flamaque/ANE21_PCB/USB hub van schematic.docx

USB hub van schematic

FSUSB42MUX (https://www.onsemi.com/download/data-sheet/pdf/fsusb42-d.pdf)

Low-Power, Two-Port, High-Speed, USB2.0 (480Mbps) UART Switch

USB2514B-I/M2 (https://ww1.microchip.com/downloads/aemDocuments/documents/UNG/ProductDocuments/DataSheets/USB251xB-xBi-Data-Sheet-DS00001692.pdf)

USB 2.0 Hi-Speed Hub Controller

Abriviations:

HDx_P/HDx_N: (USBDM_DNx/USBDP_DNx) Hi-Speed USB Data

USBDM_UP/USBDP_UP: USB Bus Data (30/31)

XTALIN/XTALOUT: Crystal Input/Output (33/32)

VBUS_DET: Upstream VBUS Power Detection (27)

SUSP_IND: Active/Suspend Status Indicator (28)

HS_IND: Hi-Speed Upstream Port Indicator (25)

SMBDATA: (SDA) System Management Bus Data Signal (22)

SMBCLK: (SCL) System Management Bus Clock (24)

OCS: Over-Current sense (13/17/19/21)

RBIAS: USB Transceiver Bias (35)

Not connected

CRFILT: Core Regulator Filter Capacitor (14)

PLLFILT: PLL Regulator Filter Capacitor (34)

Test: Test pin (11)

BC_EN: Battery charging (12/16/18/20)

RBIAS (https://ww1.microchip.com/downloads/aemDocuments/documents/UNG/ProductDocuments/DataSheets/USB251xB-xBi-Data-Sheet-DS00001692.pdf):

Buffer type: I-R

USB Transceiver Bias: a 12.0 k (+/- 1%) resistor is attached from ground to this

pin to set the transceiver’s internal bias settings.

SCL/CFG_SEL0/SMBCLK

Buffer type: I/OSD12

Configuration Select: the logic state of this multifunction pin is internally latched on the rising edge of RESET_N (RESET_N negation), and will determine the hub configuration method as described in Table 5-1.

SDA/SMBDATA/NON_REM1

Buffer type: I/OSD12

Non-Removable Port 1 Strap Option: when enabled by package and configuration options (see Table 5-1 on page 19), this pin will be sampled (in conjunction with

LOCAL_PWR/SUSP_IND/NON_REM0) at RESET_N negation to determine if ports [x:1] contain permanently attached (non-removable) devices:

NON_REM[1:0] = 00 : all ports are removable

NON_REM[1:0] = 01 : port 1 is non-removable

NON_REM[1:0] = 10 : ports 1 and 2 are non-removable

NON_REM[1:0] = 11 : when available, ports 1, 2, and 3 are non-removable

When NON_REM[1:0] is chosen such that there is a non-removable device, the hub will automatically report itself as a compound device (using the proper descriptors).

SUSP_IND/ LOCAL_PWR/ NON_REM0

Buffer type: IO

Active/Suspend Status LED: indicates USB state of the hub.

Negated = unconfigured; or configured and in USB suspend

Asserted = hub is configured and is active (i.e., not in suspend)

Local Power: detects availability of local self-power source.

Low = self/local power source is NOT available (i.e., the hub gets all power from

the upstream USB VBus)

High = self/local power source is available

Non-Removable 0 Strap Option: when enabled by package and configuration

settings (see Table 5-1 on page 19), this pin will be sampled (in conjunction with

NON_REM[1]) at RESET_N negation to determine if ports [x:1] contain

permanently attached (non-removable) devices:

Note: When implementing an external LED on this pin, the active state is

outlined below and detailed in Section 3.3.1.3, on page 15.

NON_REM[1:0] = 00 : all ports are removable; LED is active high

NON_REM[1:0] = 01 : port 1 is non-removable; LED is active low

NON_REM[1:0] = 10 : ports 1 and 2 are non-removable; LED is active high

NON_REM[1:0] = 11 : (when available) ports 1, 2, and 3 are non-removable; LED

is active low

HS_IND/ CFG_SEL1

Buffer type: I/O12

TPD4EUSB30 (https://www.ti.com/lit/ds/symlink/tpd2eusb30.pdf)

4-Channel ESD Protection for Super-Speed USB 3.0 Interface

AP22653W6 (https://www.diodes.com/datasheet/download/AP22652_AP22653_AP22652A_AP22653A.pdf)

PRECISION ADJUSTABLE CURRENT-LIMITED POWER SWITCHES
