flamaque/ANE21_PCB/ANE21_PCB.docx

Taken:

- PSU voor CM4 vervangen van AP62300WU-7 vervangen met AP64501S-13
- GPIO’s uitzoeken
  - GPIO’s naar header zetten
  - Evt 5v en 3.3v output als header
- Schema en uitleg over ieder circuit dat er in zit
- Nalopen traces (incl. Kennis)
- “lage” signaal pinnen op onderkant zetten

Eventueel:

- USB-C for usb devices, dongle and OTG

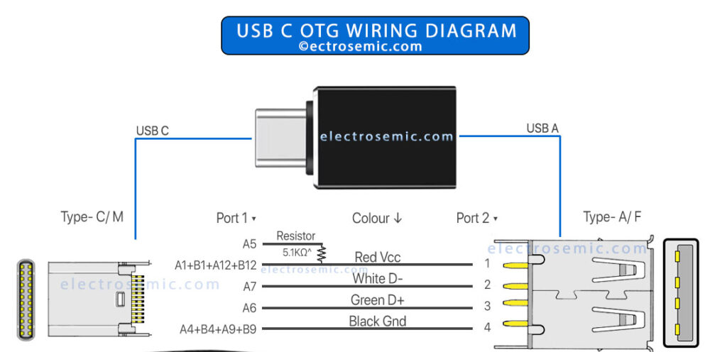
[picture p1: figure]
USB C OTG Wiring Diagram For Cable, Schematic, DIY & Manufacturing -

Update 09/03/2026

- Placed testpoints
- Added header for UART (GPIO 14 and 15)`
- Removed all via’s placed on pads`

Diferential Pair (DP)

1) 6 → Per 45°, houd de lengte van de paren zo gelijk mogelijk
2) Tune DP, match met de langste (Zie eerst welke de langste is)
3) Tune skew of DP`

Click on two places of trace. → Exit → double click: tadaa settings

Aisler

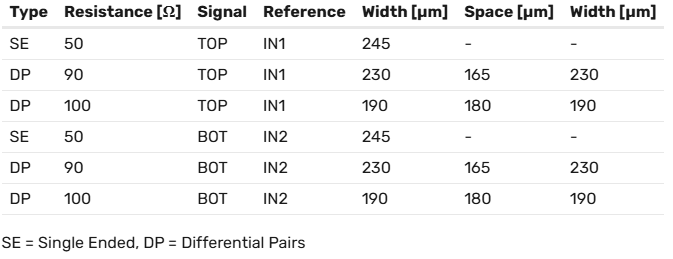
[picture p2: figure]

In KiCad, the difference between coplanar and non-coplanar (often called microstrip or stripline) refers to how a signal trace is referenced to its ground return path regarding their physical plane on the PCB. This distinction is crucial for controlling signal integrity and impedance.

Coplanar (GCPW - Grounded Coplanar Waveguide)

- Definition: The signal trace and its ground reference are on the same layer (e.g., Top Layer).
- Structure: Signal traces are surrounded by a ground pour (GND) on the same layer, providing a "co-planar" return path.
- Use Case: Often used for high-frequency (RF) signals, allowing for better shielding and lower radiation.
- KiCad Calculation: Requires inputting the gap between the trace and the adjacent ground pour.
- Advantage: Can result in narrower traces for the same impedance compared to standard microstrip.

Non-Coplanar (Microstrip/Stripline)

- Definition: The signal trace is on one layer, and its ground reference is on a different layer (usually the layer immediately below).
- Structure: No ground copper is present on the same layer as the signal, or the nearby copper is too far away to act as a primary reference.
- Use Case: Standard differential pair routing for digital signals (USB, Ethernet).
- KiCad Calculation: Uses the distance to the plane below (dielectric thickness).
- Advantage: Easier to calculate and manage, standard design approach.

Summary Table

Feature Coplanar (GCPW) Non-Coplanar (Microstrip)

Ground Location Same Layer as Signal Different Layer (Below)

Primary EMI Defense Coplanar Pour + Vias Ground Plane Below

Impedance Setting Cntrld by Gap to Copper Cntrld by Distance to Plane (H)

Typical Usage High-Frequency RF General High-Speed Digital

KiCad Calculator "Coplanar Waveguide" "Microstrip" or "Stripline"

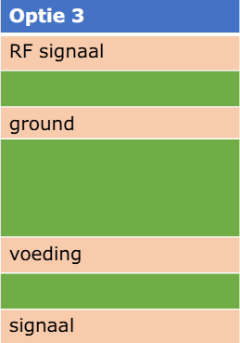
[picture p3: figure]

Keuze voor PCB:
Max 10x10 cm

De PCB bevat minaal:

1. een enkele USB 2.0 poort;

2. een HDMI interface;

3. een NVME Key-M interface.

4. een 5/3.3V DC-DC converter;

5. een manier om te verbinden met de TX, RX pinnen;

6. test points voor tenminste de RUN_PG en LED_nACT pinnen.

7. USB OTG (Als je je eigen CM4 wilt gebruiken)

8. USB C poort

9. Aan/uit knop

10. Fan

Optioneel:

Hardwarematig debugging LED

Ethernet

Scherm (evt touchscreen)

Extra usb poort (of 2 stacked usb) (USB-hub FSUSB42MUX)

Speaker

Audio output

CM4 datasheet (https://pip-assets.raspberrypi.com/categories/634-raspberry-pi-compute-module-4/documents/RP-008168-DS-1-cm4-datasheet.pdf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)

CM4 BOM (https://bytebucket.org/HR_ELEKTRO/ane21/wiki/bestanden/CM4_BOM.pdf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)

Punten verdeling:

• 9 punten voor de realisatie (werkt het pcb?)

• 9 punten voor het high-speed PCB-ontwerp

• 4 punten voor het overige PCB-ontwerp

• 3 punten voor de opzet van het schema

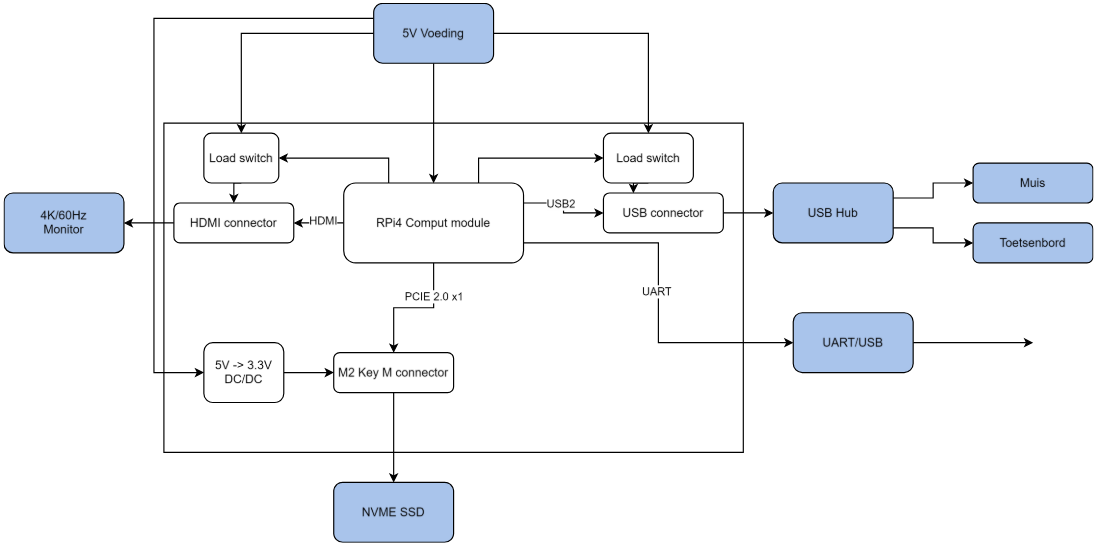
[picture p4: figure]

# Pin definitions per unit

Pinnen: (aantal)

HDMI 12

NVME Key-M 8

USB 2

USB-OTG 2

USB-C x

Overig:

Ethernet 13

14 volgens officiele schematic

TRD0_N / TRD0_P + TRD0_TAP (0 t/m 3) + ETH_LEDG + ETH_LEDY → 14 pins

Component | Aantal | Spanning | Stroom | GPIO | Snelheid
USB 2.0 | 1 | 5v | 500 mA | 2
HDMI | 1 | 5v | N.v.t. | 12
NVME | 1 | 3.3v | 3.3A | 8
USB OTG | 1 | 5v | 500 mA | 2
USB C | 1 | 5v / 20v / 48v | 3A / 5A | N.t.b.
~~Ethernet~~ | ~~1~~ | ~~3.3v (+1/1.2v)~~ | ~~250mA~~ | ~~13~~
CM4 | 1 | 5v | 1.4A | -

Houd pin #93 beschikbaar (nRPIBOOT)

### Voeding

AP62300WU-7 (https://www.diodes.com/assets/Datasheets/AP62300_AP62301_AP62300T.pdf) wordt geleverd door school voor de SSD

AP64501SP-13 (https://www.diodes.com/assets/Datasheets/AP64501.pdf) halen we voor de CM4 voeding

USB / USB_OTG (2.4. USB 2.0 (high speed) datasheet (https://pip-assets.raspberrypi.com/categories/634-raspberry-pi-compute-module-4/documents/RP-008168-DS-1-cm4-datasheet.pdf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))

Name | Pin (CM4) | Pin (connector) | Function
USB_OTG_ID | 101
USBD- | 104
USBD+ | 105
+5v | -
GND | -

Short Pin #4 to Pin #5 (ID/Sense to GND) for OTG

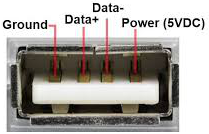
[picture p5: figure]
USB 3.0 Information
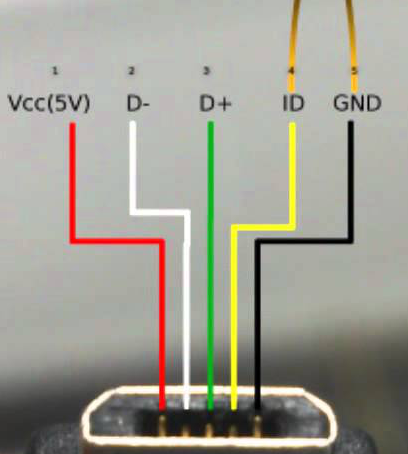
[picture p6: figure]
What is Micro USB OTG (On-The-Go)? Build DIY OTG Cable

HDMI (2.6. Dual HDMI 2.0 in datasheet) (https://pip-assets.raspberrypi.com/categories/634-raspberry-pi-compute-module-4/documents/RP-008168-DS-1-cm4-datasheet.pdf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)

Name | Pin (CM4) | Pin (connector) | Function
HDMI0_D2P | 170 (als P=TX) | 1
HDMI0_D2N | 172 | 3
HDMI0_D1P | 176 | 4
HDMI0_D1N | 178 | 6
HDMI0_D0P | 182 | 7
HDMI0_D0N | 184 | 9
HDMI0_CKP | 180 | 10
HDMI0_CKN | 190 | 12
HDMI0_CEC | 151 | 13
HDMI0_SDA | 199 | 16
HDMI0_SCL | 200 | 15
HDMI0_HOTP | 153 | 19
GND | - | 17
+5v | | 18

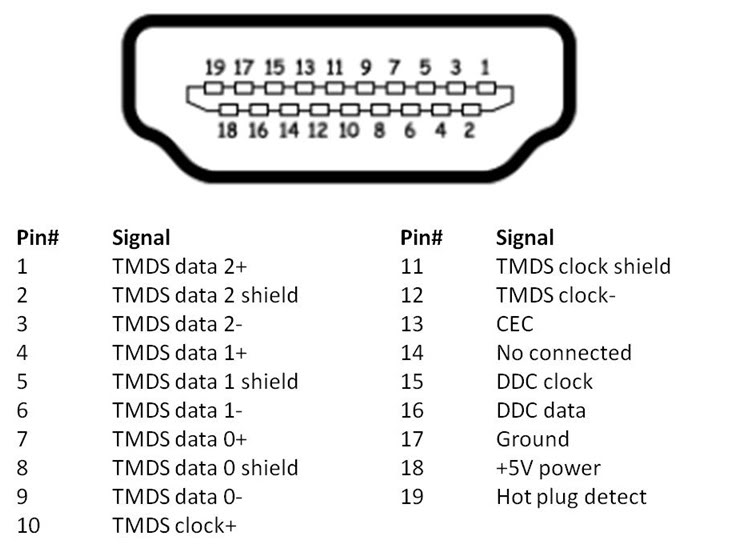
[picture p7: figure]
Does HDMI 2.0 Support 1080p 120Hz? Addressing HDMI Questions ...

NVME (2.3. PCIe (Gen2 x1) Datasheet (https://pip-assets.raspberrypi.com/categories/634-raspberry-pi-compute-module-4/documents/RP-008168-DS-1-cm4-datasheet.pdf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))

Footprint “TE_1-2199119-5” heeft 75 pinnen. Symbol heeft er 36

Gezien de 75 pinnen in de footprint heb ik het schema gebasseerd op de:

Website (https://www.congatec.com/fileadmin/user_upload/Documents/Application_Notes/AN43_M.2_Pinout_Descriptions_and_Reference_Designs.pdf)

(M.2 Connector Pinout (75 Positions))

Name | Pin (CM4) | Pin (connector) | Function
PETn3
PETp3
PERn3
PERp3
PETn2
PETp2
PERn2
PERp2
PETn1
PETp1
PERn1
PERp1
PETn0 | 122 (kicad)
PETp0 | 124 (kicad)
PERn0 | 116 (kicad)
PERp0 | 118 (kicad)
PERST# | 109 (ds)
CLKREQ# | 102 (ds)
REFCLKn | 112 (ds)
PEWWAKE#
REFCLKp | 110 (ds)
INDI LED | 10 (ds)
MFG_DATA
MFG_CLOCK
SUSCLK
PEDET
GND | | 1,3,9,15,21,27,33, 39,45,51,57,71,73,75
3.3v | | 2,4,12,14,16,18,70,72,74
NC | | 6,8,20,22,24,26,28,30,32, 34,36,46,48,56,58,67
NOTCH | | 59-66

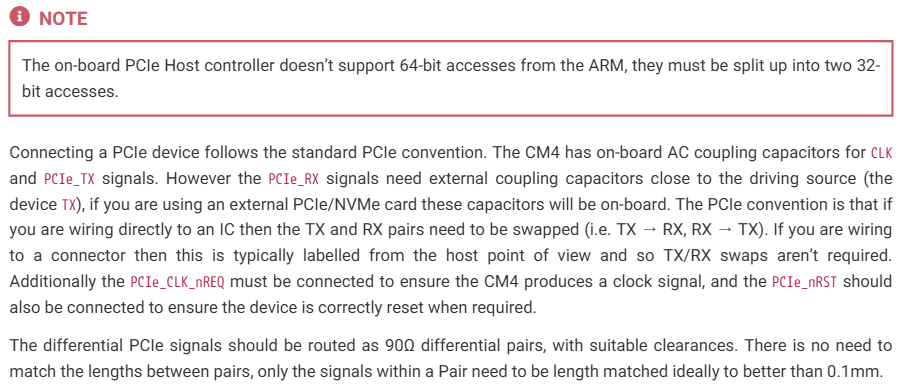
[picture p8: figure]

Ethernet (2.2. Ethernet Datasheet) (https://pip-assets.raspberrypi.com/categories/634-raspberry-pi-compute-module-4/documents/RP-008168-DS-1-cm4-datasheet.pdf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)

Name | Pin (CM4) | Pin (connector) | Function
Ethernet_P3P | 3 | 1
Ethernet_P1P | 4 | 2
Ethernet_P3N | 5 | 3
Ethernet_P1N | 6 | 6
Ethernet_P2N | 9 | 7
Ethernet_P0N | 10 | 8
Ethernet_P2P | 11 | 9
Ethernet_P0P | 12 | 10
Ethernet_LED3 | 15 | 16
Ethernet_SyncIn | 16 | -
Ethernet_LED2 | 17 | 18
Ethernet_SyncOut | 18 | -
Ethernet_LED1 | 19 | -

### USB-C

PD trigger IC

TPS25730D

https://www.ti.com/lit/ds/symlink/tps25730.pdf

# Pinout table

Tabel gebasseerd op wat wij moeten plaatsen:

Chapter 4. Pinout (https://pip-assets.raspberrypi.com/categories/634-raspberry-pi-compute-module-4/documents/RP-008168-DS-1-cm4-datasheet.pdf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)

Pin | | | Signal
1,2,7,8,13,14,22,23,32,33,42,43,52,53,59,60,65,66,71,74,98,107,108,113, 114,119,120, 125,126,131,132,137,138,144,150,155,156,161,162,167, 168,173,174,179,180,185,186,191,192,197,198 | | | GND
Pin | Signal | Pin | Signal
20 | EEPROM_nWP | 84,86 | CM4_3.3V (output)
21 | Pi_nLED_Activity | 88,90 | CM4_1.8V (output)
24 | GPIO26 | 89 | WL_nDisable
25 | GPIO21 | 92 | RUN_PG
26 | GPIO19 | 93 | nRPIBOOT
27 | GPIO20 | 94 | AnalogIP1
28 | GPIO13 | 95 | PI_LED_nPWR
29 | GPIO16 | 96 | AnalogIP0
30 | GPIO6 | 97 | Camera_GPIO
31 | GPIO12 | 99 | GLOBAL_EN
34 | GPIO5 | 100 | nEXTRST
35,36 | ID_SC / ID_SD | 101 | USB_OTG_ID
37 | GPIO7 | 102 | PCIe_CLK_nREQ
38 | GPIO11 | 103 | USB_N
39 | GPIO8 | 105 | USB_P
40 | GPIO9 | 109 | PCIe_nRST
41 | GPIO25 | 110 | PCIe_CLK_P
44 | GPIO10 | 111 | VDAC_COMP
45 | GPIO24 | 112 | PCIe_CLK_N
46 | GPIO22 | 116 | PCIe_RX_P
47 | GPIO23 | 118 | PCIe_RX_N
48 | GPIO27 | 122 | PCIe_TX_P
49 | GPIO18 | 124 | PCIe_TX_N
50 | GPIO17 | 151 | HDMI0_CEC
51 | GPIO15 | 153 | HDMI0_HOTPLUG
54 | GPIO4 | 170 | HDMI0_TX2_P
55 | GPIO14 | 172 | HDMI0_TX2_N
56 | GPIO3 | 176 | HDMI0_TX1_P
58 | GPIO4 | 178 | HDMI0_TX1_N
77,79,81,83,85,87 | +5V (input) | 182 | HDMI0_TX0_P
78 | GPIO_VREF (Can’t be floating) | 184 | HDMI0_TX0_N
80 | SCL0 | 188 | HDMI0_CLK_P
82 | SDA0 | 190 | HDMI0_CLK_N
| | 199,200 | HDMI0 (SDA, SCL)

Chapter 4. Pinout (https://pip-assets.raspberrypi.com/categories/634-raspberry-pi-compute-module-4/documents/RP-008168-DS-1-cm4-datasheet.pdf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)

Pin | Signal
1, 2 | GND
3, 4 | Ethernet_P (3, 1)
5, 6 | Ethernet_N (3, 1)
7,8 | GND
9,10 | Ethernet_N (2, 0)
11,12 | Ethernet_P (2, 0)
13,14 | FND
15 | Ethernet_nLED3
16 | Ethernet_SYNC_IN
17 | Ethernet_nLED2
18 | Ethernet_SYNC_OUT
19 | Ethernet_nLED1
20 | EEPROM_nWP
21 | Pi_nLED_Activity
22,23 | GND
24 | GPIO26
25 | GPIO21
26 | GPIO19
27 | GPIO20
28 | GPIO13
29 | GPIO16
30 | GPIO6
31 | GPIO12
32,33 | GND
34 | GPIO5
35,36 | ID_SC / ID_SD
37 | GPIO7
38 | GPIO11
39 | GPIO8
40 | GPIO9
41 | GPIO25
42,43 | GND
44 | GPIO10
45 | GPIO24
46 | GPIO22
47 | GPIO23
48 | GPIO27
49 | GPIO18
50 | GPIO17
51 | GPIO15
52,53 | GND
54 | GPIO4
55 | GPIO14
56 | GPIO3
57 | SD_CLK
58 | GPIO4
59,60 | GND
61-64 | Only CM4Lite
65,66 | GND
67-70 | Only CM4Lite
71 | GND
72 | Only CM4Lite
73 | SD_VDD_OVERRIDE
74 | GND
75 | Only CM4Lite
76 | Reserverd
77 | +5V (input)
78 | GPIO_VREF
79 | +5V (input)
80 | SCL0
81 | +5V (input)
82 | SDA0
83 | +5V (input)
84 | CM4_3.3V (output)
85 | +5V (input)
86 | CM4_3.3V (output)
87 | +5V (input)
88 | CM4_1.8V (output)
89 | WL_nDisable
90 | CM41.8V (output)
91 | Bt_nDisable
92 | RUN_PG
93 | nRPIBOOT
94 | AnalogIP1
95 | PI_LED_nPWR
96 | AnalogIP0
97 | Camera_GPIO
98 | GND
99 | GLOBAL_EN
100 | nEXTRST
101 | USB_OTG_ID
102 | PCIe_CLK_nREQ
103 | USB_N
104 | Reserved
105 | USB_P
106 | Reserved
107,108 | GND
109 | PCIe_nRST
110 | PCIe_CLK_P
111 | VDAC_COMP
112 | PCIe_CLK_N
113,114 | GND
115 | CAM1_D0_N
116 | PCIe_RX_P
117 | CAM1_D0_P
118 | PCIe_RX_N
119,120 | GND
121 | CAM1_D1_N
122 | PCIe_TX_P
123 | CAM1_D1_P
124 | PCIe_TX_N
125,126 | GND
127 | CAM1_C_N
128 | CAM0_D0_N
129 | CAM1_C_P
130 | CAM0_D0_P
131,132 | GND
133 | CAM1_D2_N
134 | CAM0_D1_N
135 | CAM1_D2_P
136 | CAM0_D1_P
137,138 | GND
139 | CAM1_D3_N
140 | CAM0_C_N
141 | CAM1_D3_P
142 | CAM0_C_P
143 | HDMI1_HOTPLUG
144 | GND
145 | HDMI1_SDA
146 | HDMI1_TX2_P
147 | HDMI1_SCL
148 | HDMI1_TX2_N
149 | HDMI1_CEC
150 | GND
151 | HDMI0_CEC
152 | HDMI1_TX1_P
153 | HDMI0_HOTPLUG
154 | HDMI1_TX1_N
155,156 | GND
157 | DSI0_D0_N
158 | HDMI1_TX0_P
159 | DSI0_D0_P
160 | HDMI1_TX0_N
161,162 | GND
163 | DSI0_D1_N
164 | HDMI1_CLK_P
165 | DSI0_D1_P
166 | HDMI1_CLK_N
167,168 | GND
169 | DSI0_C_N
170 | HDMI0_TX2_P
171 | DSI0_C_P
172 | HDMI0_TX2_N
173,174 | GND
175 | DSI1_D0_N
176 | HDMI0_TX1_P
177 | DSI1_D0_P
178 | HDMI0_TX1_N
179,180 | GND
181 | DSI1_D1_N
182 | HDMI0_TX0_P
183 | DSI1_D1_P
184 | HDMI0_TX0_N
185,186 | GND
187 | DSI1_C_N
188 | HDMI0_CLK_P
189 | DSI1_C_P
190 | HDMI0_CLK_N
191,192 | GND
193,194 | DSI1_Dx_N (2,3)
195,196 | DSI1_Dx_P (2,3)
197,198 | GND
199,200 | HDMI0 (SDA, SCL)

GPIO pinnen die misschien nodig zijn:

CM4 pin | BCM GPIO | Handig voor
24 | GPIO26 | GPIO / extra CS / interrupt
25 | GPIO21 | GPIO / SPI1 SCLK alt
26 | GPIO19 | SPI1 MISO / PWM / GPIO
27 | GPIO20 | SPI1 MOSI / GPIO
28 | GPIO13 | PWM / GPIO
29 | GPIO16 | GPIO / SPI1 CE2 alt
30 | GPIO6 | GPIO / I2C alt
31 | GPIO12 | PWM / GPIO
34 | GPIO5 | GPIO / I2C alt
35 | GPIO1 | I2C0 SCL
36 | GPIO0 | I2C0 SDA
37 | GPIO7 | SPI0 CE1
38 | GPIO11 | SPI0 SCLK
39 | GPIO8 | SPI0 CE0
40 | GPIO9 | SPI0 MISO
41 | GPIO25 | GPIO
44 | GPIO10 | SPI0 MOSI
45 | GPIO24 | GPIO
46 | GPIO22 | GPIO
47 | GPIO23 | GPIO
48 | GPIO27 | GPIO
49 | GPIO18 | SPI1 CE0 / PWM / GPIO
50 | GPIO17 | GPIO / SPI1 CE1 alt
51 | GPIO15 | UART RX
54 | GPIO4 | GPIO / GPCLK / I2C alt
55 | GPIO14 | UART TX
56 | GPIO3 | I2C1 SCL
58 | GPIO2 | I2C1 SDA

# Formules

Presentatie week 2

- HMDI gebruikt 100Ω ±5%
- PCIE 2.0 gebruikt 70Ω - 100 Ω (CM4 wilt 90Ω)
- USB4 gen3 (PCIE 3/4) gebruikt 85Ω ±5%

Het is belangrijk om de impedanties af te stemmen voor zowel de vermogensoverdracht maar ook voor de reflecties.

Signalen zijn dynamisch: v=c/(√(Dk))≈(29.98 (cm)/(ns))/(√4.4)=14.3(cm)/(ns)

met Dk de diëlektrische constante in

Signalen zien een instante impedantie:

Z=V/I=V/(vC_L V)=1/(vC_L^('))

I=(∆Q)/(∆t), ∆t=(∆x)/V en ∆Q=CV

Met:

Z: Complexe impedantie in Ohm met imaginair deel (aΩ + Ωbj)

V: Spanning in volt (V)

I: Stroom in ampere (A)

v: Voortplantingsnelheid in cm/ns

CL/C’L: Capaciteit per lengte-eenheid (Farad per meter of pF/cm) *Niet zeker

Q: Elektrische gelading in coulomb (C)

t: Tijd in seconden (s)

x: Afstand in meter (m)

ρ_(reflectie) =(V_(gereflecteerd))/(V_(inkomend))=(Z_2 -Z_1)/(Z_2 +Z_1)

Met:

L=N/I

V=(dN)/(dt)=L(di)/(dt)

Met:

L: Inductie in Henries (H)

N: Aantal wikkelingen van de spoel

I: Stroom in ampere (A)

V: Spanning in volt (V)

Niet zeker

σ∝f⋅Dk

Met:

σ: Vervorming of spanning/rek

∝: Evenredig aan

f: Deformatiepotentiaal, die de verschuiving in energie van een bandrand per

eenheid rek weergeeft.

Dk: Toestandsdichtheid op het Fermi-niveau

# Copied files from existing kicad and used footprints/symbols

Copied from “CM4_HighSpeed.kicad_sch”

RT9742SNGV

HDMI + powersupply

ComputeModule4 pinout (green)

Copied from “CM4_GPIO.kicad_sch”

Everything except for Ethernet and SDcard slot

Copied all from

“CM4IOv5.kicad_sch”

“PCIe.kicad_sch”

“PSUs.kicad_sch”

“RTC.kicad_sch”

“USB2-HUB.kicad_sch”

“All three folders”

“CM4IOv5.kicad_pcb”

“CM4IO.kicad_sym”

“CM4IOv5.kicad_prl”

“fp-info-cache”

“fp-lib-table”

“sym-lib-table”

“README.TXT”

For the M.2. Key I used 1-2199119-5:

https://www.snapeda.com/parts/1-2199119-5/TE%20Connectivity/view-part/?ref=search&t=1-2199119-5&ab_test_case=b

For the HDMI 10029449-111RLF:

https://www.snapeda.com/parts/10029449-111RLF/AMPHENOL%20ICC%20%2F%20FCI/view-part/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

Must be changed in KiCad File

Diodes AP62300WU-7:

https://www.snapeda.com/parts/AP62300WU-7/Diodes%20Incorporated/view-part/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

Connector DF40C-100DS-0.4V(51):

https://www.snapeda.com/parts/DF40C-100DS-0.4V%2851%29/Hirose/view-part/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

Inductor 1255AY-3R3N=P3:

https://www.snapeda.com/parts/1255AY-3R3N%3DP3/Murata/view-part/?ref=search&t=1255AY-3R3N%3DP3

SMD Capacitor GRM21BR71A106KA73L:

https://www.snapeda.com/parts/GRM21BR71A106KA73L/Murata%20Electronics/view-part/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

Power load switch NCP380HSN05AAT1G:

https://www.snapeda.com/parts/NCP380HSN05AAT1G/ON%20Semiconductor/view-part/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

Symbol

https://www.digikey.co.uk/en/models/2651944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

SMD Capacitor CL10B104KO8NNNC:

https://www.snapeda.com/parts/CL10B104KO8NNNC/Samsung%20Electro-Mechanics/view-part/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

SMD Capacitor CL31B226KPHNNNE:

https://www.snapeda.com/parts/CL31B226KPHNNNE/Samsung%20Electro-Mechanics/view-part/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

Not available on SnapEDA:

SMD Resistor: MCWR06X3322FTL

SMD Resistor: MCMR06X3162FTL

USB: USB-A-S-VT
