flamaque/ANE21_PCB/Extra_Components/ScrewTerminal/2325421.pdf

https://www.phoenixcontact.com/gb/products/1888687

01/12/2017 Page 1 / 6

PCB terminal block - MKDSN 2,5/ 2-5,08 - 1888687 (https://www.phoenixcontact.com/gb/products/1888687)

Please be informed that the data shown in this PDF Document is generated from our Online Catalog. Please find the complete data in the user's documentation. Our General Terms of Use for Downloads are valid
(http://phoenixcontact.com/download)

PCB terminal block, Nominal current: 16 A, Nom. voltage: 400 V, Pitch: 5.08 mm, Number of positions: 2, Connection method: Screw connection with tension sleeve, Mounting: Wave soldering, Conductor/PCB connection direction: 0 °, Color: green, The article can be aligned to create different nos. of positions!

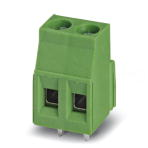
[picture p9: figure]

### Why buy this product

Well-known connection principle allows worldwide use
Low temperature rise, thanks to maximum contact force
Allows connection of two conductors
Extremely small design for the respective conductor cross section
Integrated protective guide prevents incorrect insertion of the conductor underneath the tension sleeve The latching on the side enables various numbers of positions to be combined

## Key Commercial Data

Packing unit | 250 STK

GTIN

GTIN | 4017918157005
Weight per Piece (excluding packing) | 2.890 g
Custom tariff number | 85369010
Country of origin | Germany

## Technical data

### Dimensions

Length | 9.5 mm
Pitch | 5.08 mm
Dimension a | 5.08 mm
Width | 10.16 mm
Constructional height | 15 mm
Height | 18.5 mm
Length of the solder pin | 3.5 mm

01/12/2017 Page 2 / 6

PCB terminal block - MKDSN 2,5/ 2-5,08 - 1888687 (https://www.phoenixcontact.com/gb/products/1888687)

## Technical data

### Dimensions

Pin dimensions | 0,8 x 0,9 mm
Hole diameter | 1.3 mm

### General

Range of articles | MKDSN 2,5
Insulating material group | I
Rated surge voltage (III/3) | 4 kV
Rated surge voltage (III/2) | 4 kV
Rated surge voltage (II/2) | 4 kV
Rated voltage (III/3) | 250 V
Rated voltage (III/2) | 400 V
Rated voltage (II/2) | 630 V
Connection in acc. with standard | EN-VDE
Nominal current IN | 16 A
Nominal cross section | 2.5 mm²
Maximum load current | 16 A (with a 2.5 mm² conductor cross section)
Insulating material | PA
Solder pin surface | Sn
Flammability rating according to UL 94 | V0
Internal cylindrical gage | A3
Stripping length | 6.5 mm
Number of positions | 2
Screw thread | M3
Tightening torque, min | 0.5 Nm
Tightening torque max | 0.6 Nm

### Connection data

Conductor cross section solid min. | 0.2 mm²
Conductor cross section solid max. | 2.5 mm²
Conductor cross section flexible min. | 0.2 mm²
Conductor cross section flexible max. | 2.5 mm²
Conductor cross section flexible, with ferrule without plastic sleeve min. | 0.25 mm²
Conductor cross section flexible, with ferrule without plastic sleeve max. | 2.5 mm²
Conductor cross section flexible, with ferrule with plastic sleeve min. | 0.25 mm²
Conductor cross section flexible, with ferrule with plastic sleeve max. | 2.5 mm²
Conductor cross section AWG min. | 24
Conductor cross section AWG max. | 14
2 conductors with same cross section, solid min. | 0.2 mm²
2 conductors with same cross section, solid max. | 0.75 mm²
2 conductors with same cross section, stranded min. | 0.2 mm²
2 conductors with same cross section, stranded max. | 0.75 mm²

01/12/2017 Page 3 / 6

PCB terminal block - MKDSN 2,5/ 2-5,08 - 1888687 (https://www.phoenixcontact.com/gb/products/1888687)

## Technical data

### Connection data

2 conductors with same cross section, stranded, ferrules without plastic sleeve, min. | 0.25 mm²
2 conductors with same cross section, stranded, ferrules without plastic sleeve, max. | 0.75 mm²
2 conductors with same cross section, stranded, TWIN ferrules with plastic sleeve, min. | 0.5 mm²
2 conductors with same cross section, stranded, TWIN ferrules with plastic sleeve, max. | 1.5 mm²

### Standards and Regulations

Connection in acc. with standard | EN-VDE
| CUL
Flammability rating according to UL 94 | V0

### Environmental Product Compliance

China RoHS | Environmentally Friendly Use Period = 50
| For details about hazardous substances go to tab “Downloads”, Category “Manufacturer's declaration”

## Drawings

Drilling diagram

a 4,75

1,3

5,08

2,54

Dimensional drawing

9,5

4,75 ¹⁵ ³,5

a

a+5,08

2,54 5,08

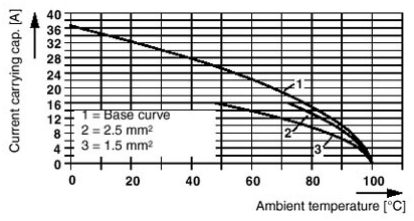
[picture p10: figure]

01/12/2017 Page 4 / 6

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

Diagram

## Classifications

### eCl@ss

eCl@ss 4.0 | 27141109
eCl@ss 4.1 | 27141109
eCl@ss 5.0 | 27141190
eCl@ss 5.1 | 27141190
eCl@ss 6.0 | 27261101
eCl@ss 7.0 | 27440401
eCl@ss 8.0 | 27440401
eCl@ss 9.0 | 27440401

### ETIM

ETIM 3.0 | EC001121
ETIM 4.0 | EC002643
ETIM 5.0 | EC002643
ETIM 6.0 | EC002643

### UNSPSC

UNSPSC 6.01 | 30211801
UNSPSC 7.0901 | 39121432
UNSPSC 11 | 39121432
UNSPSC 12.01 | 39121432
UNSPSC 13.2 | 39121432

## Approvals

### Approvals

01/12/2017 Page 5 / 6

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

## Approvals

Approvals

VDE Gutachten mit Fertigungsüberwachung / EAC / cULus Recognized

Ex Approvals

### Approval details

VDE Gutachten mit

Fertigungsüberwachung | | http://www.vde.com/en/Institute/OnlineService/
VDE-approved-products/Pages/Online-Search.aspx (http://www.vde.com/en/Institute/OnlineService/VDE-approved-products/Pages/Online-Search.aspx) | 40018557
mm²/AWG/kcmil | 0.2-2.5
Nominal current IN | 24 A
Nominal voltage UN | 250 V
EAC | | B.01742
cULus Recognized | http://database.ul.com/cgi-bin/XYV/template/LISEXT/1FRAME/index.htm E60425-19770427
| B | D
mm²/AWG/kcmil | 30-12 | 30-12
Nominal current IN | 20 A | 10 A
Nominal voltage UN | 300 V | 300 V

## Accessories

### Accessories Bridge

Insertion bridge - EBP 2- 5 - 1733169 (https://www.phoenixcontact.com/gb/products/1733169)

Insertion bridge, fully insulated, for connectors with 5.0 or 5.08 mm pitch, no. of positions: 2

### Labeled terminal marker

01/12/2017 Page 6 / 6

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

## Accessories

Marker card - SK 5,08/3,8:FORTL.ZAHLEN - 0804293 (https://www.phoenixcontact.com/gb/products/0804293)

Marker card, Card, white, labeled, Horizontal: Consecutive numbers 1 - 10, 11 - 20, etc. up to 91 - (99)100, Mounting type: Adhesive, for terminal block width: 5.08 mm, Lettering field: 5.08 x 3.8 mm

### Screwdriver tools

Screwdriver - SZS 0,6X3,5 - 1205053 (https://www.phoenixcontact.com/gb/products/1205053)

Actuation tool, for ST terminal blocks, insulated, also suitable for use as a bladed screwdriver, size: 0.6 x 3.5 x 100 mm, 2-component grip, with non-slip grip

Phoenix Contact 2017 © - all rights reserved http://www.phoenixcontact.com
