flamaque/ANE21_PCB/Extra_Components/ch224k/BOM_CH224K-Minimal_2025-12-29.csv

ID | Name | Designator | Footprint | Quantity | Manufacturer Part | Manufacturer | Supplier | Supplier Part | Price
1 | 10kΩ | CFG3,CFG1,CFG2,R4 | R0603 | 4 | 0603WAF1002T5E | UNI-ROYAL(厚声) | LCSC | C25804 | 0.001
2 | 0Ω | CF1,CF2,CF3 | R0603 | 3 | 0603 ±1% 0Ω | VO(翔胜) | LCSC | C2889381 | 0.001
3 | 1uF | C8,C2,C6 | C0603 | 3 | CL10A105KB8NNNC | SAMSUNG(三星) | LCSC | C15849 | 0.005
4 | 100nF | C4,C5 | C0603 | 2 | CC0603KRX7R9BB104 | YAGEO(国巨) | LCSC | C14663 | 0.003
5 | 10uF | C7 | C0603 | 1 | CL10A106KP8NNNC | SAMSUNG(三星) | LCSC | C19702 | 0.006
6 | 19-213/Y2C-CQ2R2L/3T(CY) | LED2 | LED0603-RD-YELLOW | 1 | 19-213/Y2C-CQ2R2L/3T(CY) | EVERLIGHT(亿光) | LCSC | C72038 | 0.021
7 | 1kΩ | R2,R8 | R0603 | 2 | 0603WAF1001T5E | UNI-ROYAL(厚声) | LCSC | C21190 | 0.001
8 | CH224K | U1 | ESSOP-10_L4.9-W3.9-P1.0-LS6.0-TL-EP | 1 | CH224K | WCH(南京沁恒) | LCSC | C970725 | 0.52
9 | HOLE | U2,U4 | HOLE | 2
10 | TYPE-C 16PF | U7 | USB-C-SMD_TYPE-C-USB-5 | 1 | TYPE-C 16PF | null | LCSC | C2835121
