flamaque/ANE21_PCB/ANE21_PCB_NogTeHalen.csv.xlsx

Sheet: ANE21_PCB
Reference | Qty | Value | DNP | Exclude from BOM | Exclude from Board | Footprint | Datasheet
C1,C2 | 2 | C |  |  |  | Capacitor_SMD:C_0402_1005Metric_Pad0.74x0.62mm_HandSolder | ~
C3 | 1 | 1ÂµF |  |  |  | Capacitor_SMD:C_0402_1005Metric_Pad0.74x0.62mm_HandSolder | ~
C6,C11 | 2 | 10uF |  |  |  | Capacitor_SMD:C_0402_1005Metric_Pad0.74x0.62mm_HandSolder | ~
C7,C12 | 2 | 100nF |  |  |  | Capacitor_SMD:C_0402_1005Metric_Pad0.74x0.62mm_HandSolder | ~
C8,C13 | 2 | 10pF |  |  |  | Capacitor_SMD:C_0402_1005Metric_Pad0.74x0.62mm_HandSolder | ~
C9,C10,C14,C15 | 4 | 22uF |  |  |  | Capacitor_SMD:C_0402_1005Metric_Pad0.74x0.62mm_HandSolder | ~
D1,D3,D4 | 3 | LED |  |  |  | LED_SMD:LED_0603_1608Metric | ~
D2 | 1 | SMBJ14A |  |  |  | SMBJ14A:DIOM5436X261N
J1 | 1 | 1-2199119-5 |  |  |  | lib:TE_1-2199119-5
J2 | 1 | USB4105-GF-A |  |  |  | USB4105-GF-A:GCT_USB4105-GF-A
J3 | 1 | USB-A-S-VT |  |  |  | CONN_USB-A-S-VT_ADM | USB-A-S-VT
J4 | 1 | HDMI_A_1.4 |  |  |  | HMDI:AMPHENOL_10029449-111RLF | https://en.wikipedia.org/wiki/HDMI
J5 | 1 | Conn_02x05_Odd_Even |  |  |  | Connector_PinHeader_2.54mm:PinHeader_2x05_P2.54mm_Vertical | ~
J6 | 1 | Conn_01x02 |  |  |  | 1-2199119-5_Finley:TerminalBlock_PhoenixTerminalBlock_Phoenix_MKDS-1,5-2-5.08_1x02_P5.08mm_Horizontal_Edited | ~
J7 | 1 | USB4105-GF-A |  |  |  | USB4105-GF-A:GCT_USB4105-GF-A
J8 | 1 | Conn_02x06_Odd_Even |  |  |  | Connector_PinHeader_2.54mm:PinHeader_2x06_P2.54mm_Vertical | ~
L1,L2 | 2 | 3.3uH |  |  |  | 1255AY-3R3N_P3:IND_1255AY-3R3N=P3 | ~
Module1 | 1 | ComputeModule4-CM4 |  |  |  | CM4IO:Raspberry-Pi-4-Compute-Module
R2,R3,R6,R13 | 4 | R |  |  |  | Resistor_SMD:R_0402_1005Metric_Pad0.72x0.64mm_HandSolder | ~
R4,R5 | 2 | R_Small |  |  |  | Resistor_SMD:R_0402_1005Metric_Pad0.72x0.64mm_HandSolder | ~
R7 | 1 | 10K |  |  |  | Resistor_SMD:R_0402_1005Metric_Pad0.72x0.64mm_HandSolder | ~
R9 | 1 | 52.3k |  |  |  | Resistor_SMD:R_0402_1005Metric_Pad0.72x0.64mm_HandSolder | ~
R10,R12 | 2 | 10k |  |  |  | Resistor_SMD:R_0402_1005Metric_Pad0.72x0.64mm_HandSolder | ~
R11 | 1 | 31.6k |  |  |  | Resistor_SMD:R_0402_1005Metric_Pad0.72x0.64mm_HandSolder | ~
SW1,SW2,SW3 | 3 | SW_Push |  |  |  | Button_Switch_SMD:SW_SPST_TS-1088-xR020 | ~
TP1,TP2,TP3,TP4,TP5,TP6 | 6 | TestPoint |  |  |  | TestPoint:TestPoint_Pad_2.0x2.0mm | ~
U1 | 1 | SI-51005-F |  |  |  | lib:BEL_SI-51005-F | https://www.belfuse.com/products/ethernet/magjacks-icms/si-51005-f
U2,U3,U4 | 3 | PUSB3FR4 |  |  |  | lib:SOT1176-1 | https://www.nexperia.com/product/PUSB3FR4
U5 | 1 | NCP380HSN05AAT1G |  |  |  | TSOP-5_ONS | NCP380HSN05AAT1G
U6 | 1 | HUSB238_xxxDD |  |  |  | Package_DFN_QFN:WDFN-10-1EP_3x3mm_P0.5mm_EP1.8x2.5mm | https://cdn-learn.adafruit.com/assets/assets/000/125/150/original/husb238_datasheet_full.pdf
U7,U8 | 2 | AP62300WU-7 |  |  |  | AP62300WU-7:SOT95P280X100-6N
U9,U10 | 2 | 74LVC1G07_copy |  |  |  | Package_TO_SOT_SMD:SOT-353_SC-70-5 | http://www.ti.com/lit/sg/scyt129e/scyt129e.pdf

Sheet: PerSide
PCIe side
C1,C2 | 2 | C | Capacitor_SMD:C_0402_1005Metric_Pad0.74x0.62mm_HandSolder
C3 | 1 | 1ÂµF | Capacitor_SMD:C_0402_1005Metric_Pad0.74x0.62mm_HandSolder
C6,C11 | 2 | 10uF | Capacitor_SMD:C_0402_1005Metric_Pad0.74x0.62mm_HandSolder
C7,C12 | 2 | 100nF | Capacitor_SMD:C_0402_1005Metric_Pad0.74x0.62mm_HandSolder
C8,C13 | 2 | 10pF | Capacitor_SMD:C_0402_1005Metric_Pad0.74x0.62mm_HandSolder
C9,C10,C14,C15 | 4 | 22uF | Capacitor_SMD:C_0402_1005Metric_Pad0.74x0.62mm_HandSolder
D1,D3,D4 | 3 | LED | LED_SMD:LED_0603_1608Metric
D2 | 1 | SMBJ14A | SMBJ14A:DIOM5436X261N
J2 | 1 | USB4105-GF-A | USB4105-GF-A:GCT_USB4105-GF-A
J3 | 1 | USB-A-S-VT | CONN_USB-A-S-VT_ADM
J5 | 1 | Conn_02x05_Odd_Even | Connector_PinHeader_2.54mm:PinHeader_2x05_P2.54mm_Vertical
J6 | 1 | Conn_01x02 | 1-2199119-5_Finley:TerminalBlock_PhoenixTerminalBlock_Phoenix_MKDS-1,5-2-5.08_1x02_P5.08mm_Horizontal_Edited
J7 | 1 | USB4105-GF-A | USB4105-GF-A:GCT_USB4105-GF-A
J8 | 1 | Conn_02x06_Odd_Even | Connector_PinHeader_2.54mm:PinHeader_2x06_P2.54mm_Vertical
L1,L2 | 2 | 3.3uH | 1255AY-3R3N_P3:IND_1255AY-3R3N=P3
R2,R3,R6,R13 | 4 | R | Resistor_SMD:R_0402_1005Metric_Pad0.72x0.64mm_HandSolder
R4,R5 | 2 | R_Small | Resistor_SMD:R_0402_1005Metric_Pad0.72x0.64mm_HandSolder
R7 | 1 | 10K | Resistor_SMD:R_0402_1005Metric_Pad0.72x0.64mm_HandSolder
R9 | 1 | 52.3k | Resistor_SMD:R_0402_1005Metric_Pad0.72x0.64mm_HandSolder
R10,R12 | 2 | 10k | Resistor_SMD:R_0402_1005Metric_Pad0.72x0.64mm_HandSolder
R11 | 1 | 31.6k | Resistor_SMD:R_0402_1005Metric_Pad0.72x0.64mm_HandSolder
SW1,SW2,SW3 | 3 | SW_Push | Button_Switch_SMD:SW_SPST_TS-1088-xR020
U1 | 1 | SI-51005-F | lib:BEL_SI-51005-F

Sheet: Sheet1
Reference | Qty | Value | Footprint
Niet zeker welke waarde dit moet zijn, of waar dit schema überhaupt vandaan komt
R3 | 2 | R | Resistor_SMD:R_0402_1005Metric_Pad0.72x0.64mm_HandSolder
Niet zeker welke waarde dit moet zijn.
C2 | 1 | C | Capacitor_SMD:C_0402_1005Metric_Pad0.74x0.62mm_HandSolder
Nog te halen
Reference | Qty | Value | Footprint
L2 | 2 | 3.3uH | 1255AY-3R3N_P3:IND_1255AY-3R3N=P3 | https://nl.farnell.com/en-NL/murata/1255ay-3r3n-p3/inductor-3-3uh-4-4a-30-wirewound/dp/2871551
D1 | 1 | LED (nEXTRST) | LED_SMD:LED_0603_1608Metric | https://nl.farnell.com/en-NL/dialight/599-1080-147f/led-green-285mcd-525nm-0603/dp/4757815
D3 | 1 | LED (PI_nLED_Activity) | LED_SMD:LED_0603_1608Metric | https://nl.farnell.com/en-NL/dialight/599-1090-147f/led-blue-72mcd-470nm-0603/dp/4757817
D4 | 1 | LED (nPWRLED ) | LED_SMD:LED_0603_1608Metric | https://nl.farnell.com/en-NL/broadcom/hsmh-h190/led-red-639nm-7-2mcd-0603/dp/3958226
D2 | 1 | SMBJ14A | SMBJ14A:DIOM5436X261N | https://nl.farnell.com/en-NL/search?st=SMBJ14A
J5 | 1 | Conn_02x05_Odd_Even | Connector_PinHeader_2.54mm:PinHeader_2x05_P2.54mm_Vertical | https://nl.farnell.com/en-NL/amphenol-fci/10129381-910004blf/btb-conn-header-10pos-2row-2-54mm/dp/3497346
J8 | 1 | Conn_02x06_Odd_Even | Connector_PinHeader_2.54mm:PinHeader_2x06_P2.54mm_Vertical | https://nl.farnell.com/en-NL/multicomp-pro/2213s-12g/header-2-row-vert-12way/dp/1593443
SW1,SW2,SW3 | 3 | SW_Push | Button_Switch_SMD:SW_SPST_TS-1088-xR020 | https://nl.farnell.com/en-NL/alps-alpine/skqmare010/tactile-switch-0-05a-12vdc-smd/dp/3261817
J6 | 1 | Conn_01x02 | TerminalBlock_Phoenix_MKDS-1,5-2-5.08_1x02_P5.08mm_Horizontal_Edited | https://nl.farnell.com/en-NL/phoenix-contact/mkdsn2-5-2-5-08/terminal-block-wire-to-brd-2pos/dp/1792766
Ligt hoogstwaarschijnlijk op school
C6 | 1 | 10uF | Capacitor_SMD:C_0402_1005Metric_Pad0.74x0.62mm_HandSolder
C7 | 1 | 100nF | Capacitor_SMD:C_0402_1005Metric_Pad0.74x0.62mm_HandSolder
C9,C10 | 2 | 22uF | Capacitor_SMD:C_0402_1005Metric_Pad0.74x0.62mm_HandSolder
C8,C13 | 2 | 10pF | Capacitor_SMD:C_0402_1005Metric_Pad0.74x0.62mm_HandSolder
R7,R10,R12 | 2 | 10k | Resistor_SMD:R_0402_1005Metric_Pad0.72x0.64mm_HandSolder
R9 | 1 | 52.3k | Resistor_SMD:R_0402_1005Metric_Pad0.72x0.64mm_HandSolder
C1 | 1 | 10uF | Capacitor_SMD:C_0402_1005Metric_Pad0.74x0.62mm_HandSolder
R6 | 1 | 100k | Resistor_SMD:R_0402_1005Metric_Pad0.72x0.64mm_HandSolder
C3 | 1 | 1ÂµF | Capacitor_SMD:C_0402_1005Metric_Pad0.74x0.62mm_HandSolder
R3, R13 | 1 | 1k | Resistor_SMD:R_0402_1005Metric_Pad0.72x0.64mm_HandSolder
R4,R5 | 2 | 470 | Resistor_SMD:R_0402_1005Metric_Pad0.72x0.64mm_HandSolder
 |  |  |  | Aantal zelf gehaald
Zelf besteld |  |  |  | 11
Reference | Qty | Value | Footprint | 5
U7 | 1 | AP62300WU-7 | AP62300WU-7:SOT95P280X100-6N | 10
U6 | 1 | HUSB238_xxxDD | Package_DFN_QFN:WDFN-10-1EP_3x3mm_P0.5mm_EP1.8x2.5mm | 30
J2,J7 | 1 | USB4105-GF-A | USB4105-GF-A:GCT_USB4105-GF-A | 1
U2,U3,U4 | 3 | PUSB3FR4 | lib:SOT1176-1 | 10
U1 | 1 | SI-51005-F | lib:BEL_SI-51005-F
U9,U10 | 2 | 74LVC1G07 | Package_TO_SOT_SMD:SOT-353_SC-70-5
Van school
Reference | Qty | Value | Footprint
U8 | 1 | AP62300WU-7 | AP62300WU-7:SOT95P280X100-6N
C11 | 1 | 10uF | Capacitor_SMD:C_0402_1005Metric_Pad0.74x0.62mm_HandSolder
C12 | 1 | 100nF | Capacitor_SMD:C_0402_1005Metric_Pad0.74x0.62mm_HandSolder
C14,C15 | 2 | 22uF | Capacitor_SMD:C_0402_1005Metric_Pad0.74x0.62mm_HandSolder
R11 | 1 | 31.6k | Resistor_SMD:R_0402_1005Metric_Pad0.72x0.64mm_HandSolder
L1 | 2 | 3.3uH | 1255AY-3R3N_P3:IND_1255AY-3R3N=P3
J3 | 1 | USB-A-S-VT | CONN_USB-A-S-VT_ADM
Module1 | 1 | ComputeModule4-CM4 | CM4IO:Raspberry-Pi-4-Compute-Module
U5 | 1 | NCP380HSN05AAT1G | TSOP-5_ONS
J4 | 1 | HDMI_A_1.4 | HMDI:AMPHENOL_10029449-111RLF
J1 | 1 | 1-2199119-5 | lib:TE_1-2199119-5
`Footprint diode checken
Ander knopske
LED uitzoeken

Sheet: Sheet3
 | Eén PCB
Reference | Qty | Nodig | Value | Footprint
L2 | 2 | 7 | 3.3uH | 1255AY-3R3N_P3:IND_1255AY-3R3N=P3 | https://nl.farnell.com/en-NL/murata/1255ay-3r3n-p3/inductor-3-3uh-4-4a-30-wirewound/dp/2871551
D1 | 1 | 10 | LED (nEXTRST) | LED_SMD:LED_0603_1608Metric | https://nl.farnell.com/en-NL/dialight/599-1080-147f/led-green-285mcd-525nm-0603/dp/4757815
D3 | 1 | 10 | LED (PI_nLED_Activity) | LED_SMD:LED_0603_1608Metric | https://nl.farnell.com/en-NL/dialight/599-1090-147f/led-blue-72mcd-470nm-0603/dp/4757817
D4 | 1 | 10 | LED (nPWRLED ) | LED_SMD:LED_0603_1608Metric | https://nl.farnell.com/en-NL/broadcom/hsmh-h190/led-red-639nm-7-2mcd-0603/dp/3958226
D2 | 1 | 10 | SMBJ14A | SMBJ14A:DIOM5436X261N | https://nl.farnell.com/en-NL/search?st=SMBJ14A
J5 | 1 | 10 | Conn_02x05_Odd_Even | Connector_PinHeader_2.54mm:PinHeader_2x05_P2.54mm_Vertical | https://nl.farnell.com/en-NL/amphenol-fci/10129381-910004blf/btb-conn-header-10pos-2row-2-54mm/dp/3497346
J8 | 1 | 10 | Conn_02x06_Odd_Even | Connector_PinHeader_2.54mm:PinHeader_2x06_P2.54mm_Vertical | https://nl.farnell.com/en-NL/multicomp-pro/2213s-12g/header-2-row-vert-12way/dp/1593443
SW1,SW2,SW3 | 3 | 10 | SW_Push | Button_Switch_SMD:SW_SPST_TS-1088-xR020 | https://nl.farnell.com/alcoswitch-te-connectivity/147873-1/tactile-switch-spst-0-05a-24v/dp/2610942
J6 | 1 | 0 | Conn_01x02 | TerminalBlock_Phoenix_MKDS-1,5-2-5.08_1x02_P5.08mm_Horizontal_Edited | https://nl.farnell.com/en-NL/phoenix-contact/mkdsn2-5-2-5-08/terminal-block-wire-to-brd-2pos/dp/1792766

Sheet: Sheet2
L2 | 2 | 3.3uH | 1255AY-3R3N_P3:IND_1255AY-3R3N=P3 | https://www.tme.eu/nl/en/details/mpp2/bwvs006060453r3m-0/yageo/bwvs006060453r3m00/
D1,D3,D4 | 3 | LED | LED_SMD:LED_0603_1608Metric
D2 | 1 | SMBJ14A | SMBJ14A:DIOM5436X261N | https://www.tme.eu/nl/en/details/smbj14a-lf/unidirectional-tvs-smd-diodes/littelfuse/smbj14a/
J5 | 1 | Conn_02x05_Odd_Even | Connector_PinHeader_2.54mm:PinHeader_2x05_P2.54mm_Vertical | https://www.tme.eu/nl/en/details/zl202-10g/pin-headers/connfly/ds1021-2-5sf11-b/
J8 | 1 | Conn_02x06_Odd_Even | Connector_PinHeader_2.54mm:PinHeader_2x06_P2.54mm_Vertical | https://www.tme.eu/nl/en/details/77313-818-12lf/pin-headers/amphenol-communications-solutions/
SW1,SW2,SW3 | 3 | SW_Push | Button_Switch_SMD:SW_SPST_TS-1088-xR020 | https://www.tme.eu/nl/en/details/skqmase010/microswitches-tact/alps/
J6 | 1 | Conn_01x02 | TerminalBlock_Phoenix_MKDS-1,5-2-5.08_1x02_P5.08mm_Horizontal_Edited | https://www.tme.eu/nl/en/details/mkdsn2.5_2-5.08/pcb-terminal-blocks/phoenix-contact/1888687/
D1 (activity?) |  | nEXTRST | https://www.tme.eu/nl/en/details/ll-s192bc-b4-1ag/smd-colour-leds/luckylight/s192bc-b4-1ag/
D3 (activity?) |  | PI_nLED_Activity | https://www.tme.eu/nl/en/details/ll-s192pgc-g5-1ag/smd-colour-leds/luckylight/s192pgc-g5-1ag/
D4 (pwr LED) |  | nPWRLED | https://www.tme.eu/nl/en/details/ll-s192vc-1bg/smd-colour-leds/luckylight/s192vc-1bg/
