flamaque/ANE21_PCB/ANE21_PCB.csv.xlsx

Sheet: ANE21_PCB
Reference | Qty | Value | Footprint | Datasheet
J2,J5 | 2 | USB4105-GF-A | USB4105-GF-A:GCT_USB4105-GF-A
J6 | 1 | Conn_01x02 | TerminalBlock_Phoenix:TerminalBlock_Phoenix_MKDS-1,5-2-5.08_1x02_P5.08mm_Horizontal | ~
J7,J8 | 2 | Conn_02x07_Odd_Even | Connector_PinHeader_2.54mm:PinHeader_2x07_P2.54mm_Vertical | ~
L1,L2 | 2 | 3,3uH | Inductor_SMD:L_0603_1608Metric | ~
U1 | 1 | SI-51005-F | lib:BEL_SI-51005-F
U2,U3,U4 | 3 | PUSB3FR4 | lib:SOT1176-1 | https://www.nexperia.com/product/PUSB3FR4
U7,U8 | 2 | AP62300WU-7 | AP62300WU-7:SOT95P280X100-6N
U9,U10 | 2 | 74LVC1G07SE-7 | Package_TO_SOT_SMD:SOT-353_SC-70-5 | https://www.diodes.com/assets/Datasheets/74LVC1G07.pdf
Van school
J1 | 1 | 1-2199119-5 | M2Key:TE_1-2199119-5
J3 | 1 | USB-A-S-VT | USB-A-S-VT:CONN_USB-A-S-VT_ADM | USB-A-S-VT
Module1 | 1 | ComputeModule4-CM4 | ComputeModule4:Raspberry-Pi-4-Compute-Module
J4 | 1 | 690-019-298-412 | HMDI:AMPHENOL_10029449-111RLF | https://www.tme.eu/Document/f15dffbcfad8545e17826f72d36911c8/206A-SEAN-R03.pdf
U5 | 1 | NCP380HSN05AAT1G | NCP380HSN05AAT1G:SOT95P275X120-5N | NCP380HSN05AAT1G
Overig
C1,C6,C7 | 3 | 100nF | Capacitor_SMD:C_0402_1005Metric_Pad0.74x0.62mm_HandSolder | ~
C2 | 1 | 22ÂµF | Capacitor_SMD:C_0402_1005Metric_Pad0.74x0.62mm_HandSolder | ~
C3 | 1 | 1ÂµF | Capacitor_SMD:C_0402_1005Metric_Pad0.74x0.62mm_HandSolder | ~
C4,C5 | 2 | 10ÂµF | Capacitor_SMD:C_0402_1005Metric_Pad0.74x0.62mm_HandSolder | ~
C8,C9 | 2 | 10pF | Capacitor_SMD:C_0402_1005Metric_Pad0.74x0.62mm_HandSolder | ~
C10,C11,C12,C13 | 4 | 22uF | Capacitor_SMD:C_0402_1005Metric_Pad0.74x0.62mm_HandSolder | ~
C14 | 1 | 100n | Capacitor_SMD:C_0402_1005Metric_Pad0.74x0.62mm_HandSolder | https://search.murata.co.jp/Ceramy/image/img/A01X/G101/ENG/GRM155R71C104KA88-01.pdf
C57 | 1 | 10u | Capacitor_SMD:C_0402_1005Metric_Pad0.74x0.62mm_HandSolder | https://search.murata.co.jp/Ceramy/image/img/A01X/G101/ENG/GRM155R71C104KA88-01.pdf
D1,D3 | 2 | LED Green | LED_SMD:LED_0603_1608Metric | http://optoelectronics.liteon.com/upload/download/DS22-2000-226/LTST-S270KGKT.pdf
D4 | 1 | LED Red | LED_SMD:LED_0603_1608Metric | http://optoelectronics.liteon.com/upload/download/DS22-2000-210/LTST-S270KRKT.pdf
R1,R4,R6 | 3 | 10K | Resistor_SMD:R_0402_1005Metric_Pad0.72x0.64mm_HandSolder | ~
R2 | 1 | 22.6K | Resistor_SMD:R_0402_1005Metric_Pad0.72x0.64mm_HandSolder | ~
R3 | 1 | 31,6K | Resistor_SMD:R_0402_1005Metric_Pad0.72x0.64mm_HandSolder | ~
R5 | 1 | 52,3K | Resistor_SMD:R_0402_1005Metric_Pad0.72x0.64mm_HandSolder | ~
R7 | 1 | 10k | Resistor_SMD:R_0402_1005Metric_Pad0.72x0.64mm_HandSolder | https://fscdn.rohm.com/en/products/databook/datasheet/passive/resistor/chip_resistor/mcr-e.pdf
R8,R23,R26 | 3 | 1k | Resistor_SMD:R_0402_1005Metric_Pad0.72x0.64mm_HandSolder | https://fscdn.rohm.com/en/products/databook/datasheet/passive/resistor/chip_resistor/mcr-e.pdf
R9 | 1 | 100k |  | ~
R15,R16 | 2 | 330 | Resistor_SMD:R_0402_1005Metric_Pad0.72x0.64mm_HandSolder | ~
U6 | 1 | HUSB238_xxxDD | Package_DFN_QFN:WDFN-10-1EP_3x3mm_P0.5mm_EP1.8x2.5mm | https://cdn-learn.adafruit.com/assets/assets/000/125/150/original/husb238_datasheet_full.pdf

Sheet: Sheet2
FabrikantNr | Name
MCWR06X3322FTL | 33.2k R
Geplaatst
AP62300WU-7 | DC-DC converter
1255AY-3R3N=P3 | 3.3uH L
GRM21BR71A106KA73L | 10 uF C
CL10B104KO8NNNC | 0.1uF C
CL31B226KPHNNNE | 22 uF C
MCMR06X3162FTL | 31.6k R
NCP380HSN05AAT1G | HDMI Load switch
USB-A-S-VT | USB A
DF40C-100DS-0.4V(51) | CM4 header
10029449-111RLF | HDMI connector
1-2199119-5 | PCIe connector

Sheet: Sheet1
Reference | Qty | Name | Value | Footprint | Datasheet
J2,J5 | 2 |  | USB4105-GF-A | USB4105-GF-A:GCT_USB4105-GF-A
J6 | 1 |  | Conn_01x02 | TerminalBlock_Phoenix:TerminalBlock_Phoenix_MKDS-1,5-2-5.08_1x02_P5.08mm_Horizontal | ~
J7,J8 | 2 |  | Conn_02x07_Odd_Even | Connector_PinHeader_2.54mm:PinHeader_2x07_P2.54mm_Vertical | ~
L1,L2 | 2 |  | 3,3uH | Inductor_SMD:L_0603_1608Metric | ~
U1 | 1 |  | SI-51005-F | lib:BEL_SI-51005-F
U2,U3,U4 | 3 |  | PUSB3FR4 | lib:SOT1176-1 | https://www.nexperia.com/product/PUSB3FR4
U7,U8 | 2 |  | AP62300WU-7 | AP62300WU-7:SOT95P280X100-6N
U9,U10 | 2 |  | 74LVC1G07SE-7 | Package_TO_SOT_SMD:SOT-353_SC-70-5 | https://www.diodes.com/assets/Datasheets/74LVC1G07.pdf
Van school
J1 | 1 | PCIe connector | 1-2199119-5 | M2Key:TE_1-2199119-5
J3 | 1 | USB A | USB-A-S-VT | USB-A-S-VT:CONN_USB-A-S-VT_ADM | USB-A-S-VT
Module1 | 1 | CM4 | ComputeModule4-CM4 | ComputeModule4:Raspberry-Pi-4-Compute-Module
J4 | 1 | HDMI connector | 690-019-298-412 | HMDI:AMPHENOL_10029449-111RLF | https://www.tme.eu/Document/f15dffbcfad8545e17826f72d36911c8/206A-SEAN-R03.pdf
U5 | 1 | HDMI Load switch | NCP380HSN05AAT1G | NCP380HSN05AAT1G:SOT95P275X120-5N | NCP380HSN05AAT1G
 |  | CM4 header | DF40C-100DS-0.4V(51)
