flamaque/ANE21_PCB/Book1.xlsx

Reference | Qty | Value | DNP | Exclude from BOM | Exclude from Board | Footprint | Datasheet
J1 | 1 | Conn_01x02 |  |  |  | TerminalBlock_Phoenix:TerminalBlock_Phoenix_MKDS-1,5-2-5.08_1x02_P5.08mm_Horizontal | ~
J4,J6 | 2 | Conn_02x07_Odd_Even |  |  |  | Connector_PinHeader_2.54mm:PinHeader_2x07_P2.54mm_Vertical | ~
J7,J8 | 2 | USB4105-GF-A |  |  |  | USB4105-GF-A:GCT_USB4105-GF-A
L1,L2 | 2 | 3,3uH |  |  |  | Inductor_SMD:L_0603_1608Metric | ~
U1,U2 | 2 | 74LVC1G07SE-7 |  |  |  | Package_TO_SOT_SMD:SOT-353_SC-70-5 | https://www.diodes.com/assets/Datasheets/74LVC1G07.pdf
U4,U8 | 2 | AP62300WU-7 |  |  |  | AP62300WU-7:SOT95P280X100-6N
U6,U9,U10 | 3 | PUSB3FR4 |  |  |  | lib:SOT1176-1 | https://www.nexperia.com/product/PUSB3FR4
U11 | 1 | TPD4EUSB30 |  |  |  | Package_SON:USON-10_2.5x1.0mm_P0.5mm | http://www.ti.com/lit/ds/symlink/tpd2eusb30a.pdf
U12 | 1 | SI-51005-F |  |  |  | lib:BEL_SI-51005-F
U3 | 1 | HUSB238_xxxDD |  |  |  | Package_DFN_QFN:WDFN-10-1EP_3x3mm_P0.5mm_EP1.8x2.5mm | https://cdn-learn.adafruit.com/assets/assets/000/125/150/original/husb238_datasheet_full.pdf
Zelf halen
J1 | 1 | Conn_01x02 |  |  |  | TerminalBlock_Phoenix:TerminalBlock_Phoenix_MKDS-1,5-2-5.08_1x02_P5.08mm_Horizontal | ~
J4,J6 | 2 | Conn_02x07_Odd_Even |  |  |  | Connector_PinHeader_2.54mm:PinHeader_2x07_P2.54mm_Vertical | ~
L1,L2 | 2 | 3,3uH |  |  |  | Inductor_SMD:L_0603_1608Metric | ~
