flamaque/ANE21_PCB/Extra_Components/3D-Models/MKDS 1_ 2-3.81.STEP

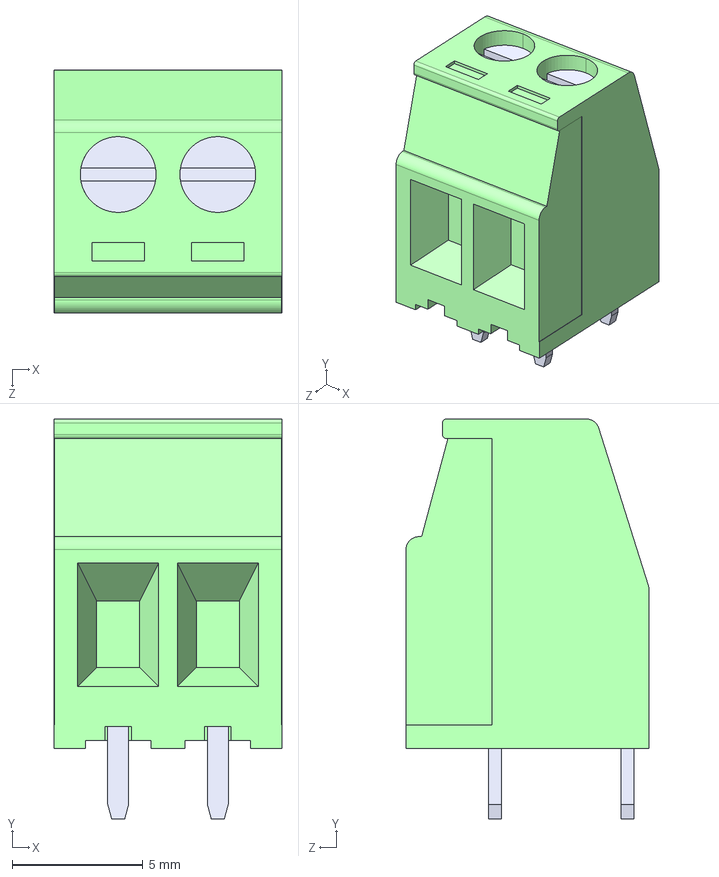
[picture p11: CAD file, 2026-03-25]
Extra_Components/3D-Models/MKDS 1_ 2-3.81.STEP
8.71 x 15.3 x 9.30 mm
