flamaque/ANE21_PCB/Extra_Components/AP62300WU_7/TSOT26_DIO.step

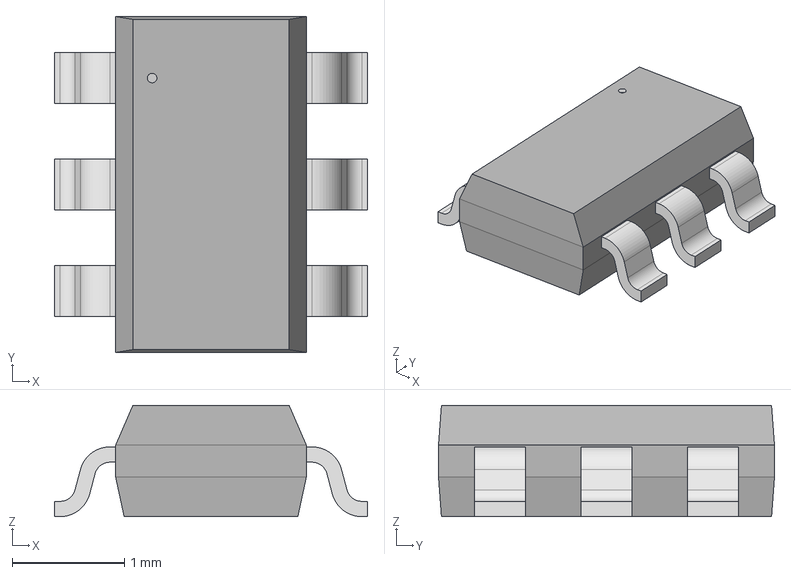
[picture p12: CAD file, 2026-03-26]
Extra_Components/AP62300WU_7/TSOT26_DIO.step
2.79 x 3.00 x 0.993 mm
