flamaque/ANE21_PCB/Extra_Components/ESD_Protection/PUSB3FR4Z/U_PUSB3FR4Z_NEX.step

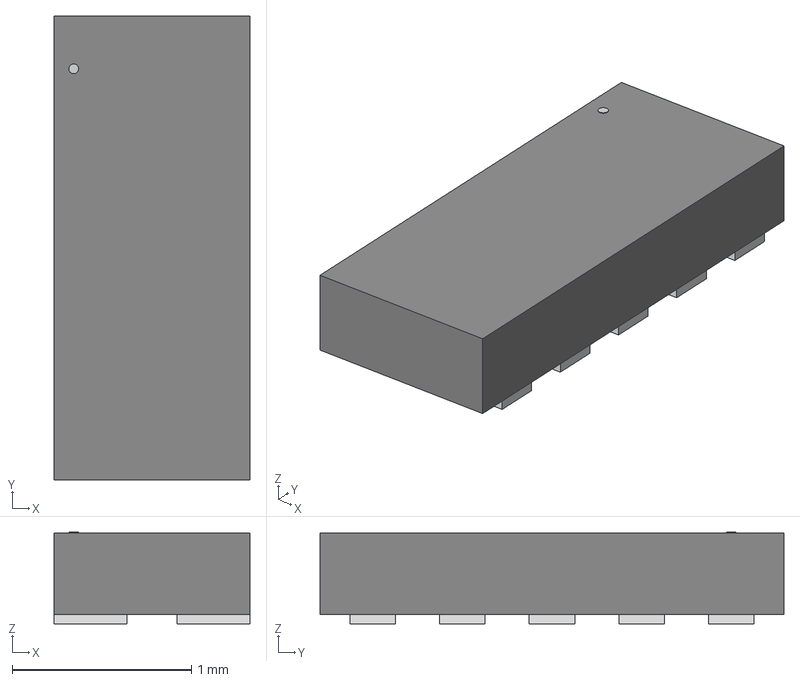
[picture p13: CAD file, 2026-03-26]
Extra_Components/ESD_Protection/PUSB3FR4Z/U_PUSB3FR4Z_NEX.step
1.09 x 2.59 x 0.511 mm
