flamaque/ANE21_PCB/Extra_Components/HUSB238/5991 HUSB238 USBC.step

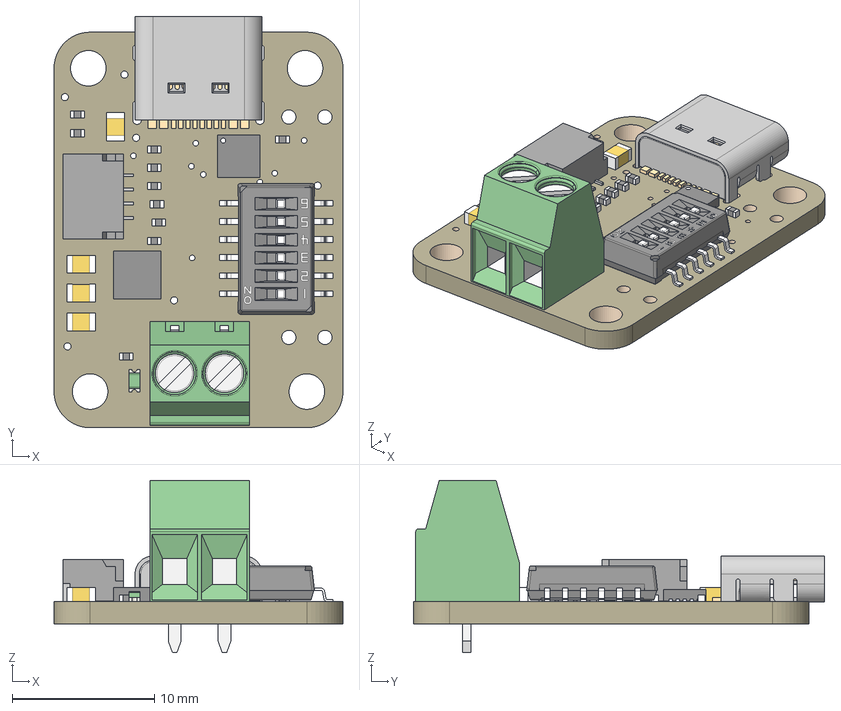
[picture p14: CAD file, 2026-03-26]
Extra_Components/HUSB238/5991 HUSB238 USBC.step
20.3 x 28.9 x 12.1 mm
Board
4.7uF x 4
HUSB238
49.9K x 10
USB Type C
AONR21307
3.5mm 2p
STEMMA_I2C_QT
DIPSWITCH_6PIN
GREEN
