flamaque/ANE21_PCB/Extra_Components/Inductor/1255AY-3R3N_P3_2/1255AY-3R3N_P3.step

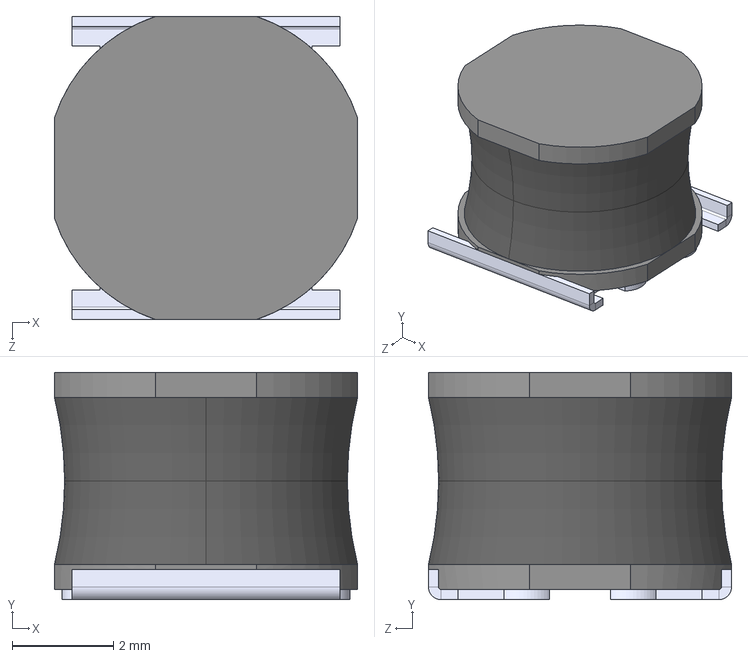
[picture p15: CAD file, 2026-02-13]
Extra_Components/Inductor/1255AY-3R3N_P3_2/1255AY-3R3N_P3.step
6.00 x 4.50 x 6.00 mm
