flamaque/ANE21_PCB/Extra_Components/PowLoadSwitch/NCP380HSN05AAT1G/TSOP-5_ONS.step

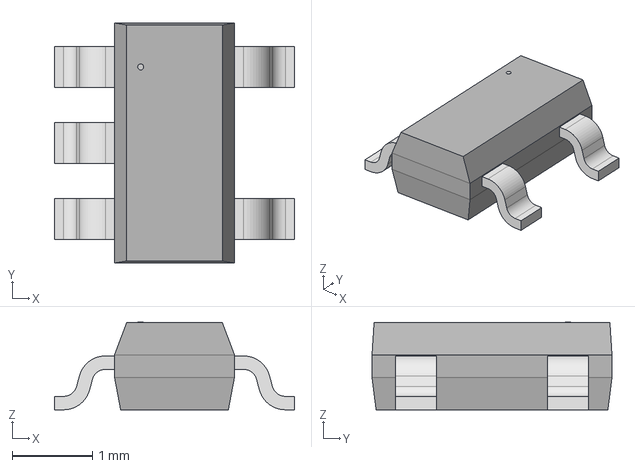
[picture p16: CAD file, 2026-03-26]
Extra_Components/PowLoadSwitch/NCP380HSN05AAT1G/TSOP-5_ONS.step
3.00 x 3.00 x 1.09 mm
