flamaque/ANE21_PCB/Extra_Components/RP-008170-DS-1-CM4-step/FixedByBambu/cm4.stl(1).stl

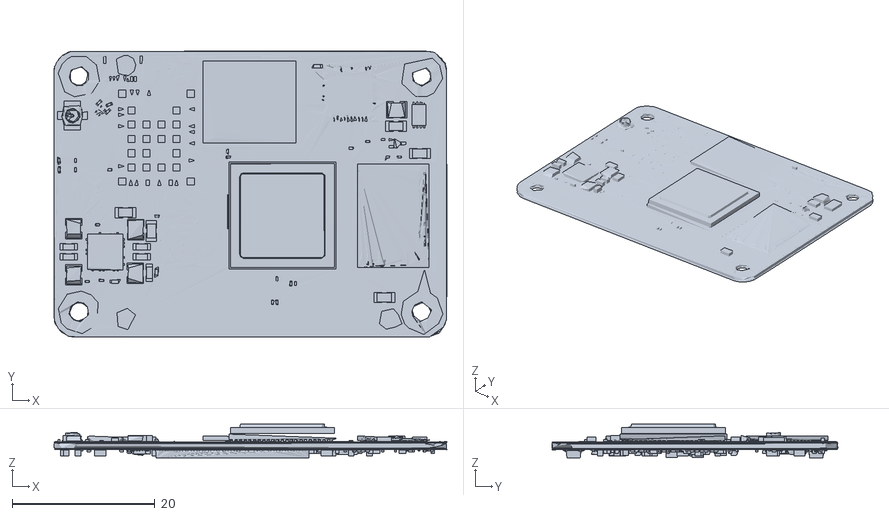
[picture p17: CAD file, 2026-04-20]
Extra_Components/RP-008170-DS-1-CM4-step/FixedByBambu/cm4.stl(1).stl
55.1 x 40.0 x 4.75
