flamaque/ANE21_PCB/Extra_Components/TVS/SMBJ14A.STEP

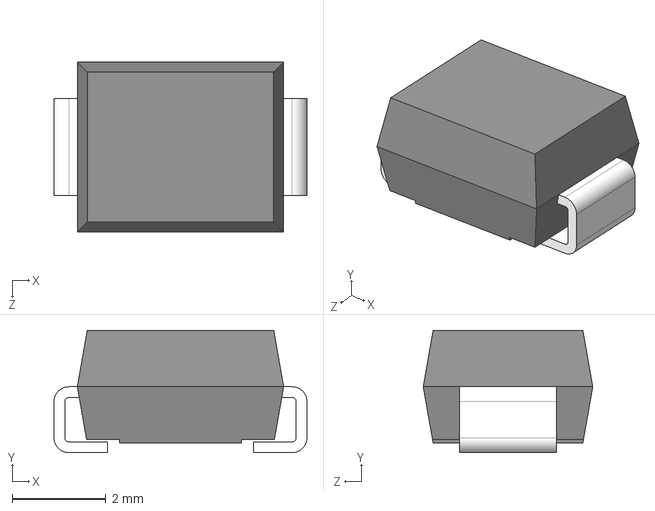
[picture p18: CAD file, 2026-03-26]
Extra_Components/TVS/SMBJ14A.STEP
5.40 x 2.61 x 3.62 mm
