flamaque/ANE21_PCB/Extra_Components/TVS/SMBJ15A/SMBJ15A.STEP

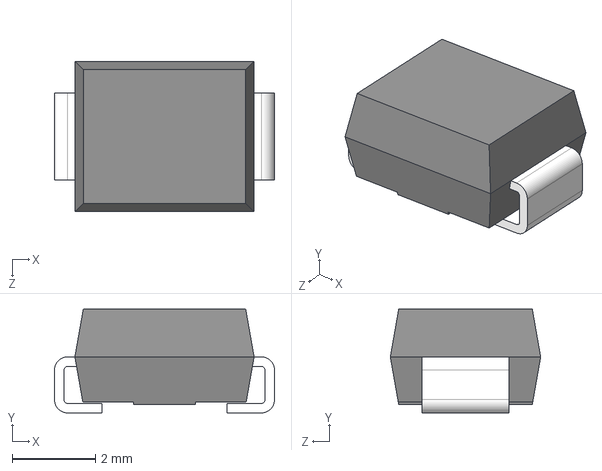
[picture p19: CAD file, 2026-03-25]
Extra_Components/TVS/SMBJ15A/SMBJ15A.STEP
5.30 x 2.50 x 3.62 mm
