flamaque/ANE21_PCB/Extra_Components/USB-C/USB-C31-A-D-VT-CS1/USB_C31_A_D_VT_CS1/USB-C31-A-D-VT-CS1.STEP

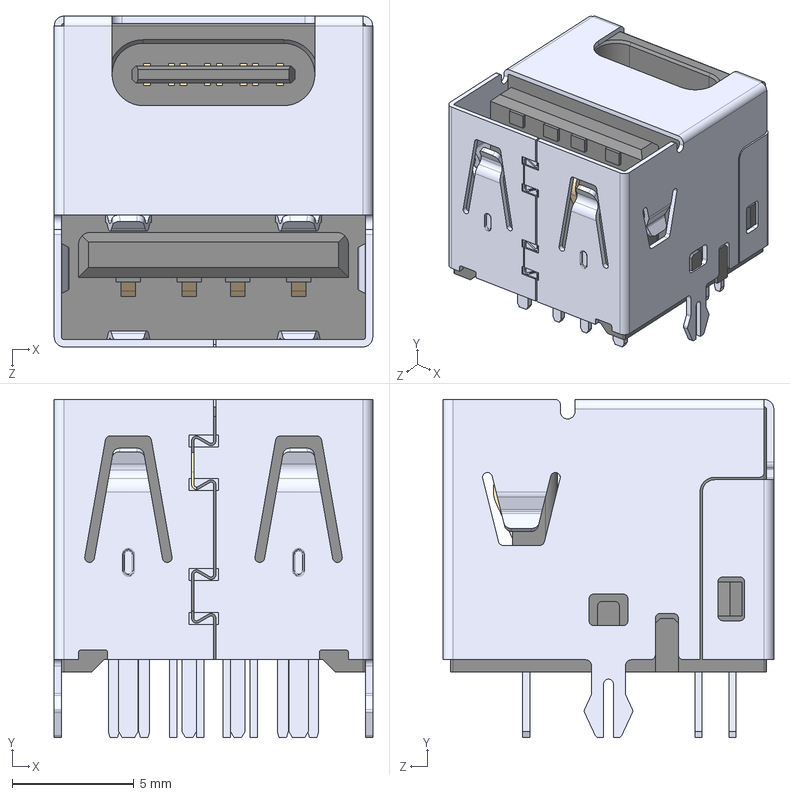
[picture p20: CAD file, 2026-03-13]
Extra_Components/USB-C/USB-C31-A-D-VT-CS1/USB_C31_A_D_VT_CS1/USB-C31-A-D-VT-CS1.STEP
13.1 x 13.9 x 13.6 mm
