flamaque/ANE21_PCB/Extra_Components/USB-C/USB4105-GF-A/USB4105-GF-A--3DModel-STEP-510211.STEP

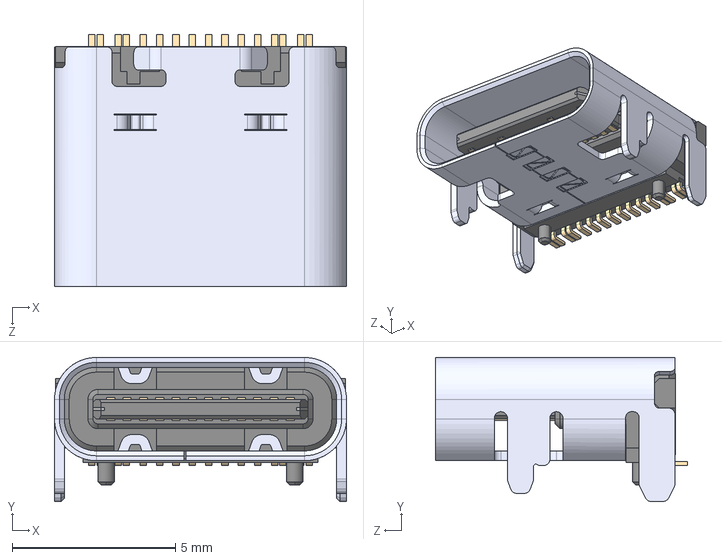
[picture p21: CAD file, 2026-03-25]
Extra_Components/USB-C/USB4105-GF-A/USB4105-GF-A--3DModel-STEP-510211.STEP
8.94 x 4.41 x 7.71 mm
