flamaque/ANE21_PCB/SS-52400-004 (USB-c connector)/PARTserver22026030614434013911060d0b6156e/SS-52400-004.stp

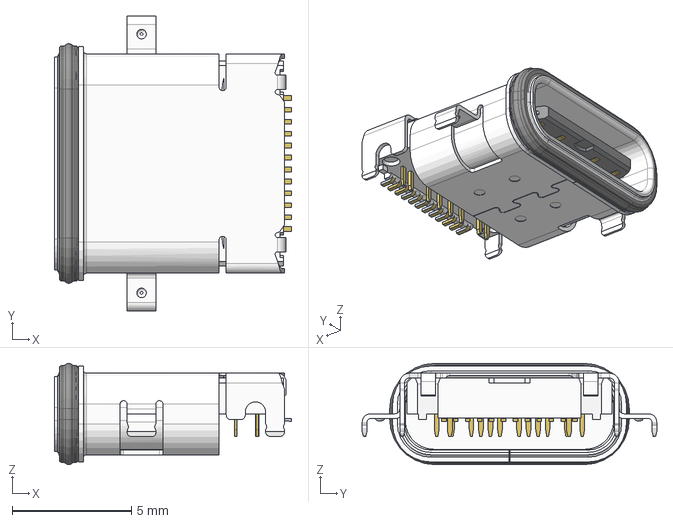
[picture p22: CAD file, 2026-03-06]
SS-52400-004 (USB-c connector)/PARTserver22026030614434013911060d0b6156e/SS-52400-004.stp
9.94 x 12.3 x 4.25 mm
