flamaque/ANE21_PCB/SS-52400-004 (USB-c connector)/PARTserver22026030614442547011102d0b6156e/SS-52400-004.stl

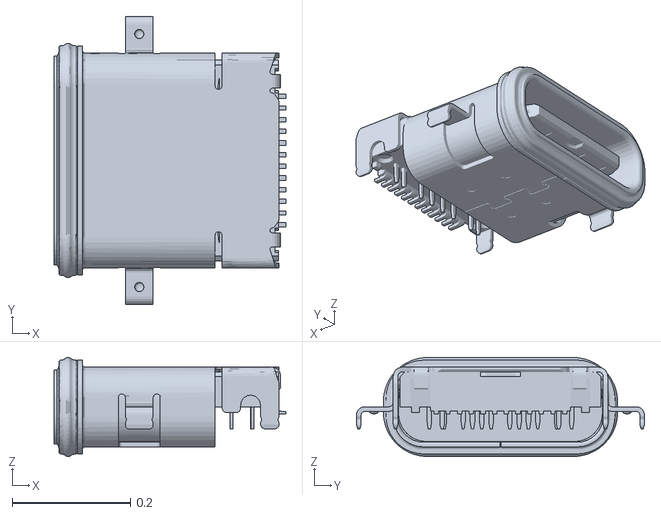
[picture p23: CAD file, 2026-03-06]
SS-52400-004 (USB-c connector)/PARTserver22026030614442547011102d0b6156e/SS-52400-004.stl
0.391 x 0.486 x 0.167
