flamaque/ANE21_PCB/Extra_Components/3D-Models/USB4105-GF-A.step

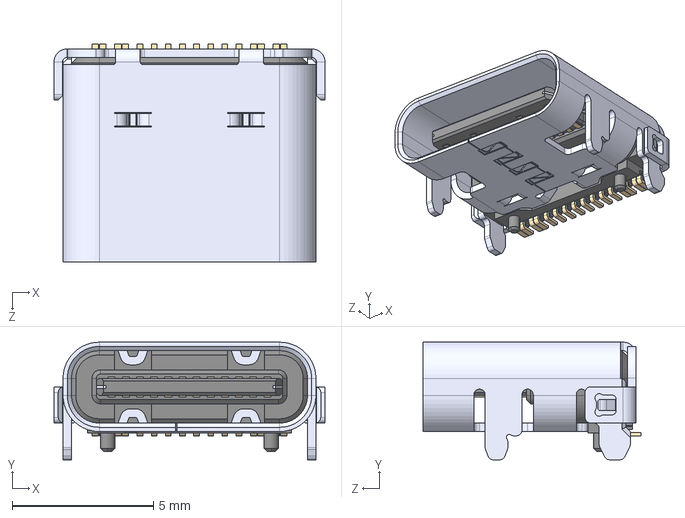
[picture p24: CAD file, 2026-03-25]
Extra_Components/3D-Models/USB4105-GF-A.step
9.58 x 4.16 x 7.71 mm
