flamaque/ANE21_PCB/Extra_Components/HUSB238/HUSB238_USBC.step

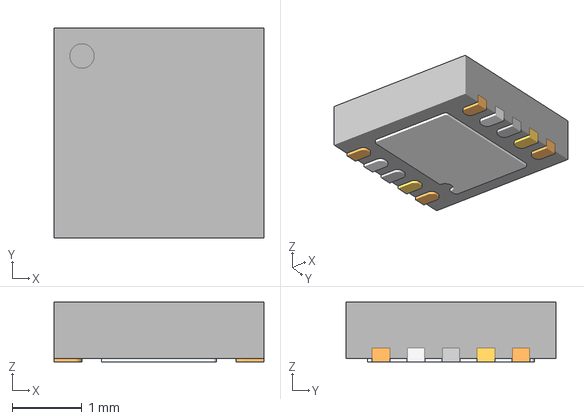
[picture p25: CAD file, 2026-03-26]
Extra_Components/HUSB238/HUSB238_USBC.step
3.00 x 3.00 x 0.85 mm
