flamaque/ANE21_PCB/Extra_Components/TVS/SMBJ15A/DIODE_DO214AA.step

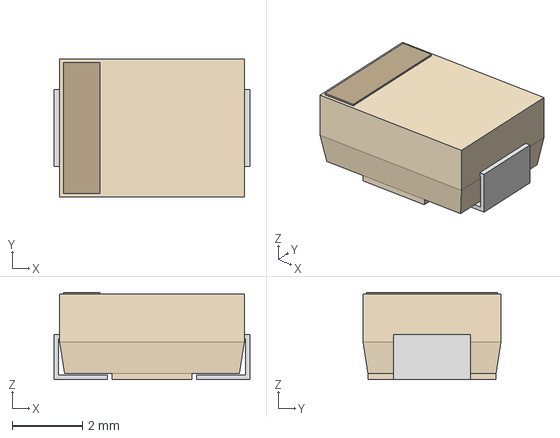
[picture p26: CAD file, 2026-03-25]
Extra_Components/TVS/SMBJ15A/DIODE_DO214AA.step
5.59 x 3.94 x 2.49 mm
