flamaque/ANE21_PCB/Extra_Components/3D-Models/SOT1176-1.step

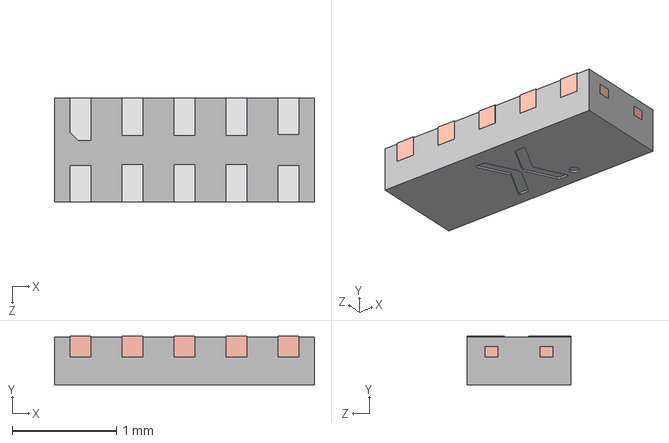
[picture p27: CAD file, 2026-03-06]
Extra_Components/3D-Models/SOT1176-1.step
2.50 x 0.47 x 1.00 mm
SOT1176 LF
SOT1176 Mold body
