flamaque/ANE21_PCB/Extra_Components/3D-Models/USB-A-S-VT.stp

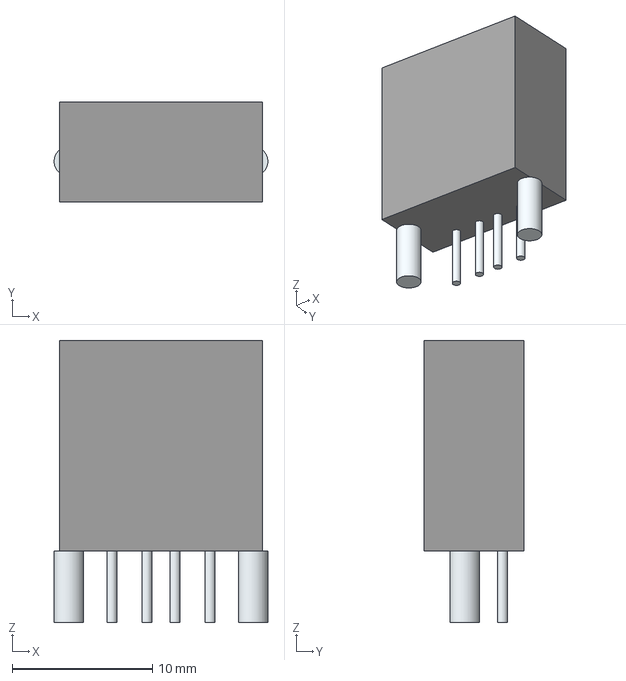
[picture p28: CAD file, 2026-03-06]
Extra_Components/3D-Models/USB-A-S-VT.stp
15.2 x 7.12 x 20.1 mm
Leads
