flamaque/ANE21_PCB/Extra_Components/3D-Models/SI-50170-F--3DModel-STEP-56544.STEP

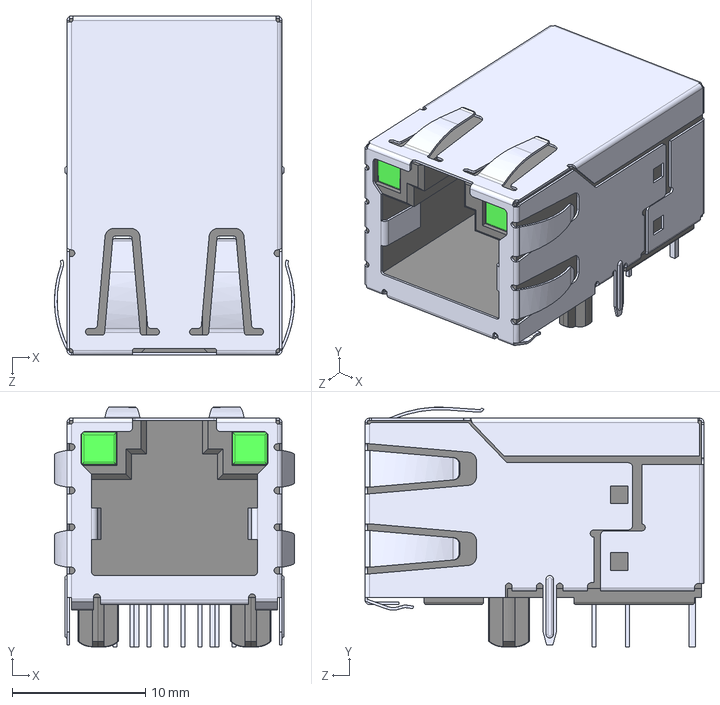
[picture p29: CAD file, 2026-03-06]
Extra_Components/3D-Models/SI-50170-F--3DModel-STEP-56544.STEP
18.0 x 18.0 x 25.4 mm
