flamaque/ANE21_PCB/Extra_Components/3D-Models/KUSBX-AS1N-B--3DModel-STEP-269445.STEP

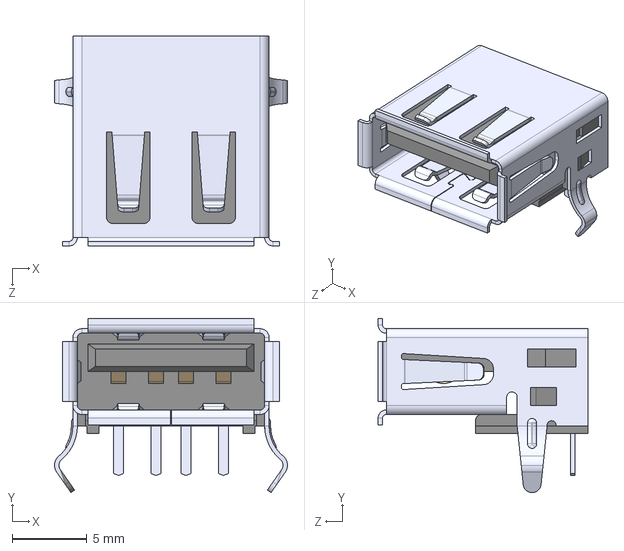
[picture p30: CAD file, 2026-03-06]
Extra_Components/3D-Models/KUSBX-AS1N-B--3DModel-STEP-269445.STEP
15.5 x 11.6 x 14.0 mm
