flamaque/ANE21_PCB/Extra_Components/3D-Models/74LVC1G07SE-7.step

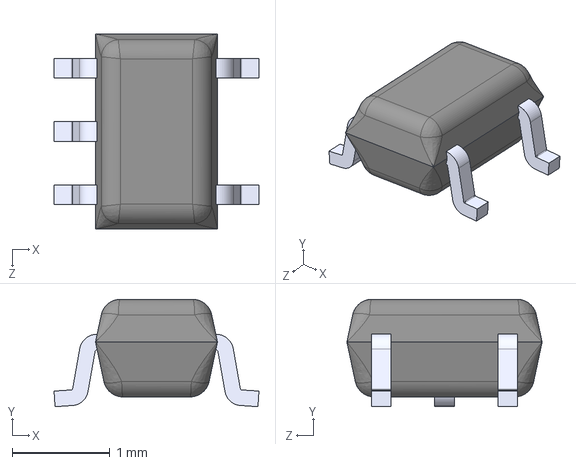
[picture p31: CAD file, 2026-03-06]
Extra_Components/3D-Models/74LVC1G07SE-7.step
2.10 x 1.10 x 2.00 mm
