flamaque/ANE21_PCB/Extra_Components/3D-Models/DF40C-100DS.stp

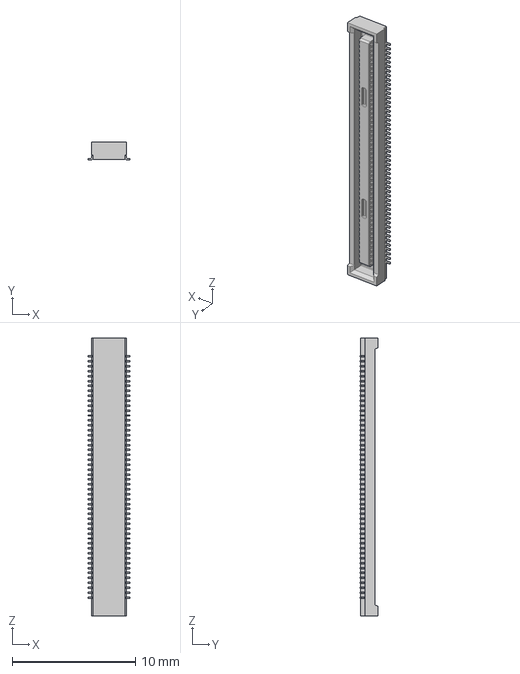
[picture p32: CAD file, 2026-02-23]
Extra_Components/3D-Models/DF40C-100DS.stp
3.38 x 1.45 x 22.6 mm
