flamaque/ANE21_PCB/Extra_Components/3D-Models/CL10B104KO8NNNC.step

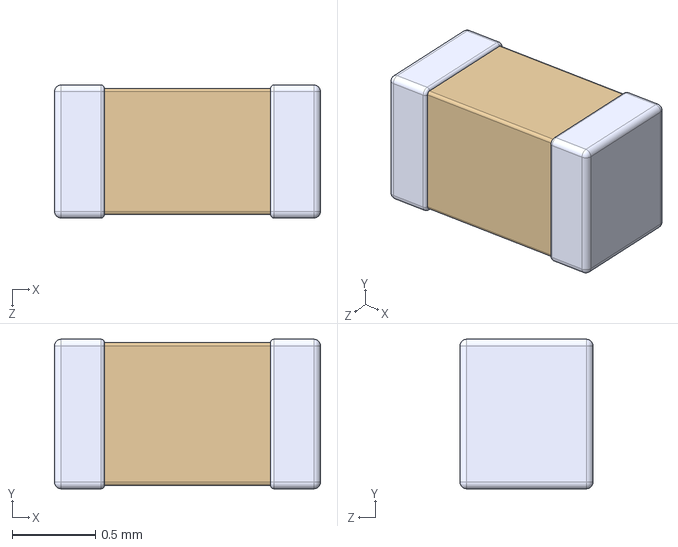
[picture p33: CAD file, 2026-02-13]
Extra_Components/3D-Models/CL10B104KO8NNNC.step
1.60 x 0.9 x 0.8 mm
