flamaque/ANE21_PCB/Extra_Components/3D-Models/CL31B226KPHNNNE.step

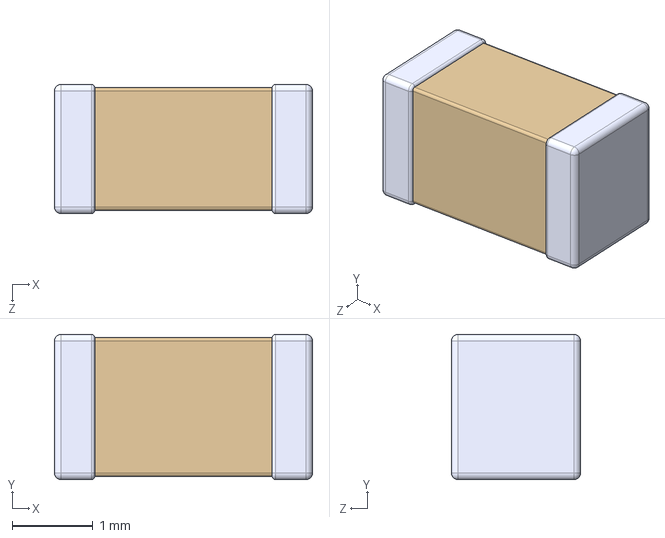
[picture p34: CAD file, 2026-02-13]
Extra_Components/3D-Models/CL31B226KPHNNNE.step
3.20 x 1.80 x 1.60 mm
