flamaque/ANE21_PCB/Extra_Components/3D-Models/NCP380HSN05AAT1G.step

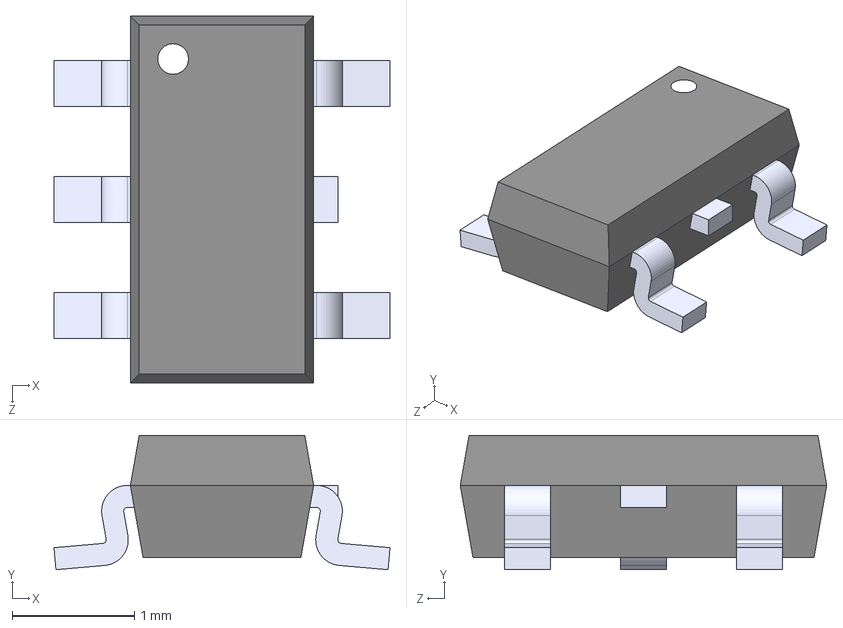
[picture p35: CAD file, 2026-02-13]
Extra_Components/3D-Models/NCP380HSN05AAT1G.step
2.75 x 1.10 x 3.00 mm
