flamaque/ANE21_PCB/Extra_Components/3D-Models/GRM21BR71A106KA73L.step

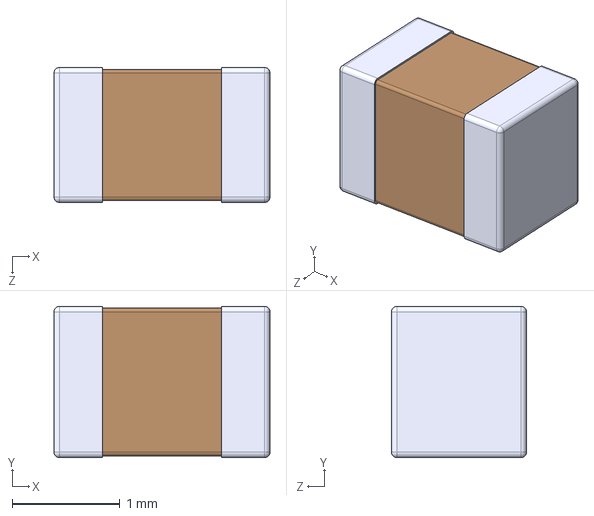
[picture p36: CAD file, 2026-02-13]
Extra_Components/3D-Models/GRM21BR71A106KA73L.step
2.00 x 1.40 x 1.25 mm
