flamaque/ANE21_PCB/Extra_Components/3D-Models/1-2199119-5.step

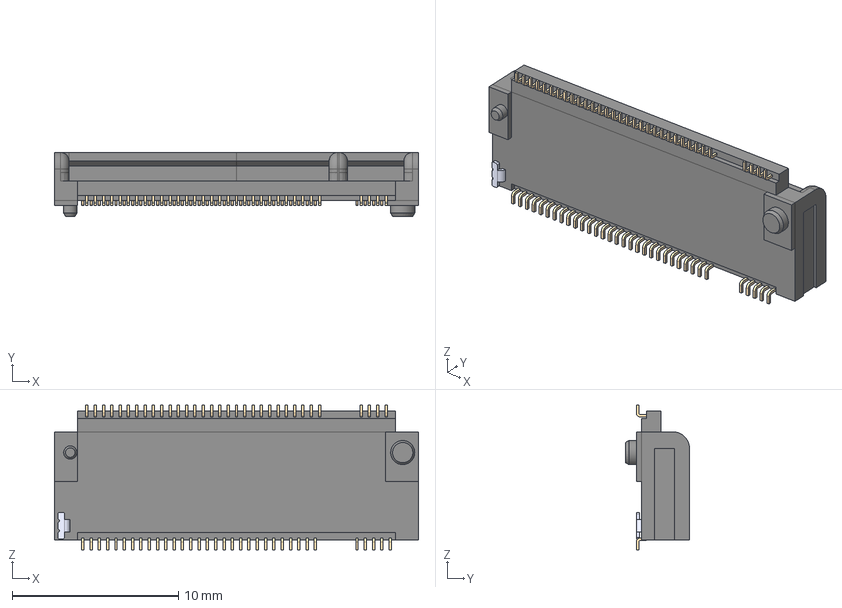
[picture p37: CAD file, 2026-02-13]
Extra_Components/3D-Models/1-2199119-5.step
21.9 x 3.85 x 8.70 mm
Body005 (Mirror #1)
