flamaque/ANE21_PCB/(list of files, cad)

Other CAD files:
Extra_Components/3D-Models/TSOT26_DIO.step
Extra_Components/3D-Models/10029449-111RLF--3DModel-STEP-269445.STEP
Extra_Components/3D-Models/10103593-0001LF--3DModel-STEP-510211.STEP
Extra_Components/HUSB238/5991 HUSB238 USBC.f3d
Extra_Components/HUSB238/5991 HUSB238 USBC.stl
Extra_Components/USB-C/179876442-659-2036150003/2036150003.stp
Extra_Components/USB/1734366-1.STEP
