flamaque/ANE21_PCB/Extra_Components/ch224k/Gerber_CH224K-Minimal_PCB_CH224K-Minimal_2025-12-29/How-to-order-PCB.txt

How to Order PCB

Please refer to:
https://docs.easyeda.com/en/PCB/Order-PCB
