flamaque/ANE21_PCB/Extra_Components/Headers/FRCI-S-A0000576228-1_2x5.pdf

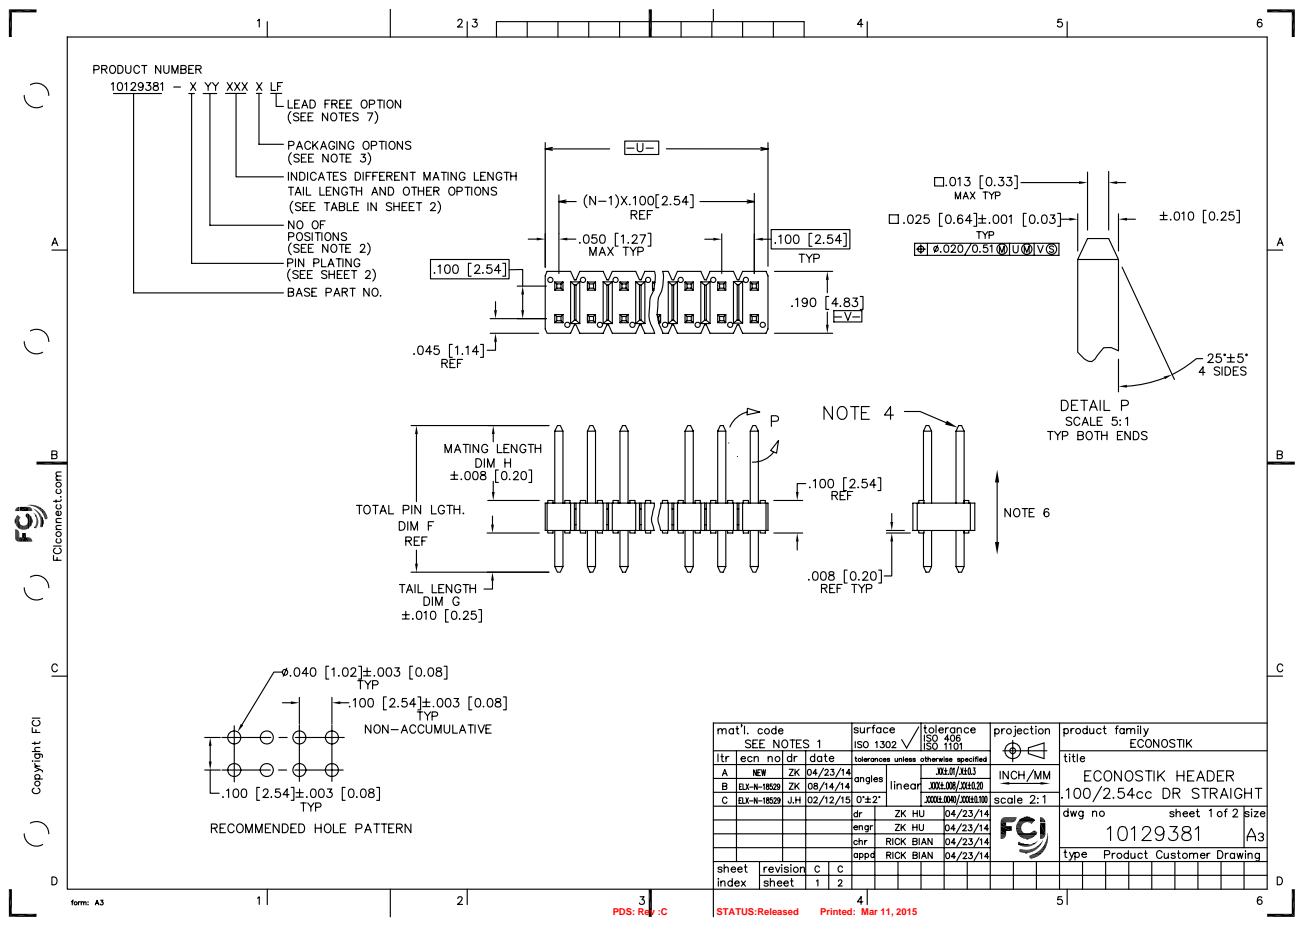
[picture p38: page 1]
PDS: Rev :C; STATUS:Released; Printed: Mar 11, 2015

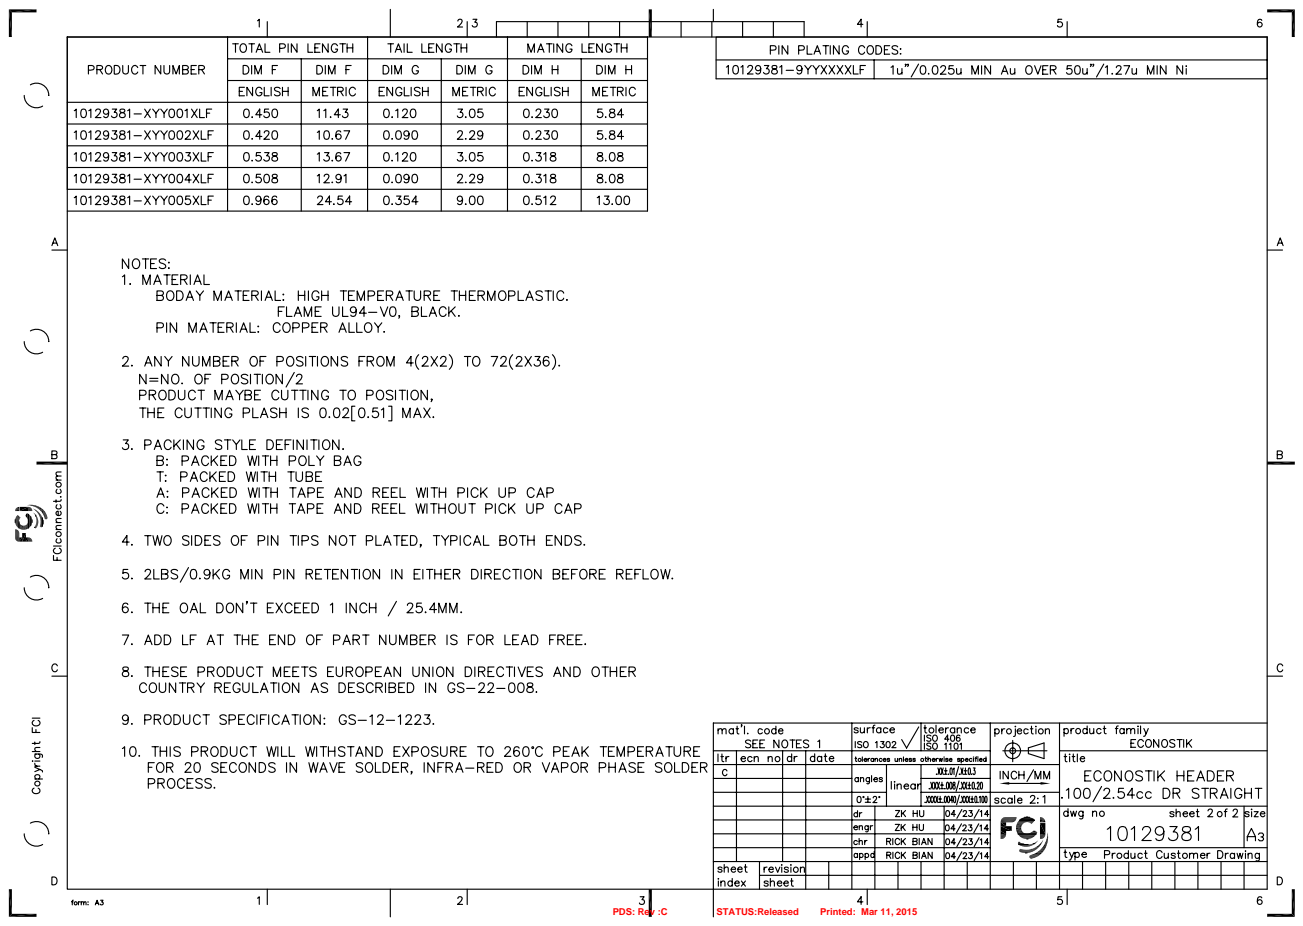
[picture p39: page 2]
PDS: Rev :C; STATUS:Released; Printed: Mar 11, 2015
