flamaque/ANE21_PCB/Extra_Components/lib_Finley/HR_INA21_CM4.pdf

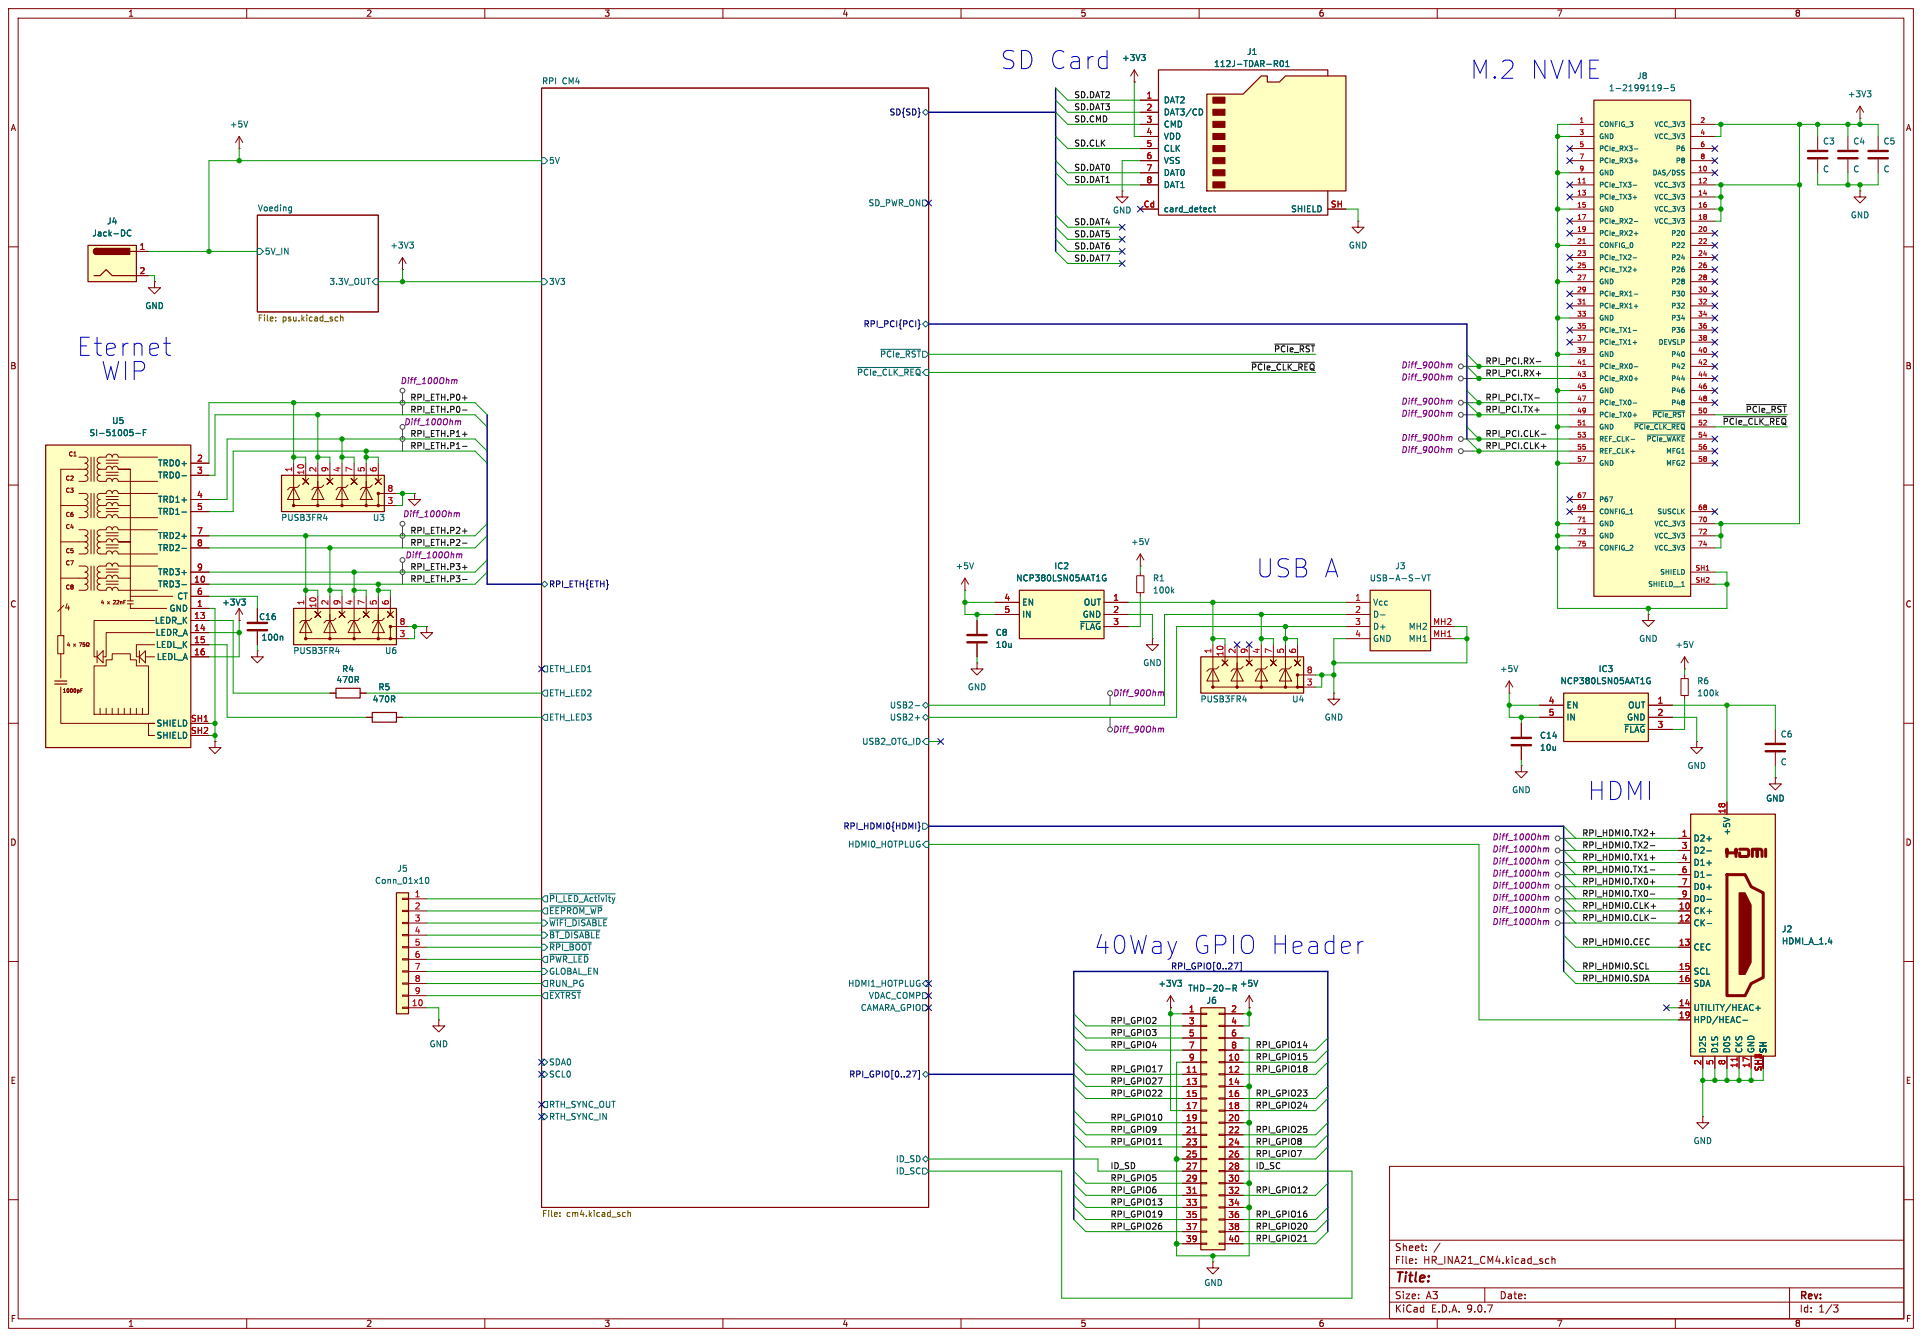
[picture p40: page 1]

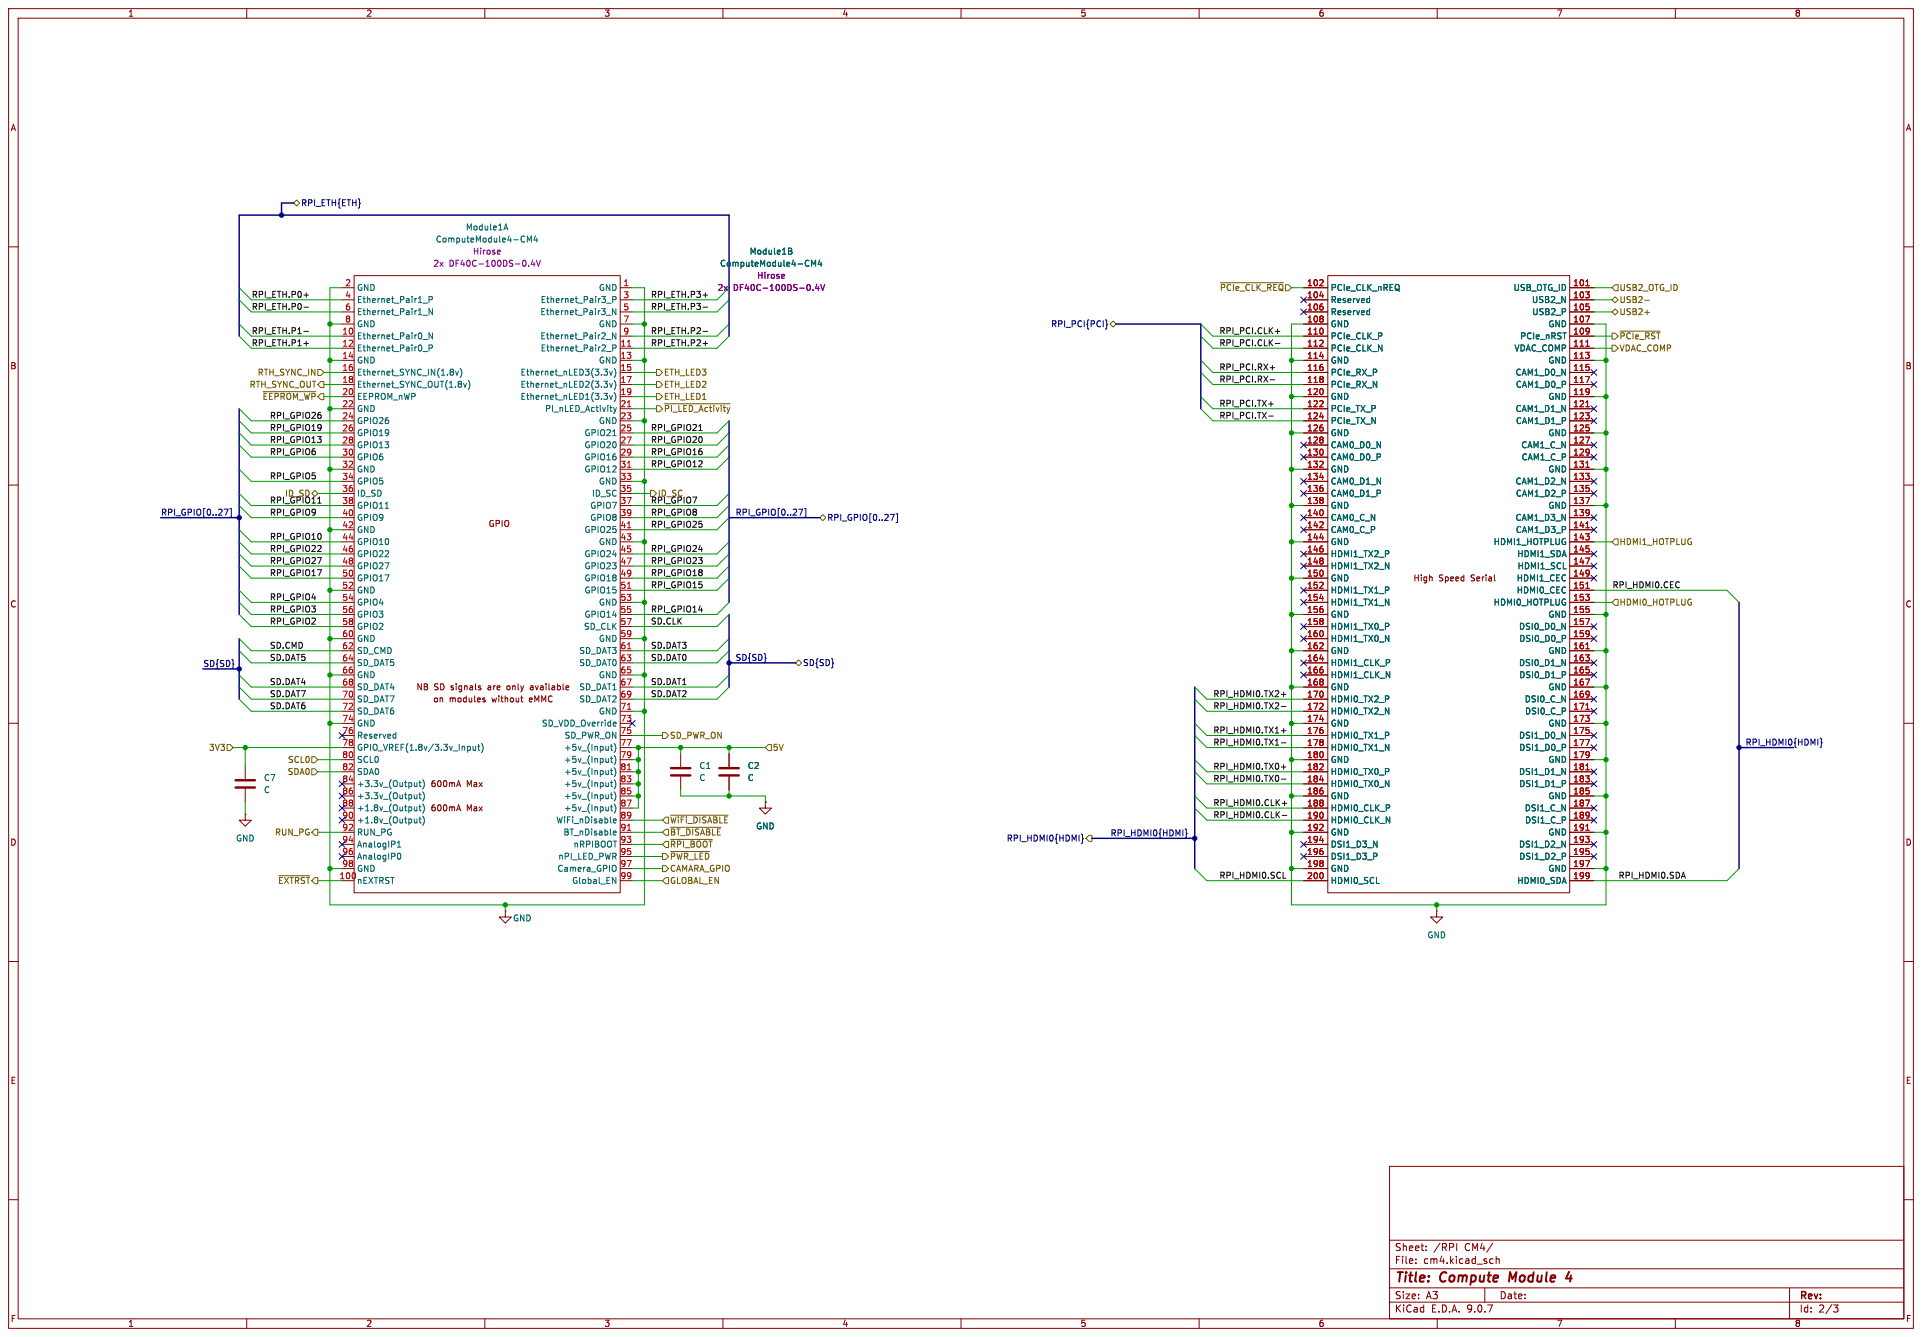
[picture p41: page 2]

RPI_ETH{ETH}
ID_SD 36 GPIO11 38 GPIO9 40 GND 42 GPIO10 44 GPIO22 46 GPIO27 48 GPIO17 50 GND 52 GPIO4 54 GPIO3 56 GPIO2 58 GND 60 SD_CMD 62 SD_DAT5 64 GND 66 SD_DAT4 68 SD_DAT7 70 SD_DAT6 72 GND 74 Reserved 76 GPIO_VREF(1.8v/3.3v_Input) 78 SCL0 80 SDA0 82 +3.3v_(Output) 84 +3.3v_(Output) 86 +1.8v_(Output) 88 +1.8v_(Output) 90 RUN_PG 92 AnalogIP1 94 AnalogIP0 96 GND 98

GND 2 Ethernet_Pair1_P 4 Ethernet_Pair1_N 6 GND 8 Ethernet_Pair0_N 10 Ethernet_Pair0_P 12 GND 14 Ethernet_SYNC_IN(1.8v) 16 Ethernet_SYNC_OUT(1.8v) 18 EEPROM_nWP 20 GND 22 GPIO26 24 GPIO19 26 GPIO13 28 GPIO6 30 GND 32 GPIO5 34

on modules without eMMC GPIO

600mA Max 600mA Max NB SD signals are only available

Id: 2/3 Title: Compute Module 4

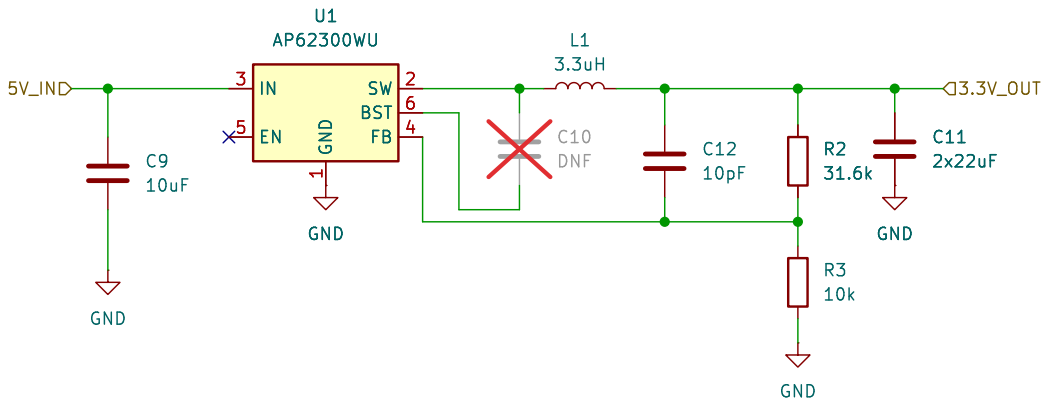
[picture p42: page 3]

Id: 3/3 Title: File: psu.kicad_sch Sheet: /Voeding/
