flamaque/ANE21_PCB/Extra_Components/2074929_SwitchButton.pdf

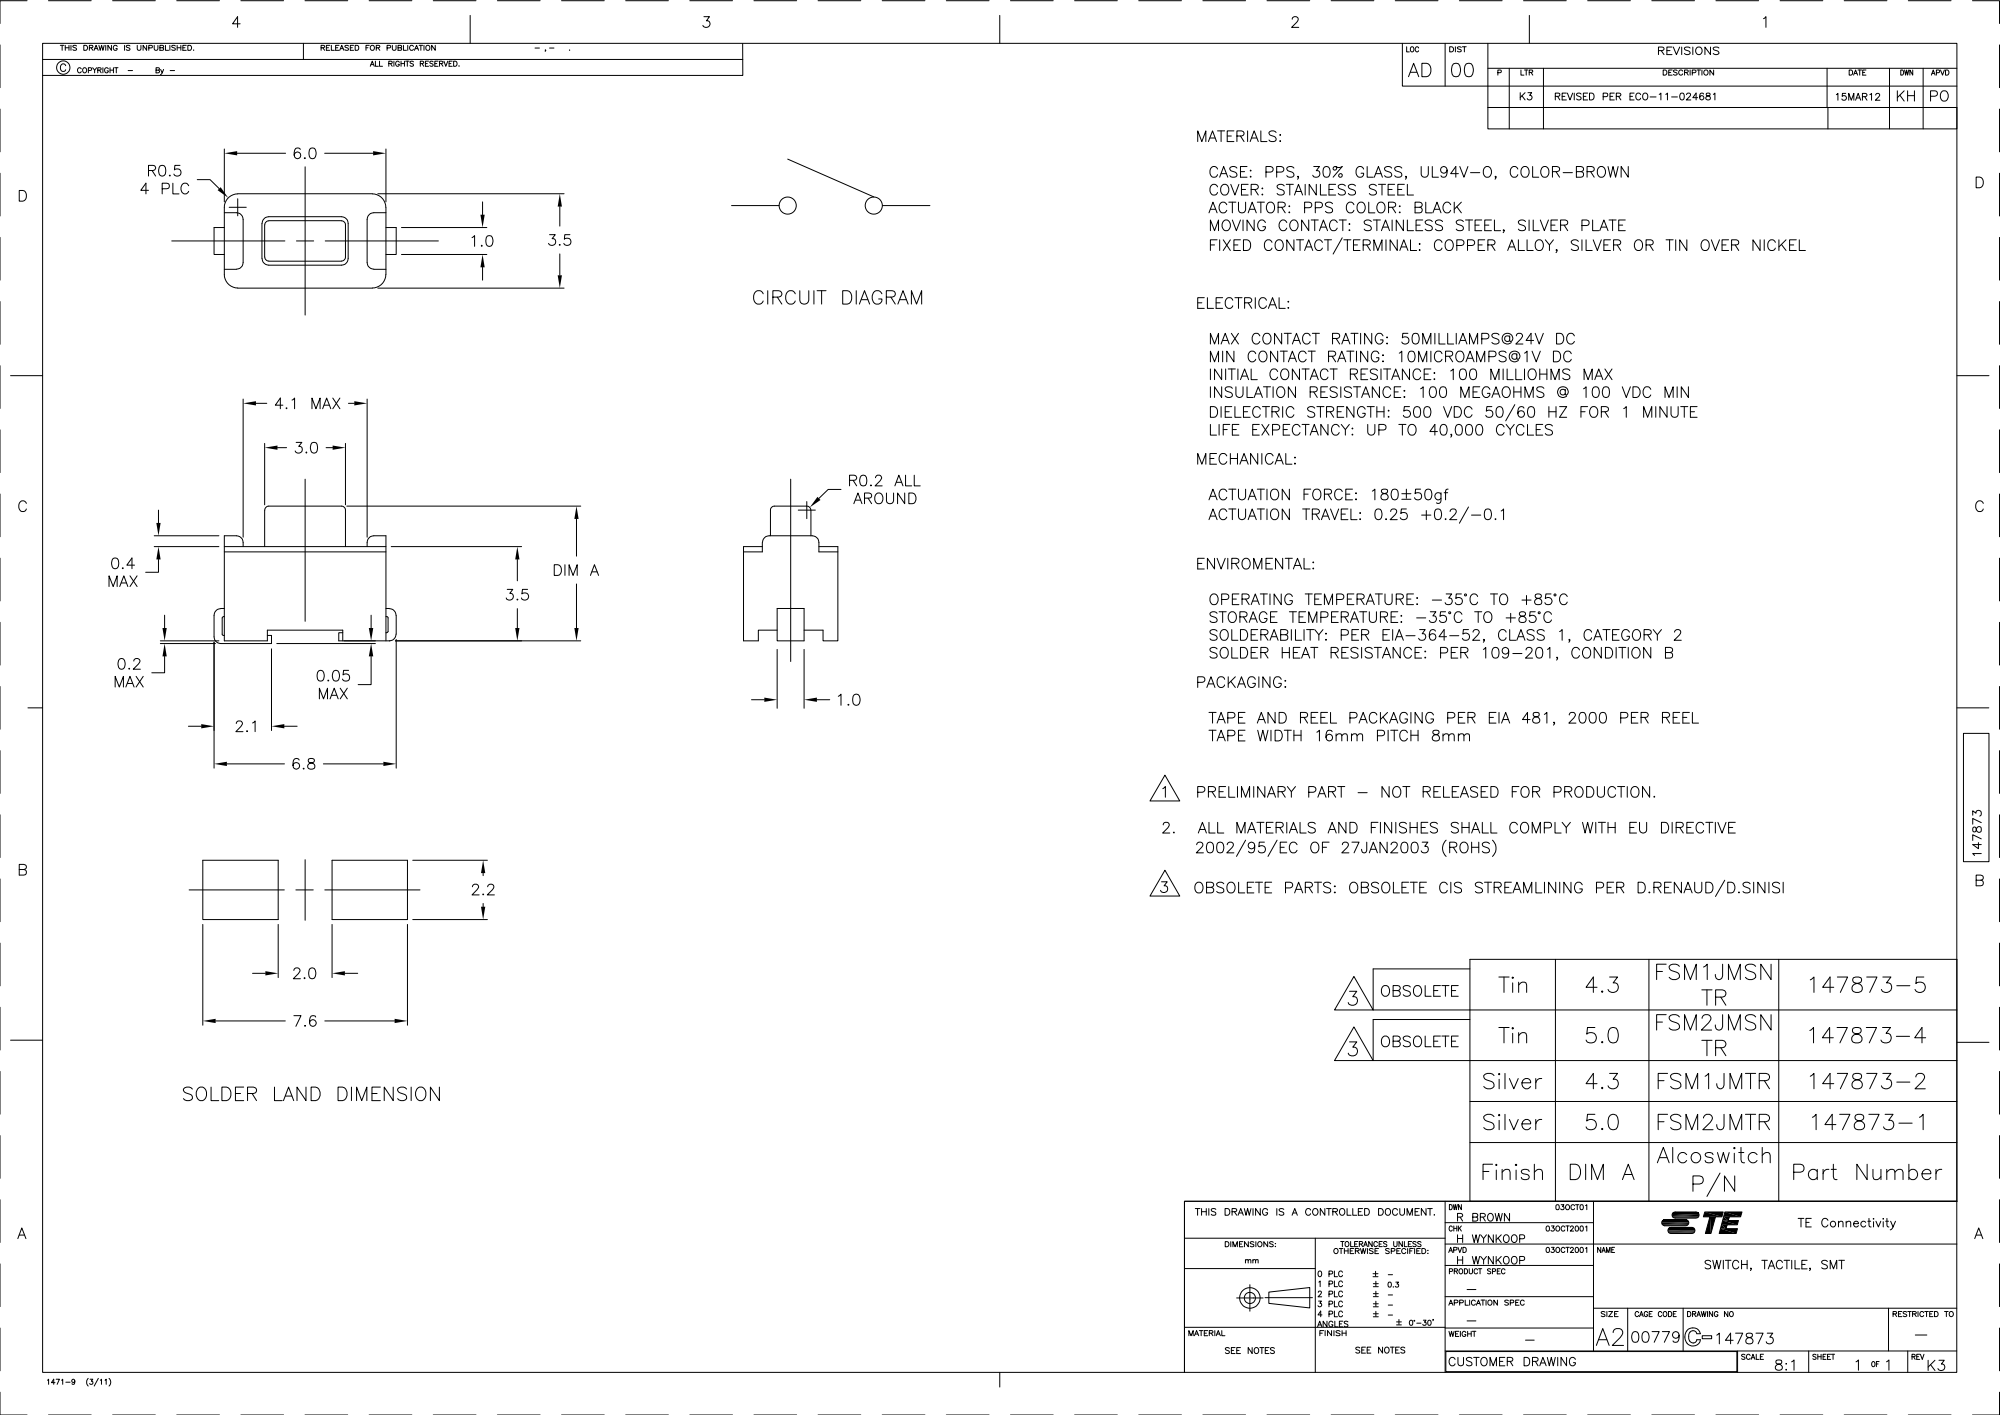
[picture p43: page 1]
