flamaque/ANE21_PCB/Extra_Components/ch224k/Schematic_CH224K-Minimal_2025-12-29.pdf

## OUTPUT

MAIN INPUT | USB PD | CONFIG

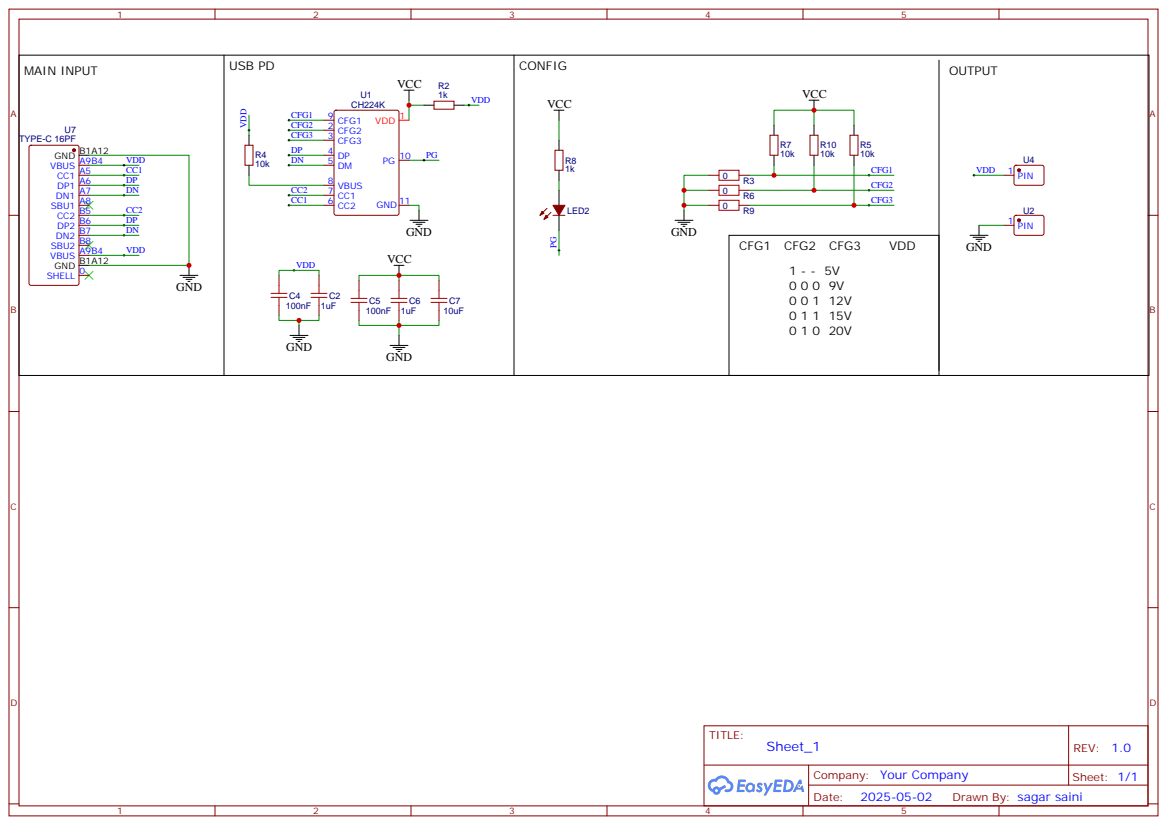
[picture p44: page 1]

Drawn By: sagar saini
