flamaque/ANE21_PCB/Extra_Components/Inductor/Draft1.asc

C1: cap; 100nF
Q1: npn; 2N3019
Q2: npn; BC547C
Q3: npn; BC547C
R1: res; 3260
R2: res; 2.2k
R3: res; 1050
R4: res; 450
RSC1: res; 7
U1: pot; Rt=1K set=.5
V1: voltage; ""
V2: voltage; 1.3
Named nets: 0
.include regulators.lib
.dc V1 7 30 0.1
Vout
.include Pot.lib
