flamaque/ANE21_PCB/Extra_Components/Inductor/InductorSimulation.asc

L1: ind; 3.3µ; Ipk=5.2 Rser=0.021 Rpar=0 Cpar=0 mfg="Murata" pn="1255AY-3R3N=P3"
.include 1255AY-3R3N.lib
.tran 0.1
