flamaque/ANE21_PCB/(list of files, drawings)

Other design files:
freerouting.dsn
temp-freerouting.dsn
