flamaque/ANE21_PCB/ANE21_PCB.kicad_pcb

## KiCad design ANE21_PCB.kicad_pcb (2026-04-20)

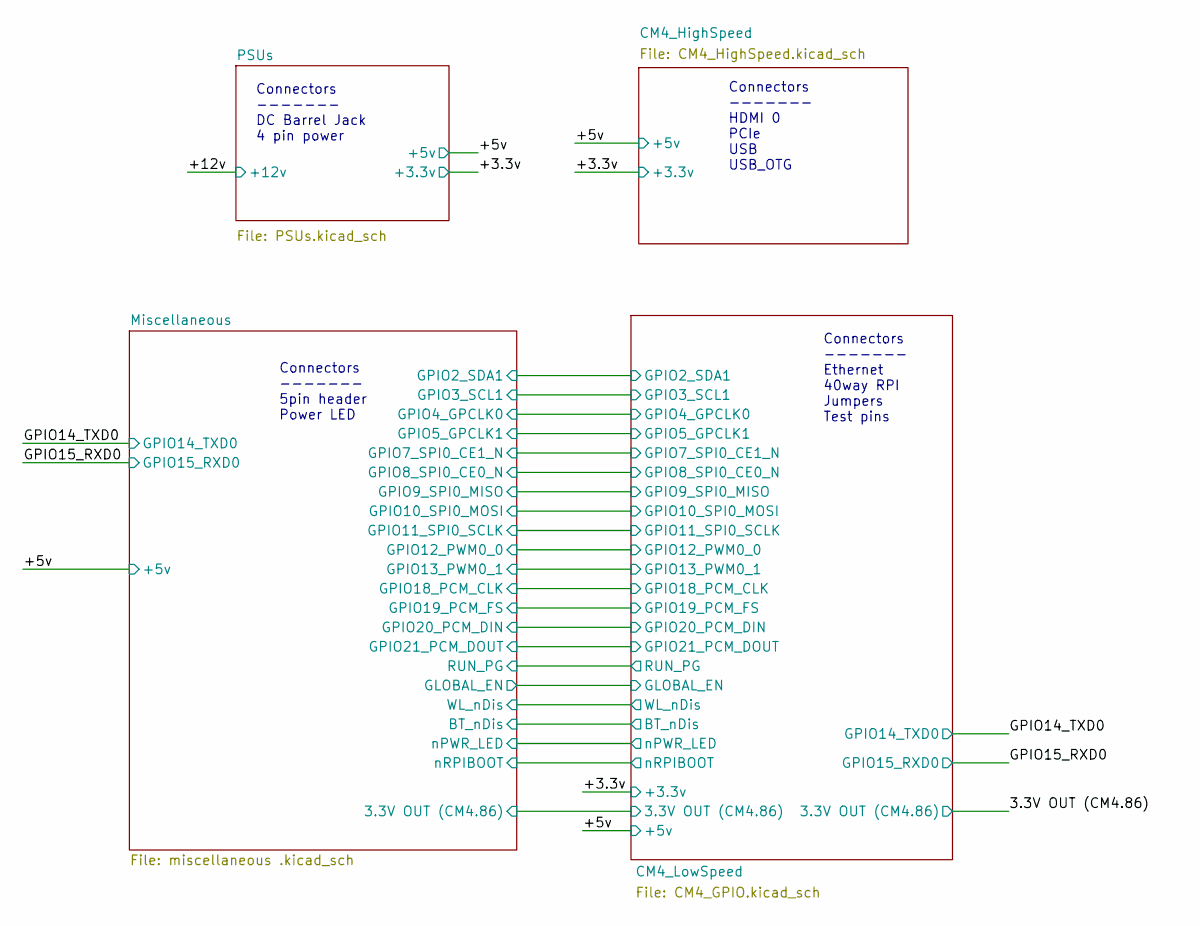
[picture p45: schematic ANE21_PCB.kicad_sch]

Notes on the sheet:
Connectors ------- DC Barrel Jack 4 pin power
Connectors ------- Ethernet 40way RPI Jumpers Test pins
Connectors ------- 5pin header Power LED
Connectors ------- HDMI 0 PCIe USB USB_OTG

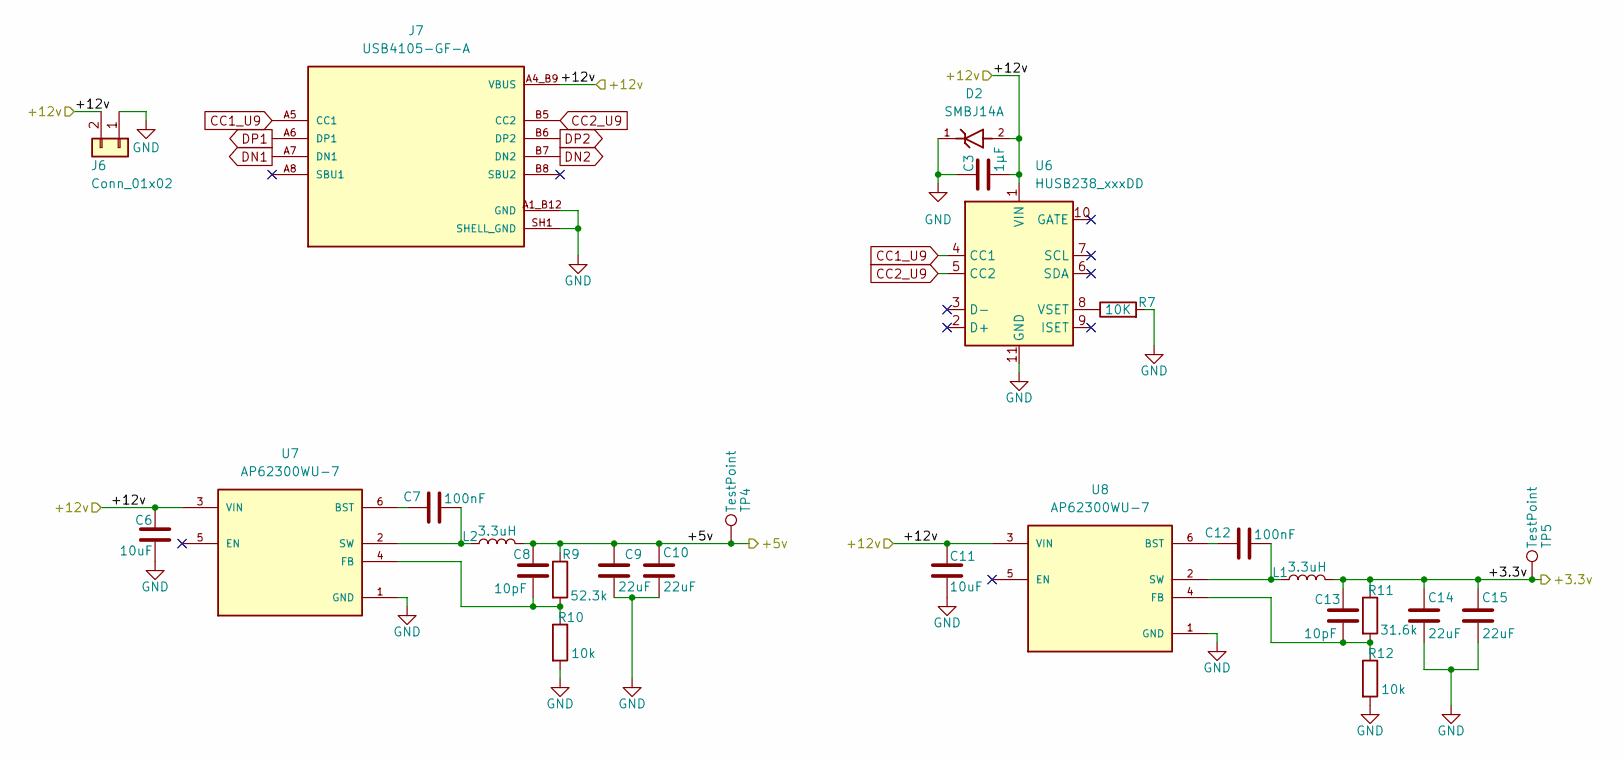
[picture p46: schematic PSUs.kicad_sch]

Parts:
C3: 1µF; C_0402_1005Metric_Pad0.74x0.62mm_HandSolder
C6, C11: 10uF; C_0402_1005Metric_Pad0.74x0.62mm_HandSolder
C7, C12: 100nF; C_0402_1005Metric_Pad0.74x0.62mm_HandSolder
C8, C13: 10pF; C_0402_1005Metric_Pad0.74x0.62mm_HandSolder
C9, C10, C14, C15: 22uF; C_0402_1005Metric_Pad0.74x0.62mm_HandSolder
D2: SMBJ14A; DIOM5436X261N; PARTREV JC.07/04/25 v4
J6: Conn_01x02; TerminalBlock_PhoenixTerminalBlock_Phoenix_MKDS-1,5-2-5.08_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
J7: USB4105-GF-A; GCT_USB4105-GF-A; PARTREV B4
L1, L2: 3.3uH; IND_1255AY-3R3N=P3
R7: 10K; R_0402_1005Metric_Pad0.72x0.64mm_HandSolder
R9: 52.3k; R_0402_1005Metric_Pad0.72x0.64mm_HandSolder
R10, R12: 10k; R_0402_1005Metric_Pad0.72x0.64mm_HandSolder
R11: 31.6k; R_0402_1005Metric_Pad0.72x0.64mm_HandSolder
TP4, TP5: TestPoint; TestPoint_Pad_2.0x2.0mm
U6: HUSB238_xxxDD; WDFN-10-1EP_3x3mm_P0.5mm_EP1.8x2.5mm
U7, U8: AP62300WU-7; SOT95P280X100-6N; PARTREV Rev. 3 - 2; DigiKey_Part_Number 31-AP62300WU-7CT-ND

Connections:
/+3.3v: C13.2, C14.2, C15.2, L1.2, R11.1, TP5.1; also elsewhere on the board
CC1_U9: J7.A5 (CC1), U6.4 (CC1); also elsewhere on the board
CC2_U9: J7.B5 (CC2), U6.5 (CC2); also elsewhere on the board
GND: C3.1, C6.2, C9.1, C10.1, C11.2, C14.1, C15.1, D2.1, J6.1, J7.A1_B12 (GND), J7.B1_A12 (GND), J7.SH1 (SHELL_GND), J7.SH2 (SHELL_GND), J7.SH3 (SHELL_GND), J7.SH4 (SHELL_GND), R7.2, R10.2, R12.2, U6.11 (GND), U7.1 (GND), U8.1 (GND); also elsewhere on the board
unnamed: R7.1, U6.8 (VSET)
unnamed: C7.1, U7.6 (BST)
unnamed: C8.1, R9.2, R10.1, U7.4 (FB)
unnamed: C7.2, L2.1, U7.2 (SW)
unnamed: C12.1, U8.6 (BST)
unnamed: C13.1, R11.2, R12.1, U8.4 (FB)
unnamed: C12.2, L1.1, U8.2 (SW)
VBUS: C8.2, C9.2, C10.2, L2.2, R9.1, TP4.1; also elsewhere on the board
VBUS-PD: C3.2, C6.1, C11.1, D2.2, J6.2, J7.A4_B9 (VBUS), J7.B4_A9 (VBUS), U6.1 (VIN), U7.3 (VIN), U8.3 (VIN); also elsewhere on the board

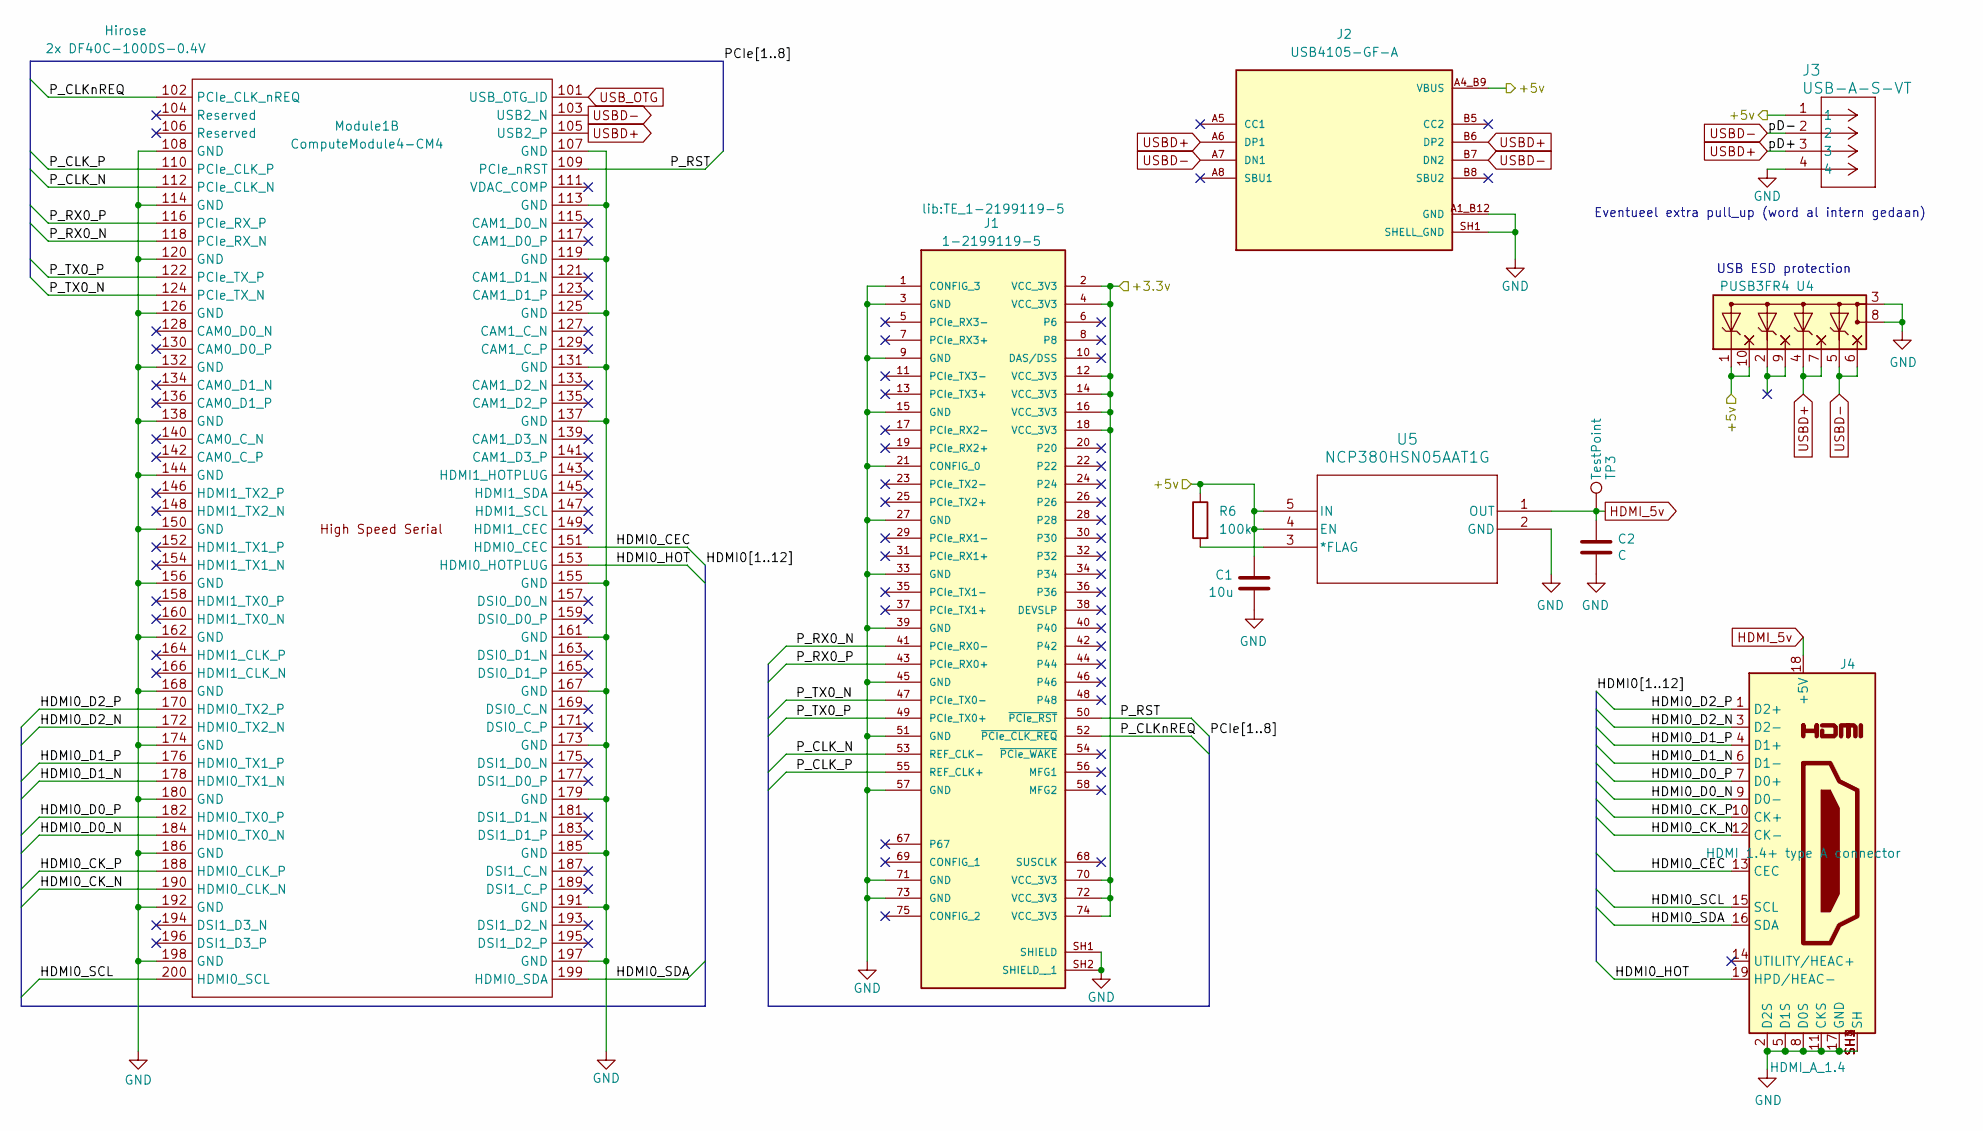
[picture p47: schematic CM4_HighSpeed.kicad_sch]

Parts:
C1: 10u; C_0402_1005Metric_Pad0.74x0.62mm_HandSolder; Part Description 0.1uF 10% 16V Ceramic Capacitor X7R 040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
C2: C; C_0402_1005Metric_Pad0.74x0.62mm_HandSolder; Part Description 0.1uF 10% 16V Ceramic Capacitor X7R 040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
J1: 1-2199119-5; TE_1-2199119-5
J2: USB4105-GF-A; GCT_USB4105-GF-A; PARTREV B4
J3: USB-A-S-VT; CONN_USB-A-S-VT_ADM
J4: HDMI_A_1.4; AMPHENOL_10029449-111RLF; Part Description HDMI Connector, Right Angle, 19 Contact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
Module1: ComputeModule4-CM4; Raspberry-Pi-4-Compute-Module
R6: 100k; R_0402_1005Metric_Pad0.72x0.64mm_HandSolder
TP3: TestPoint; TestPoint_Pad_2.0x2.0mm
U4: PUSB3FR4; SOT1176-1
U5: NCP380HSN05AAT1G; TSOP-5_ONS

Connections:
/+3.3v: J1.2 (VCC_3V3), J1.4 (VCC_3V3), J1.12 (VCC_3V3), J1.14 (VCC_3V3), J1.16 (VCC_3V3), J1.18 (VCC_3V3), J1.70 (VCC_3V3), J1.72 (VCC_3V3), J1.74 (VCC_3V3); also elsewhere on the board
/CM4_HighSpeed/HDMI0_CEC: J4.13 (CEC), Module1.151 (HDMI0_CEC)
/CM4_HighSpeed/HDMI0_CK_N: J4.12 (CK-), Module1.190 (HDMI0_CLK_N)
/CM4_HighSpeed/HDMI0_CK_P: J4.10 (CK+), Module1.188 (HDMI0_CLK_P)
/CM4_HighSpeed/HDMI0_D0_N: J4.9 (D0-), Module1.184 (HDMI0_TX0_N)
/CM4_HighSpeed/HDMI0_D0_P: J4.7 (D0+), Module1.182 (HDMI0_TX0_P)
/CM4_HighSpeed/HDMI0_D1_N: J4.6 (D1-), Module1.178 (HDMI0_TX1_N)
/CM4_HighSpeed/HDMI0_D1_P: J4.4 (D1+), Module1.176 (HDMI0_TX1_P)
/CM4_HighSpeed/HDMI0_D2_N: J4.3 (D2-), Module1.172 (HDMI0_TX2_N)
/CM4_HighSpeed/HDMI0_D2_P: J4.1 (D2+), Module1.170 (HDMI0_TX2_P)
/CM4_HighSpeed/HDMI0_HOT: J4.19 (HPD/HEAC-), Module1.153 (HDMI0_HOTPLUG)
/CM4_HighSpeed/HDMI0_SCL: J4.15 (SCL), Module1.200 (HDMI0_SCL)
/CM4_HighSpeed/HDMI0_SDA: J4.16 (SDA), Module1.199 (HDMI0_SDA)
/CM4_HighSpeed/P_CLK_N: J1.53 (REF_CLK-), Module1.112 (PCIe_CLK_N)
/CM4_HighSpeed/P_CLK_P: J1.55 (REF_CLK+), Module1.110 (PCIe_CLK_P)
/CM4_HighSpeed/P_CLKnREQ: J1.52 (~PCIe_CLK_REQ), Module1.102 (PCIe_CLK_nREQ)
/CM4_HighSpeed/P_RST: J1.50 (~PCIe_RST), Module1.109 (PCIe_nRST)
/CM4_HighSpeed/P_RX0_N: J1.41 (PCIe_RX0-), Module1.118 (PCIe_RX_N)
/CM4_HighSpeed/P_RX0_P: J1.43 (PCIe_RX0+), Module1.116 (PCIe_RX_P)
/CM4_HighSpeed/P_TX0_N: J1.47 (PCIe_TX0-), Module1.124 (PCIe_TX_N)
/CM4_HighSpeed/P_TX0_P: J1.49 (PCIe_TX0+), Module1.122 (PCIe_TX_P)
GND: C1.2, C2.2, J1.1 (CONFIG_3), J1.3 (GND), J1.9 (GND), J1.15 (GND), J1.21 (CONFIG_0), J1.27 (GND), J1.33 (GND), J1.39 (GND), J1.45 (GND), J1.51 (GND), J1.57 (GND), J1.71 (GND), J1.73 (GND), J1.SH1 (SHIELD), J1.SH2 (SHIELD__1), J2.A1_B12 (GND), J2.B1_A12 (GND), J2.SH1 (SHELL_GND), J2.SH2 (SHELL_GND), J2.SH3 (SHELL_GND), J2.SH4 (SHELL_GND), J3.4, J4.2 (D2S), J4.5 (D1S), J4.8 (D0S), J4.11 (CKS), J4.17 (GND), J4.SH1 (SH), J4.SH2 (SH), J4.SH3 (SH), J4.SH4 (SH), Module1.107 (GND), Module1.108 (GND), Module1.113 (GND), Module1.114 (GND), Module1.119 (GND), Module1.120 (GND), Module1.125 (GND), Module1.126 (GND), Module1.131 (GND), Module1.132 (GND), Module1.137 (GND), Module1.138 (GND), Module1.144 (GND), Module1.150 (GND), Module1.155 (GND), Module1.156 (GND), Module1.161 (GND), Module1.162 (GND), Module1.167 (GND), Module1.168 (GND), Module1.173 (GND), Module1.174 (GND), Module1.179 (GND), Module1.180 (GND), Module1.185 (GND), Module1.186 (GND), Module1.191 (GND), Module1.192 (GND), Module1.197 (GND), Module1.198 (GND), U4.3 (GND), U4.8 (GND), U5.2 (GND); also elsewhere on the board
HDMI_5v: C2.1, J4.18 (+5V), TP3.1, U5.1 (OUT)
unnamed: R6.2, U5.3 (*FLAG)
USBD+: J2.A6 (DP1), J2.B6 (DP2), J3.3, Module1.105 (USB2_P), U4.4 (In_1+), U4.7 (Out_1+)
USBD-: J2.A7 (DN1), J2.B7 (DN2), J3.2, Module1.103 (USB2_N), U4.5 (In_1-), U4.6 (Out_1+)
USB_OTG: Module1.101 (USB_OTG_ID)
VBUS: C1.1, J2.A4_B9 (VBUS), J2.B4_A9 (VBUS), J3.1, R6.1, U4.1 (In_1+), U4.10 (Out_1+), U5.4 (EN), U5.5 (IN); also elsewhere on the board

Notes on the sheet:
USB ESD protection
Eventueel extra pull_up (word al intern gedaan)

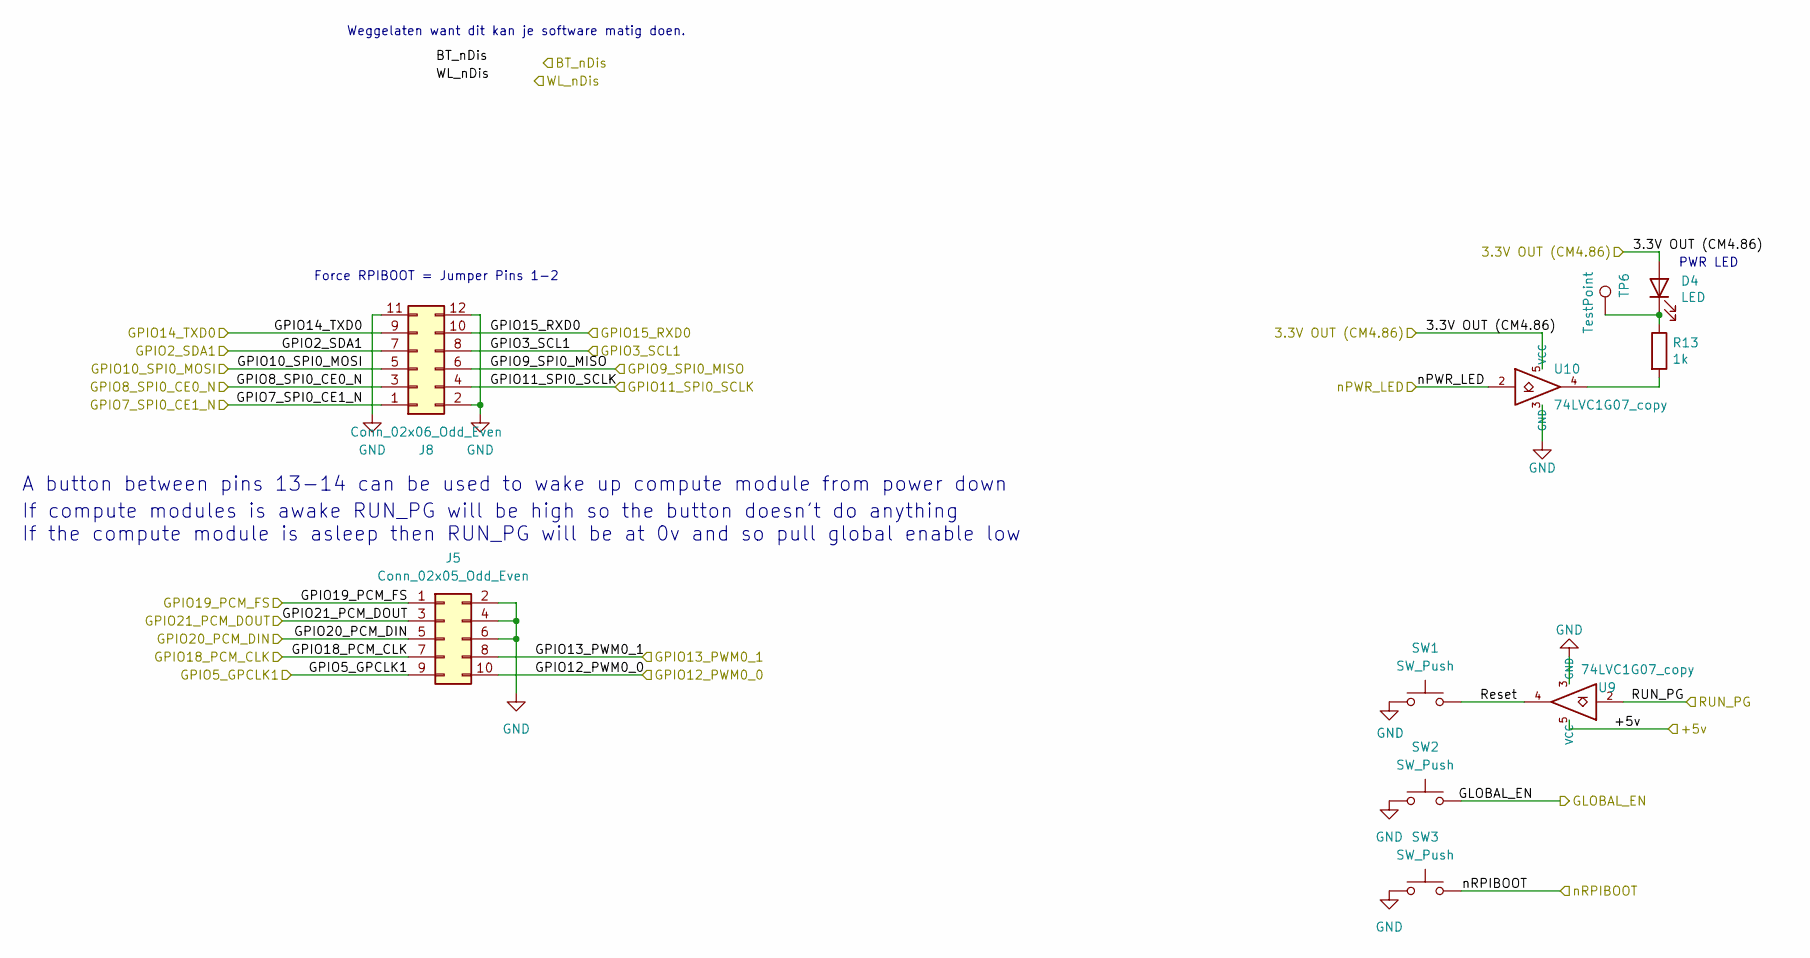
[picture p48: schematic miscellaneous .kicad_sch]

Parts:
D4: LED; LED_0603_1608Metric; Part Description Red 620nm LED Indication - Discrete 2.2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
J5: Conn_02x05_Odd_Even; PinHeader_2x05_P2.54mm_Vertical
J8: Conn_02x06_Odd_Even; PinHeader_2x06_P2.54mm_Vertical
R13: 1k; R_0402_1005Metric_Pad0.72x0.64mm_HandSolder; Part Description Resistor 1K M1005 1% 63mW
SW1, SW2, SW3: SW_Push; SW_SPST_TS-1088-xR020
TP6: TestPoint; TestPoint_Pad_2.0x2.0mm
U9, U10: 74LVC1G07_copy; SOT-353_SC-70-5; Part Description Buffer, Non-Inverting 1 Element 1 Bit p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

Connections:
/3.3V OUT (CM4.86): D4.2 (A), U10.5 (VCC); also elsewhere on the board
/CM4_LowSpeed/GLOBAL_EN: SW2.2; also elsewhere on the board
/CM4_LowSpeed/GPIO2_SDA1: J8.7; also elsewhere on the board
/CM4_LowSpeed/GPIO3_SCL1: J8.8; also elsewhere on the board
/CM4_LowSpeed/GPIO5_GPCLK1: J5.9; also elsewhere on the board
/CM4_LowSpeed/GPIO7_SPI0_CE1_N: J8.1; also elsewhere on the board
/CM4_LowSpeed/GPIO8_SPI0_CE0_N: J8.3; also elsewhere on the board
/CM4_LowSpeed/GPIO9_SPI0_MISO: J8.6; also elsewhere on the board
/CM4_LowSpeed/GPIO10_SPI0_MOSI: J8.5; also elsewhere on the board
/CM4_LowSpeed/GPIO11_SPI0_SCLK: J8.4; also elsewhere on the board
/CM4_LowSpeed/GPIO12_PWM0_0: J5.10; also elsewhere on the board
/CM4_LowSpeed/GPIO13_PWM0_1: J5.8; also elsewhere on the board
/CM4_LowSpeed/GPIO18_PCM_CLK: J5.7; also elsewhere on the board
/CM4_LowSpeed/GPIO19_PCM_FS: J5.1; also elsewhere on the board
/CM4_LowSpeed/GPIO20_PCM_DIN: J5.5; also elsewhere on the board
/CM4_LowSpeed/GPIO21_PCM_DOUT: J5.3; also elsewhere on the board
/CM4_LowSpeed/RUN_PG: U9.2; also elsewhere on the board
/CM4_LowSpeed/nPWR_LED: U10.2; also elsewhere on the board
/CM4_LowSpeed/nRPIBOOT: SW3.2; also elsewhere on the board
/GPIO14_TXD0: J8.9; also elsewhere on the board
/GPIO15_RXD0: J8.10; also elsewhere on the board
/Miscellaneous/Reset: SW1.2, U9.4
GND: J5.2, J5.4, J5.6, J8.2, J8.11, J8.12, SW1.1, SW2.1, SW3.1, U9.3 (GND), U10.3 (GND); also elsewhere on the board
unnamed: D4.1 (K), R13.1, TP6.1
unnamed: R13.2, U10.4
VBUS: U9.5 (VCC); also elsewhere on the board

Notes on the sheet:
A button between pins 13-14 can be used to wake up compute module from power down
If compute modules is awake RUN_PG will be high so the button doesn't do anything If the compute module is asleep then RUN_PG will be at 0v and so pull global enable low
Weggelaten want dit kan je software matig doen.
Force RPIBOOT = Jumper Pins 1-2
PWR LED

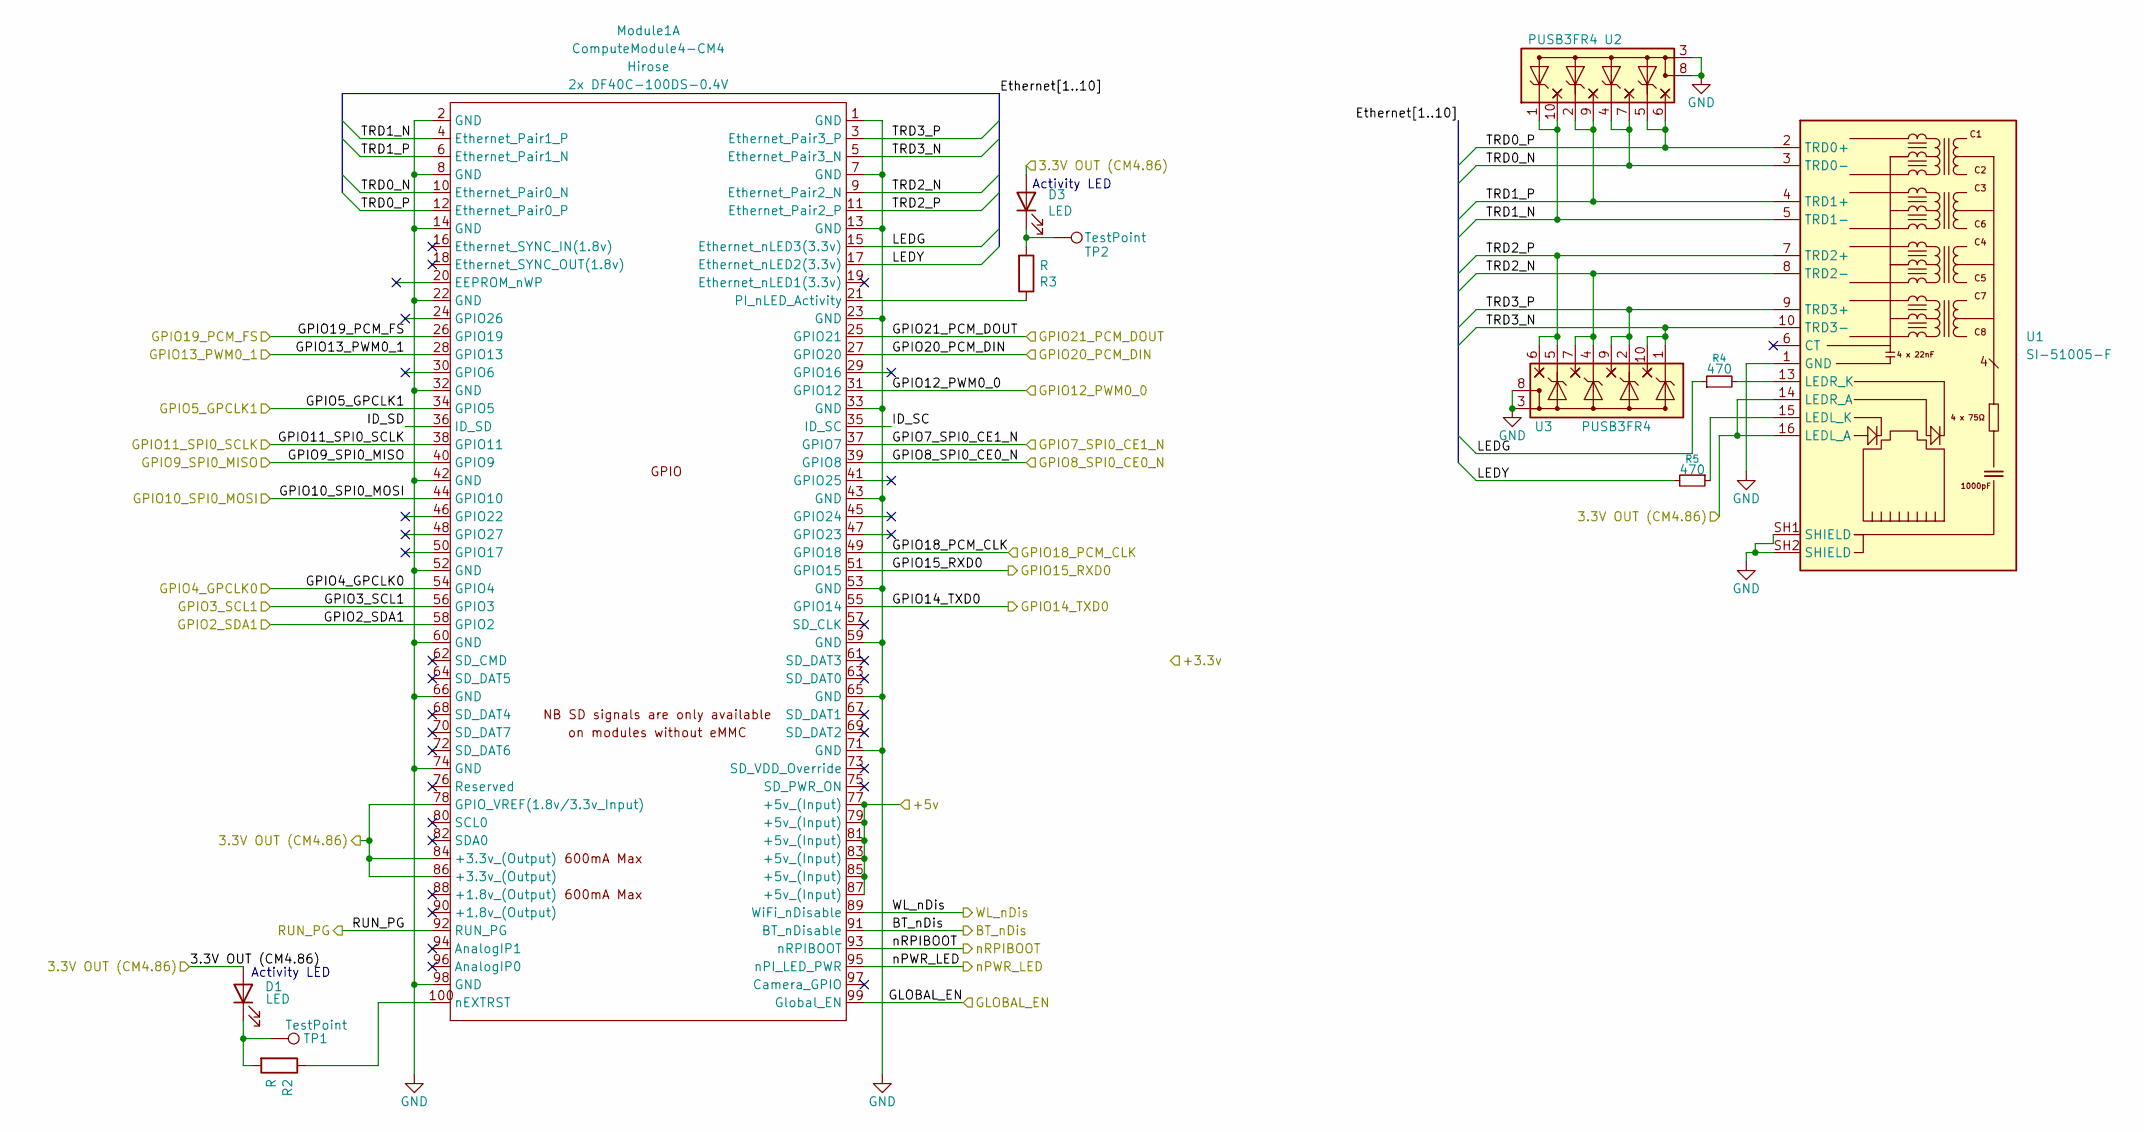
[picture p49: schematic CM4_GPIO.kicad_sch]

Parts:
D1, D3: LED; LED_0603_1608Metric; Part Description Green 572nm LED Indication - Discrete 2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
Module1: ComputeModule4-CM4; Raspberry-Pi-4-Compute-Module
R2, R3: R; R_0402_1005Metric_Pad0.72x0.64mm_HandSolder; Part Description Resistor 1K M1005 1% 63mW
R4, R5: 470; R_0402_1005Metric_Pad0.72x0.64mm_HandSolder
TP1, TP2: TestPoint; TestPoint_Pad_2.0x2.0mm
U1: SI-51005-F; BEL_SI-51005-F
U2, U3: PUSB3FR4; SOT1176-1

Connections:
/3.3V OUT (CM4.86): D1.2 (A), D3.2 (A), Module1.78 (GPIO_VREF(1.8v/3.3v_Input)), Module1.84 (+3.3v_(Output)), Module1.86 (+3.3v_(Output)), U1.14 (LEDR_A), U1.16 (LEDL_A); also elsewhere on the board
/CM4_LowSpeed/BT_nDis: Module1.91 (BT_nDisable)
/CM4_LowSpeed/GLOBAL_EN: Module1.99 (Global_EN); also elsewhere on the board
/CM4_LowSpeed/GPIO2_SDA1: Module1.58 (GPIO2); also elsewhere on the board
/CM4_LowSpeed/GPIO3_SCL1: Module1.56 (GPIO3); also elsewhere on the board
/CM4_LowSpeed/GPIO4_GPCLK0: Module1.54 (GPIO4)
/CM4_LowSpeed/GPIO5_GPCLK1: Module1.34 (GPIO5); also elsewhere on the board
/CM4_LowSpeed/GPIO7_SPI0_CE1_N: Module1.37 (GPIO7); also elsewhere on the board
/CM4_LowSpeed/GPIO8_SPI0_CE0_N: Module1.39 (GPIO8); also elsewhere on the board
/CM4_LowSpeed/GPIO9_SPI0_MISO: Module1.40 (GPIO9); also elsewhere on the board
/CM4_LowSpeed/GPIO10_SPI0_MOSI: Module1.44 (GPIO10); also elsewhere on the board
/CM4_LowSpeed/GPIO11_SPI0_SCLK: Module1.38 (GPIO11); also elsewhere on the board
/CM4_LowSpeed/GPIO12_PWM0_0: Module1.31 (GPIO12); also elsewhere on the board
/CM4_LowSpeed/GPIO13_PWM0_1: Module1.28 (GPIO13); also elsewhere on the board
/CM4_LowSpeed/GPIO18_PCM_CLK: Module1.49 (GPIO18); also elsewhere on the board
/CM4_LowSpeed/GPIO19_PCM_FS: Module1.26 (GPIO19); also elsewhere on the board
/CM4_LowSpeed/GPIO20_PCM_DIN: Module1.27 (GPIO20); also elsewhere on the board
/CM4_LowSpeed/GPIO21_PCM_DOUT: Module1.25 (GPIO21); also elsewhere on the board
/CM4_LowSpeed/ID_SC: Module1.35 (ID_SC)
/CM4_LowSpeed/ID_SD: Module1.36 (ID_SD)
/CM4_LowSpeed/LEDG: Module1.15 (Ethernet_nLED3(3.3v)), R4.1
/CM4_LowSpeed/LEDY: Module1.17 (Ethernet_nLED2(3.3v)), R5.2
/CM4_LowSpeed/RUN_PG: Module1.92 (RUN_PG); also elsewhere on the board
/CM4_LowSpeed/TRD0_N: Module1.10 (Ethernet_Pair0_N), U1.3 (TRD0-), U2.4 (In_1+), U2.7 (Out_1+)
/CM4_LowSpeed/TRD0_P: Module1.12 (Ethernet_Pair0_P), U1.2 (TRD0+), U2.5 (In_1-), U2.6 (Out_1+)
/CM4_LowSpeed/TRD1_N: Module1.4 (Ethernet_Pair1_P), U1.5 (TRD1-), U2.1 (In_1+), U2.10 (Out_1+)
/CM4_LowSpeed/TRD1_P: Module1.6 (Ethernet_Pair1_N), U1.4 (TRD1+), U2.2 (In_1-), U2.9 (Out_1+)
/CM4_LowSpeed/TRD2_N: Module1.9 (Ethernet_Pair2_N), U1.8 (TRD2-), U3.4 (In_1+), U3.7 (Out_1+)
/CM4_LowSpeed/TRD2_P: Module1.11 (Ethernet_Pair2_P), U1.7 (TRD2+), U3.5 (In_1-), U3.6 (Out_1+)
/CM4_LowSpeed/TRD3_N: Module1.5 (Ethernet_Pair3_N), U1.10 (TRD3-), U3.1 (In_1+), U3.10 (Out_1+)
/CM4_LowSpeed/TRD3_P: Module1.3 (Ethernet_Pair3_P), U1.9 (TRD3+), U3.2 (In_1-), U3.9 (Out_1+)
/CM4_LowSpeed/WL_nDis: Module1.89 (WiFi_nDisable)
/CM4_LowSpeed/nPWR_LED: Module1.95 (nPI_LED_PWR); also elsewhere on the board
/CM4_LowSpeed/nRPIBOOT: Module1.93 (nRPIBOOT); also elsewhere on the board
/GPIO14_TXD0: Module1.55 (GPIO14); also elsewhere on the board
/GPIO15_RXD0: Module1.51 (GPIO15); also elsewhere on the board
GND: Module1.1 (GND), Module1.2 (GND), Module1.7 (GND), Module1.8 (GND), Module1.13 (GND), Module1.14 (GND), Module1.22 (GND), Module1.23 (GND), Module1.32 (GND), Module1.33 (GND), Module1.42 (GND), Module1.43 (GND), Module1.52 (GND), Module1.53 (GND), Module1.59 (GND), Module1.60 (GND), Module1.65 (GND), Module1.66 (GND), Module1.71 (GND), Module1.74 (GND), Module1.98 (GND), U1.1 (GND), U1.SH1 (SHIELD), U1.SH2 (SHIELD), U2.3 (GND), U2.8 (GND), U3.3 (GND), U3.8 (GND); also elsewhere on the board
unnamed: D1.1 (K), R2.2, TP1.1
unnamed: D3.1 (K), R3.2, TP2.1
unnamed: Module1.21 (PI_nLED_Activity), R3.1
unnamed: Module1.100 (nEXTRST), R2.1
unnamed: R5.1, U1.15 (LEDL_K)
unnamed: R4.2, U1.13 (LEDR_K)
VBUS: Module1.77 (+5v_(Input)), Module1.79 (+5v_(Input)), Module1.81 (+5v_(Input)), Module1.83 (+5v_(Input)), Module1.85 (+5v_(Input)), Module1.87 (+5v_(Input)); also elsewhere on the board

Notes on the sheet:
Activity LED

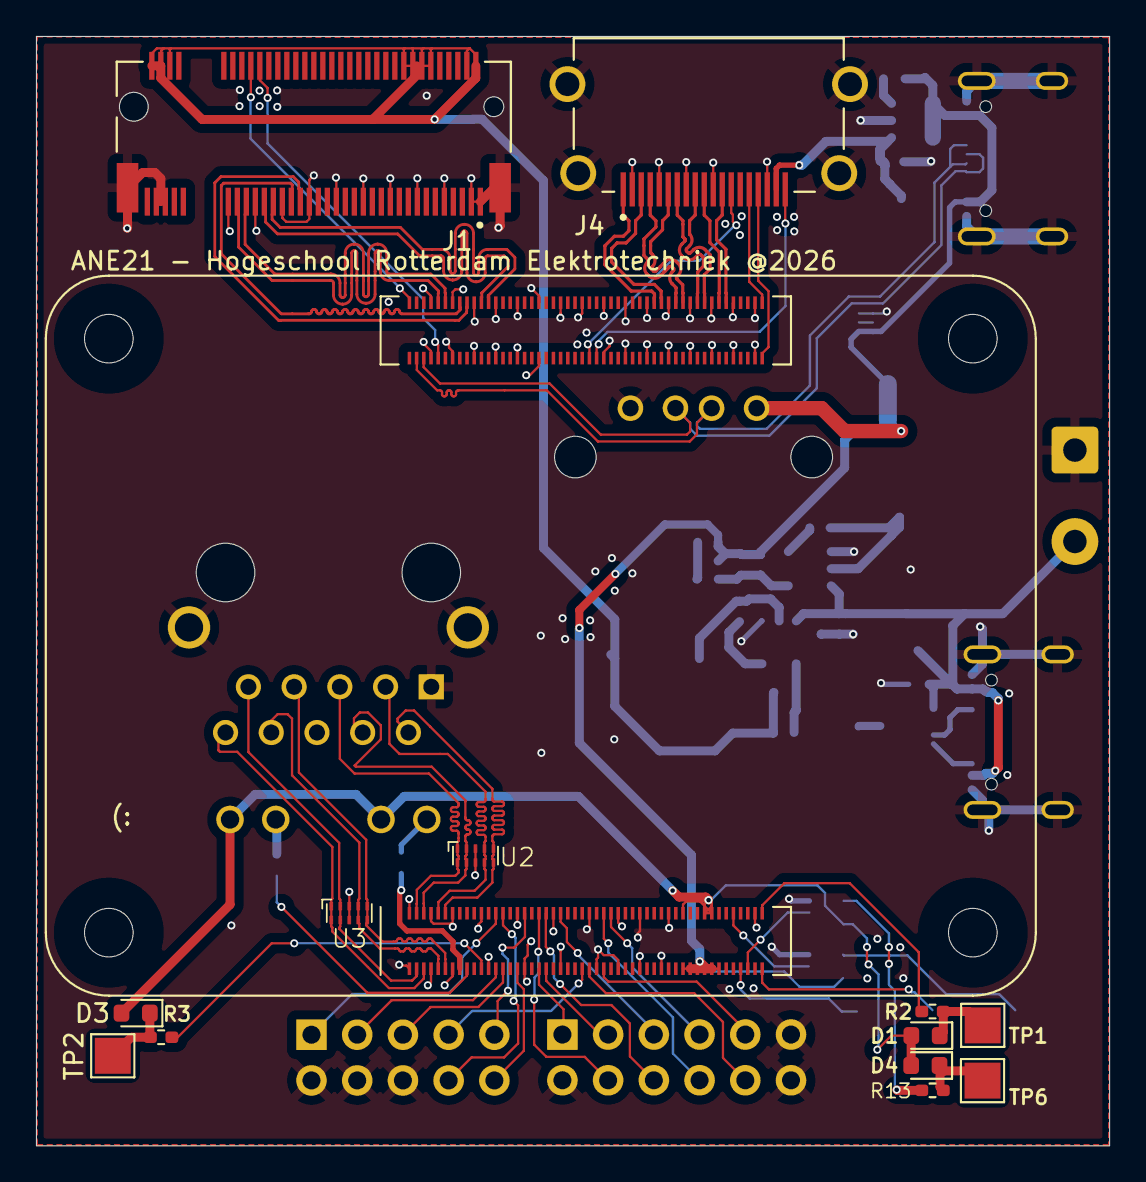
[picture p50: board ANE21_PCB.kicad_pcb from above]

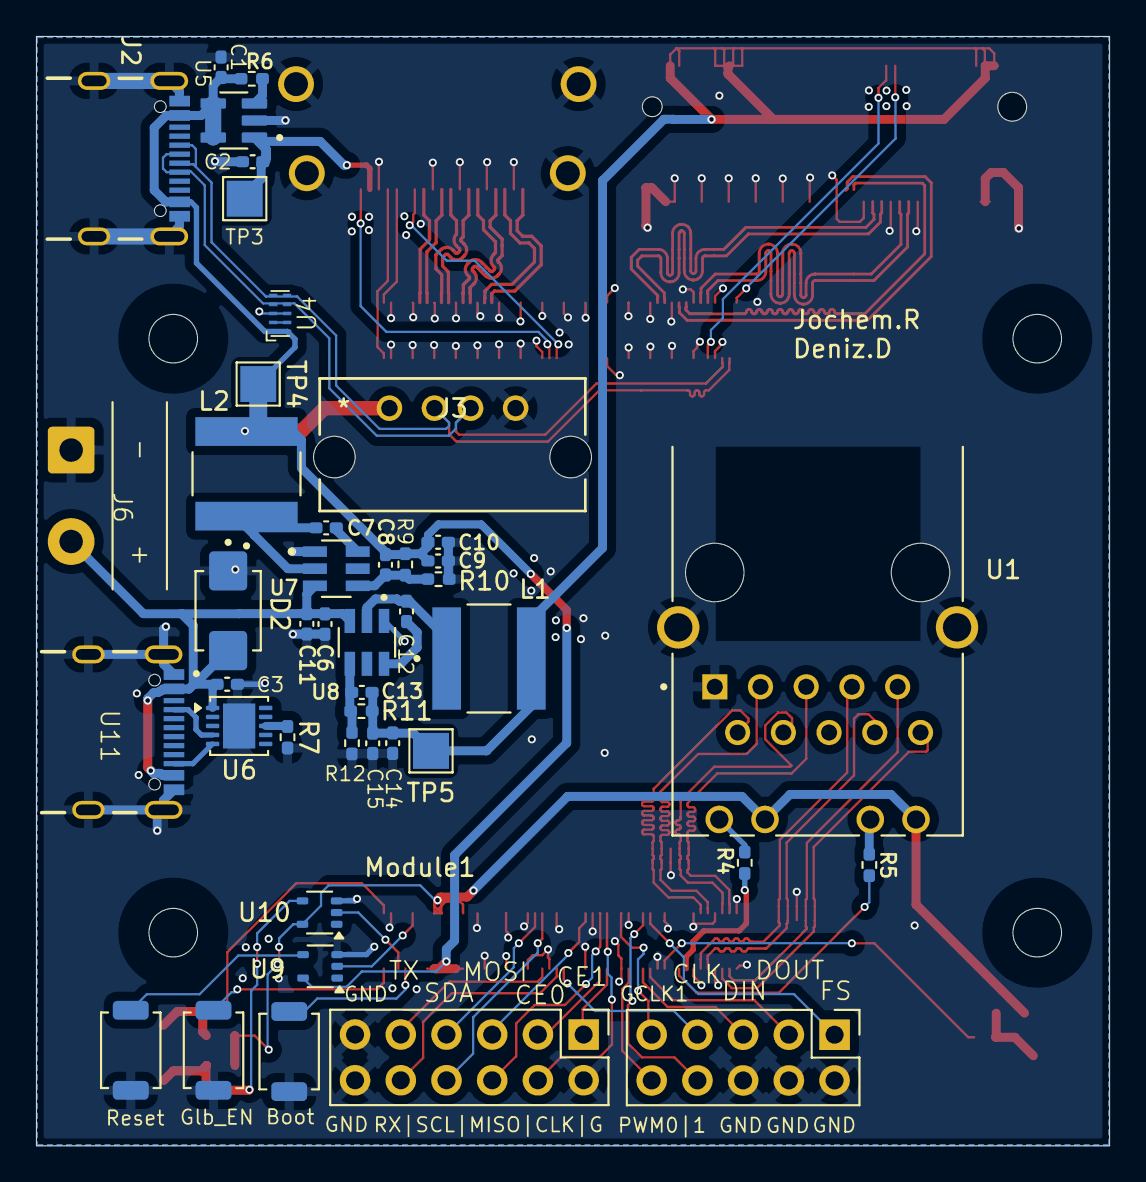
[picture p51: board ANE21_PCB.kicad_pcb from below]

Board: 4 copper layers, 59.6 x 61.6 mm, 58 parts (44 on the bottom side), 77 nets.

Other parts of the board:
U11: USB4105-GF-A-PD

Their connections:
CC1_U9: U11.A5 (CC1); also elsewhere on the board
CC2_U9: U11.B5 (CC2); also elsewhere on the board
GND: U11.A1_B12 (GND), U11.B1_A12 (GND), U11.SH1 (SHELL_GND), U11.SH2 (SHELL_GND), U11.SH3 (SHELL_GND), U11.SH4 (SHELL_GND); also elsewhere on the board
VBUS-PD: U11.A4_B9 (VBUS-PD), U11.B4_A9 (VBUS-PD); also elsewhere on the board
