flamaque/ANE21_PCB/(commit log)

2026-02-13 Added footprints and symbols
    Could not find -on SnapEDA- MCWR06X3322FTL, MCMR06X3162FTL and USB-A-S-VT.
    Power load switch NCP380HSN05AAT1G only had footprint on SnapEDA, no symbol.
    Need to update HMDI footprint and symbol to correct one.
    [1-2199119-5.step, 1255AY-3R3N_P3.step, ANE21_PCB.kicad_sch, CL10B104KO8NNNC.step, CL31B226KPHNNNE.step, CM4_GPIO.kicad_sch, CM4_HighSpeed.kicad_sch, GRM21BR71A106KA73L.step]
2026-02-23 Added symbol for Power switch and Word document replacing google docs
    [1-2199119-5.step, 1255AY-3R3N_P3.step, CL10B104KO8NNNC.step, CL31B226KPHNNNE.step, DF40C-100DS-0.4V_51_.step, GRM21BR71A106KA73L.step, NCP380HSN05AAT1G.step]
2026-03-03 Added footprints for PCIe and added busses for PCIe and Ethernet
    [ANE21_PCB.kicad_sch, CM4_GPIO.kicad_sch, CM4_HighSpeed.kicad_sch, Ethernet.kicad_sch]
2026-03-04 Moved PCIe psu to global psu schematic
    [ANE21_PCB.kicad_sch, PSUs.kicad_sch]
2026-03-05 Cleaned up schematics and added gnds and no-connects
    [ANE21_PCB.kicad_pcb, ANE21_PCB.kicad_sch, CM4_GPIO.kicad_sch, CM4_HighSpeed.kicad_sch, Ethernet.kicad_sch, PSUs.kicad_sch, RTC.kicad_sch, cm4-gpio.kicad_sch]
2026-03-05 Added USB-C footprint
2026-03-05 USB-c toegeveogd moet alleen nog omvormen
    [CM4_HighSpeed.kicad_sch, PSUs.kicad_sch]
2026-03-05 USB-C afgemaakt
    Ik heb hem apart gepusht. ik ga nu bezig zijn met de HDMI
    [PSUs.kicad_sch]
2026-03-05 Heb mijn documentatie geleverd voor de USB-c en heb een BOM toegevoegd
    [CM4_GPIO.kicad_sch, CM4_HighSpeed.kicad_sch, PSUs.kicad_sch]
2026-03-06 Added 3d-models, esd protection, cleaned up and made small start with pcb
    [10029449-111RLF--3DModel-STEP-269445.STEP, 10103593-0001LF--3DModel-STEP-510211.STEP, 74LVC1G07SE-7.step, ANE21_PCB.kicad_pcb, ANE21_PCB.kicad_sch, CM4_GPIO.kicad_sch, CM4_HighSpeed.kicad_sch, DF40C-100DS.stp]
2026-03-06 Adjusted the PCB design, changed footprints to 0402 (temp)
    [ANE21_PCB.kicad_pcb, CM4_GPIO.kicad_sch, CM4_HighSpeed.kicad_sch, PSUs.kicad_sch]
2026-03-07 Adjusted netclasses to route differential pairs for PCIe and HDMI. And used JLCPCB to adjust trace width for those
    [ANE21_PCB.kicad_pcb, CM4_HighSpeed.kicad_sch, PSUs.kicad_sch]
2026-03-07 heb de GPIO aangepast.
    Laten we morgen de stand van zaken bespreken. En overleggen wat we kunnen doen
    [ANE21_PCB.kicad_pcb, ANE21_PCB.kicad_sch, CM4_GPIO.kicad_sch, CM4_HighSpeed.kicad_sch]
2026-03-08 Added HDMI traces but have not checked them
    [ANE21_PCB.kicad_pcb]
2026-03-08 Added lots and lots of traces in PCB design.
    [2036150003.stp, ANE21_PCB.kicad_pcb, CM4_GPIO.kicad_sch, CM4_HighSpeed.kicad_sch, PSUs.kicad_sch]
2026-03-08 PCB is af. kan je het nog checken?
    [ANE21_PCB.kicad_pcb]
2026-03-08 Redid the routing and fixed ERC warnings
    [ANE21_PCB.kicad_pcb, ANE21_PCB.kicad_sch, CM4_GPIO.kicad_sch, CM4_HighSpeed.kicad_sch, PSUs.kicad_sch, miscellaneous .kicad_sch]
2026-03-08 Small changes to routes
    [ANE21_PCB.kicad_pcb]
2026-03-08 definitief ingelverd
    [ANE21_PCB.kicad_pcb, SS-52400-004.stl, SS-52400-004.stp]
2026-03-10 Redid traces with correct requirements, needs double checking.
    [ANE21_PCB.kicad_pcb, ANE21_PCB.kicad_sch, CM4_GPIO.kicad_sch, CM4_HighSpeed.kicad_sch, PSUs.kicad_sch, miscellaneous .kicad_sch]
2026-03-12 Very small changes made, dunno what
    [ANE21_PCB.kicad_pcb]
2026-03-12 Adjusted 3.3v for CM4 3.3v output, PCIe stayed the same.
    [ANE21_PCB-CuBottom.gbr, ANE21_PCB-CuIn1.gbr, ANE21_PCB-CuIn2.gbr, ANE21_PCB-CuTop.gbr, ANE21_PCB-EdgeCuts.gbr, ANE21_PCB-MaskBottom.gbr, ANE21_PCB-MaskTop.gbr, ANE21_PCB-NPTH.drl]
2026-03-13 Hehe, smol board now
    [ANE21_PCB.kicad_pcb, CM4_GPIO.kicad_sch, CM4_HighSpeed.kicad_sch, PSUs.kicad_sch, USB-C31-A-D-VT-CS1.STEP, USB-C31-A-D-VT-CS1.step]
2026-03-20 heb een kleine tabel gemaakt met de pins
2026-03-25 Changed quite a bit, PCB smoll now
    Redid all traces, replaced HUSB238 with ch224k, made PCB even smaller.
    [1-2199119-5.step, 10029449-111RLF--3DModel-STEP-269445.STEP, 10103593-0001LF--3DModel-STEP-510211.STEP, 1255AY-3R3N_P3.step, 74LVC1G07SE-7.step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]
2026-03-26 Changed PD back to HUSB238
    [1255AY-3R3N_P3.step, 1734366-1.STEP, 5991 HUSB238 USBC.f3d, 5991 HUSB238 USBC.step, 5991 HUSB238 USBC.stl, ANE21_PCB.kicad_pcb, HUSB238_USBC.step, PSUs.kicad_sch]
2026-03-28 Adjusted footprint Phoenix connector and added some text.
    [ANE21_PCB.kicad_pcb, PSUs.kicad_sch]
2026-03-30 gerber files gemaakt
    [ANE21_PCB-B_Cu.gbr, ANE21_PCB-B_Mask.gbr, ANE21_PCB-B_Paste.gbr, ANE21_PCB-B_Silkscreen.gbr, ANE21_PCB-Edge_Cuts.gbr, ANE21_PCB-F_Cu.gbr, ANE21_PCB-F_Mask.gbr, ANE21_PCB-F_Paste.gbr]
2026-04-02 Added datasheets for to-be-ordered components, double checked BOM
    [ANE21_PCB.csv, ANE21_PCB.csv.xlsx, ANE21_PCB_NogTeHalen.csv.xlsx, CM4_GPIO.kicad_sch, CM4_HighSpeed.kicad_sch, PSUs.kicad_sch, SMBJ15A.STEP, miscellaneous .kicad_sch]
2026-04-20 Can't remember
    [ANE21_PCB.kicad_pcb, ANE21_PCB_NogTeHalen.csv.xlsx, cm4.stl(1).stl]
