flamaque/ANE21_PCB/(notices)

Notices in the files:
rpi-cm4-carrier-template-main/hardware/rpi-cm4-carrier-template/cm4-high-speed.kicad_sch:
creativecommons.org/licenses/by-sa/4.0
License: CC BY 4.0
rpi-cm4-carrier-template-main/hardware/rpi-cm4-carrier-template/rpi-cm4-carrier-template.kicad_pcb:
creativecommons.org/licenses/by/4.0
CM4IOv5.kicad_sch:
© 2020-2022 Raspberry Pi Ltd (formerly Raspberry Pi (Trading) Ltd.)
SS-52400-004 (USB-c connector)/PARTserver22026030614434013911060d0b6156e/SS-52400-004.stp:
author */ ('License CC BY-ND 4.0'),
